KarpelesLab/odock/docs/images/odock-10-bottom.png

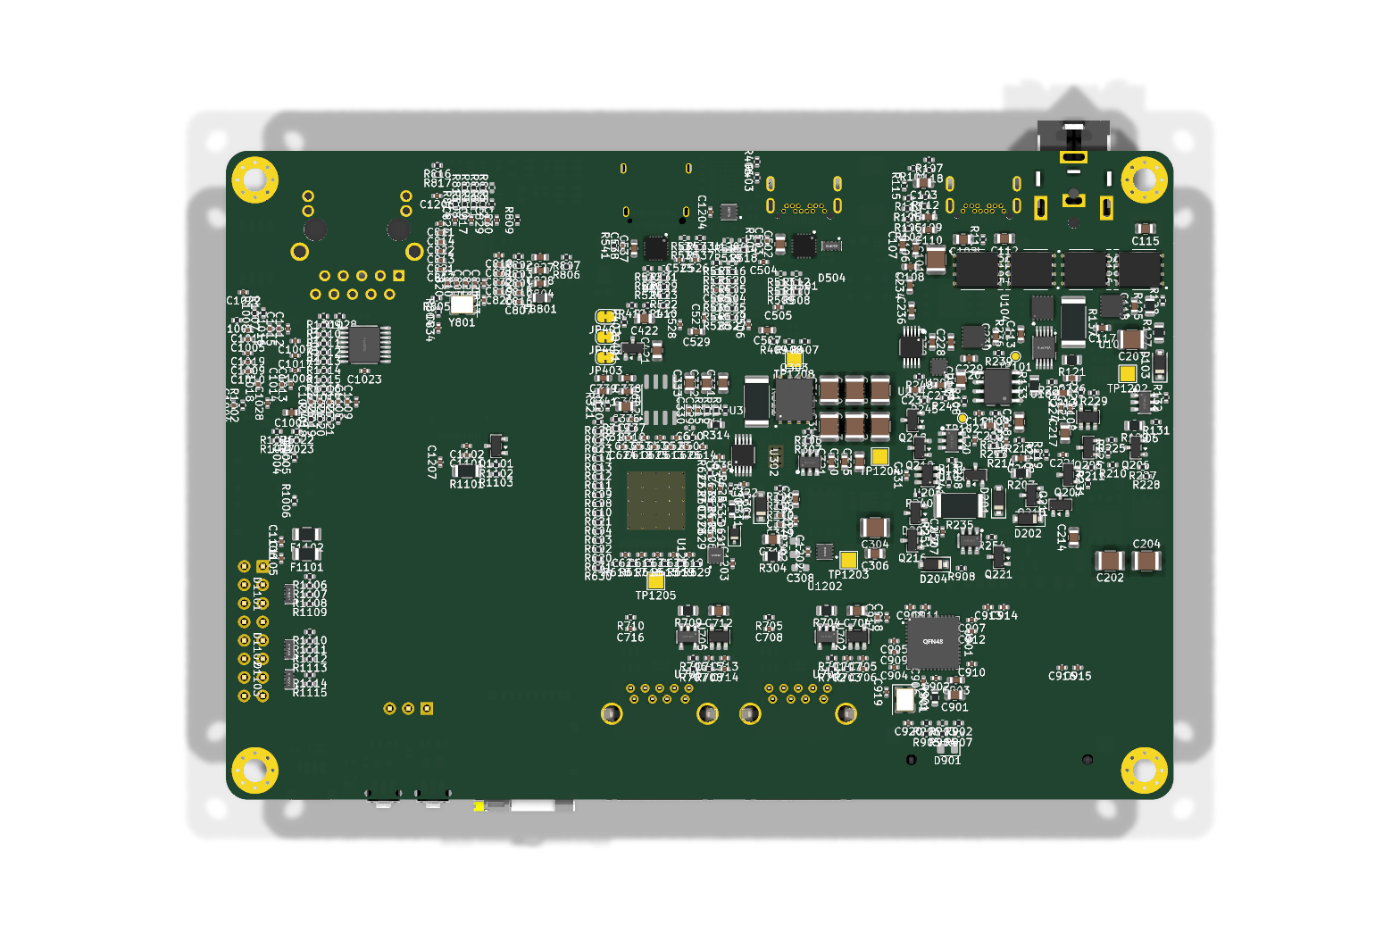
docs/images/odock-10-bottom.png
