KarpelesLab/odock/docs/images/odock-10-top.png

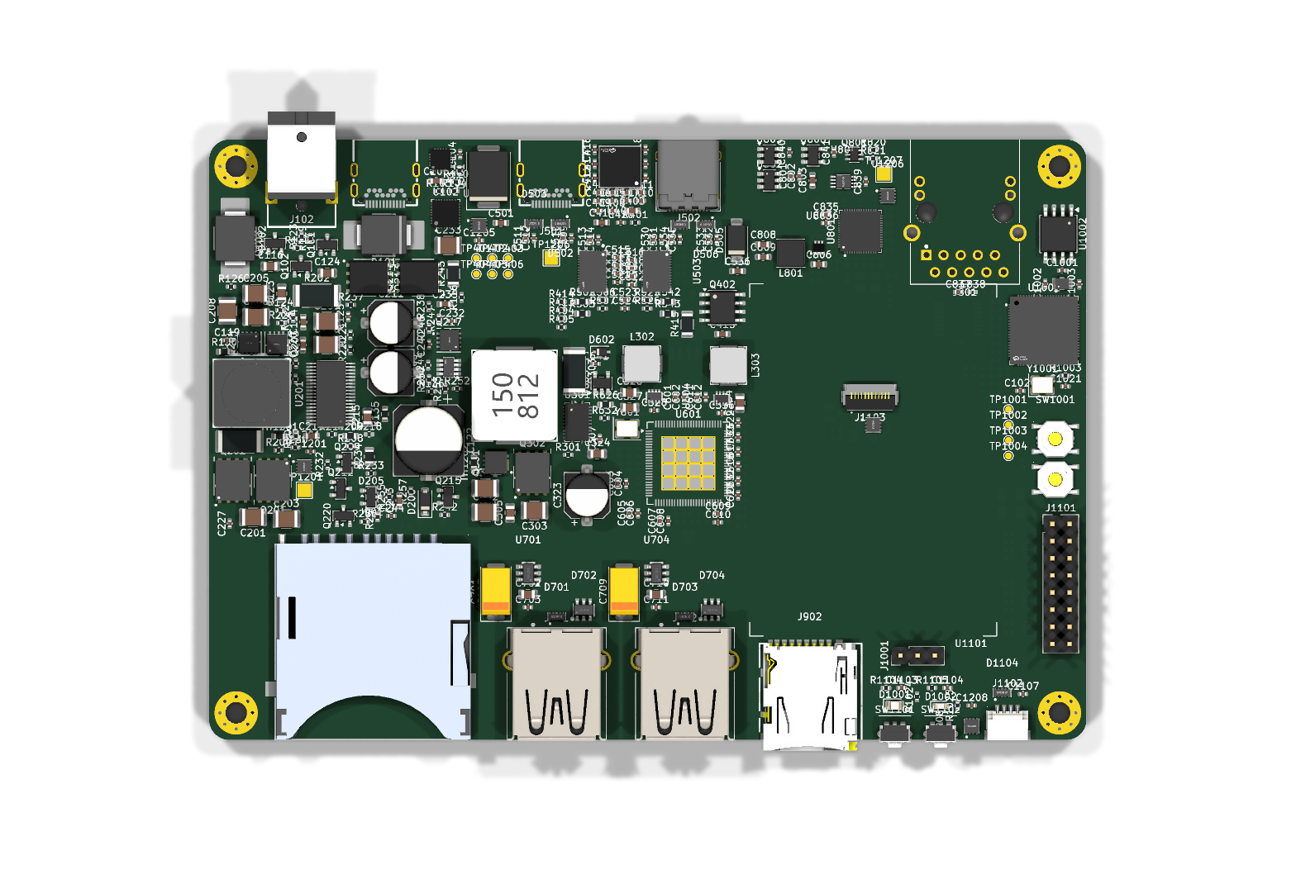
docs/images/odock-10-top.png
