KarpelesLab/odock/hardware/odock-10/odock-10.kicad_pcb

## KiCad design hardware/odock-10/odock-10.kicad_pcb (2026-10-17)

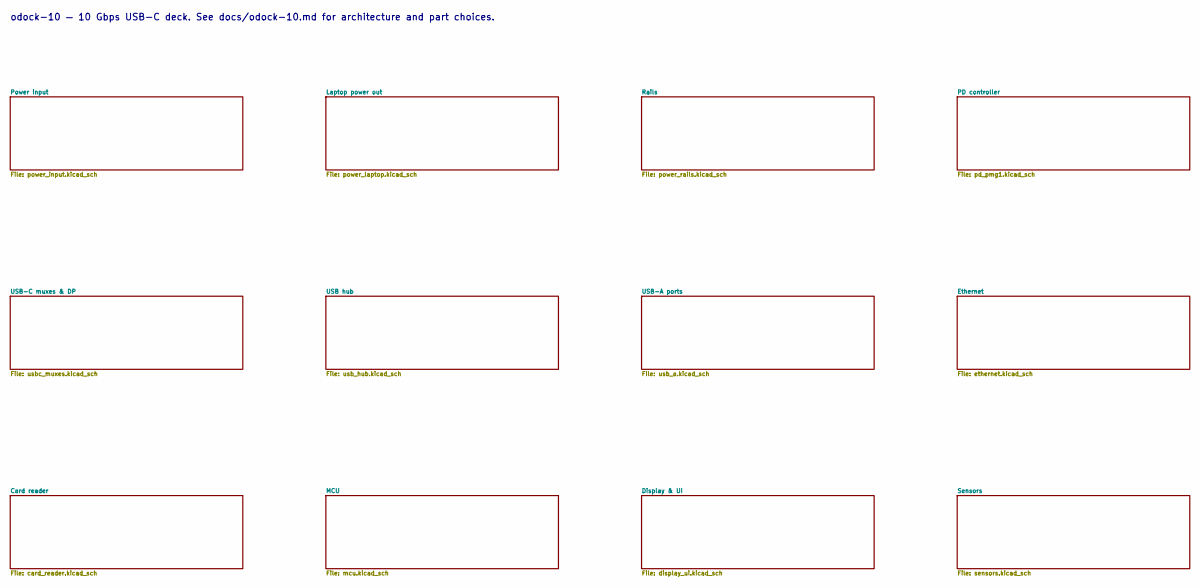
[picture p4: schematic odock-10.kicad_sch]

Notes on the sheet:
odock-10 — 10 Gbps USB-C deck. See docs/odock-10.md for architecture and part choices.

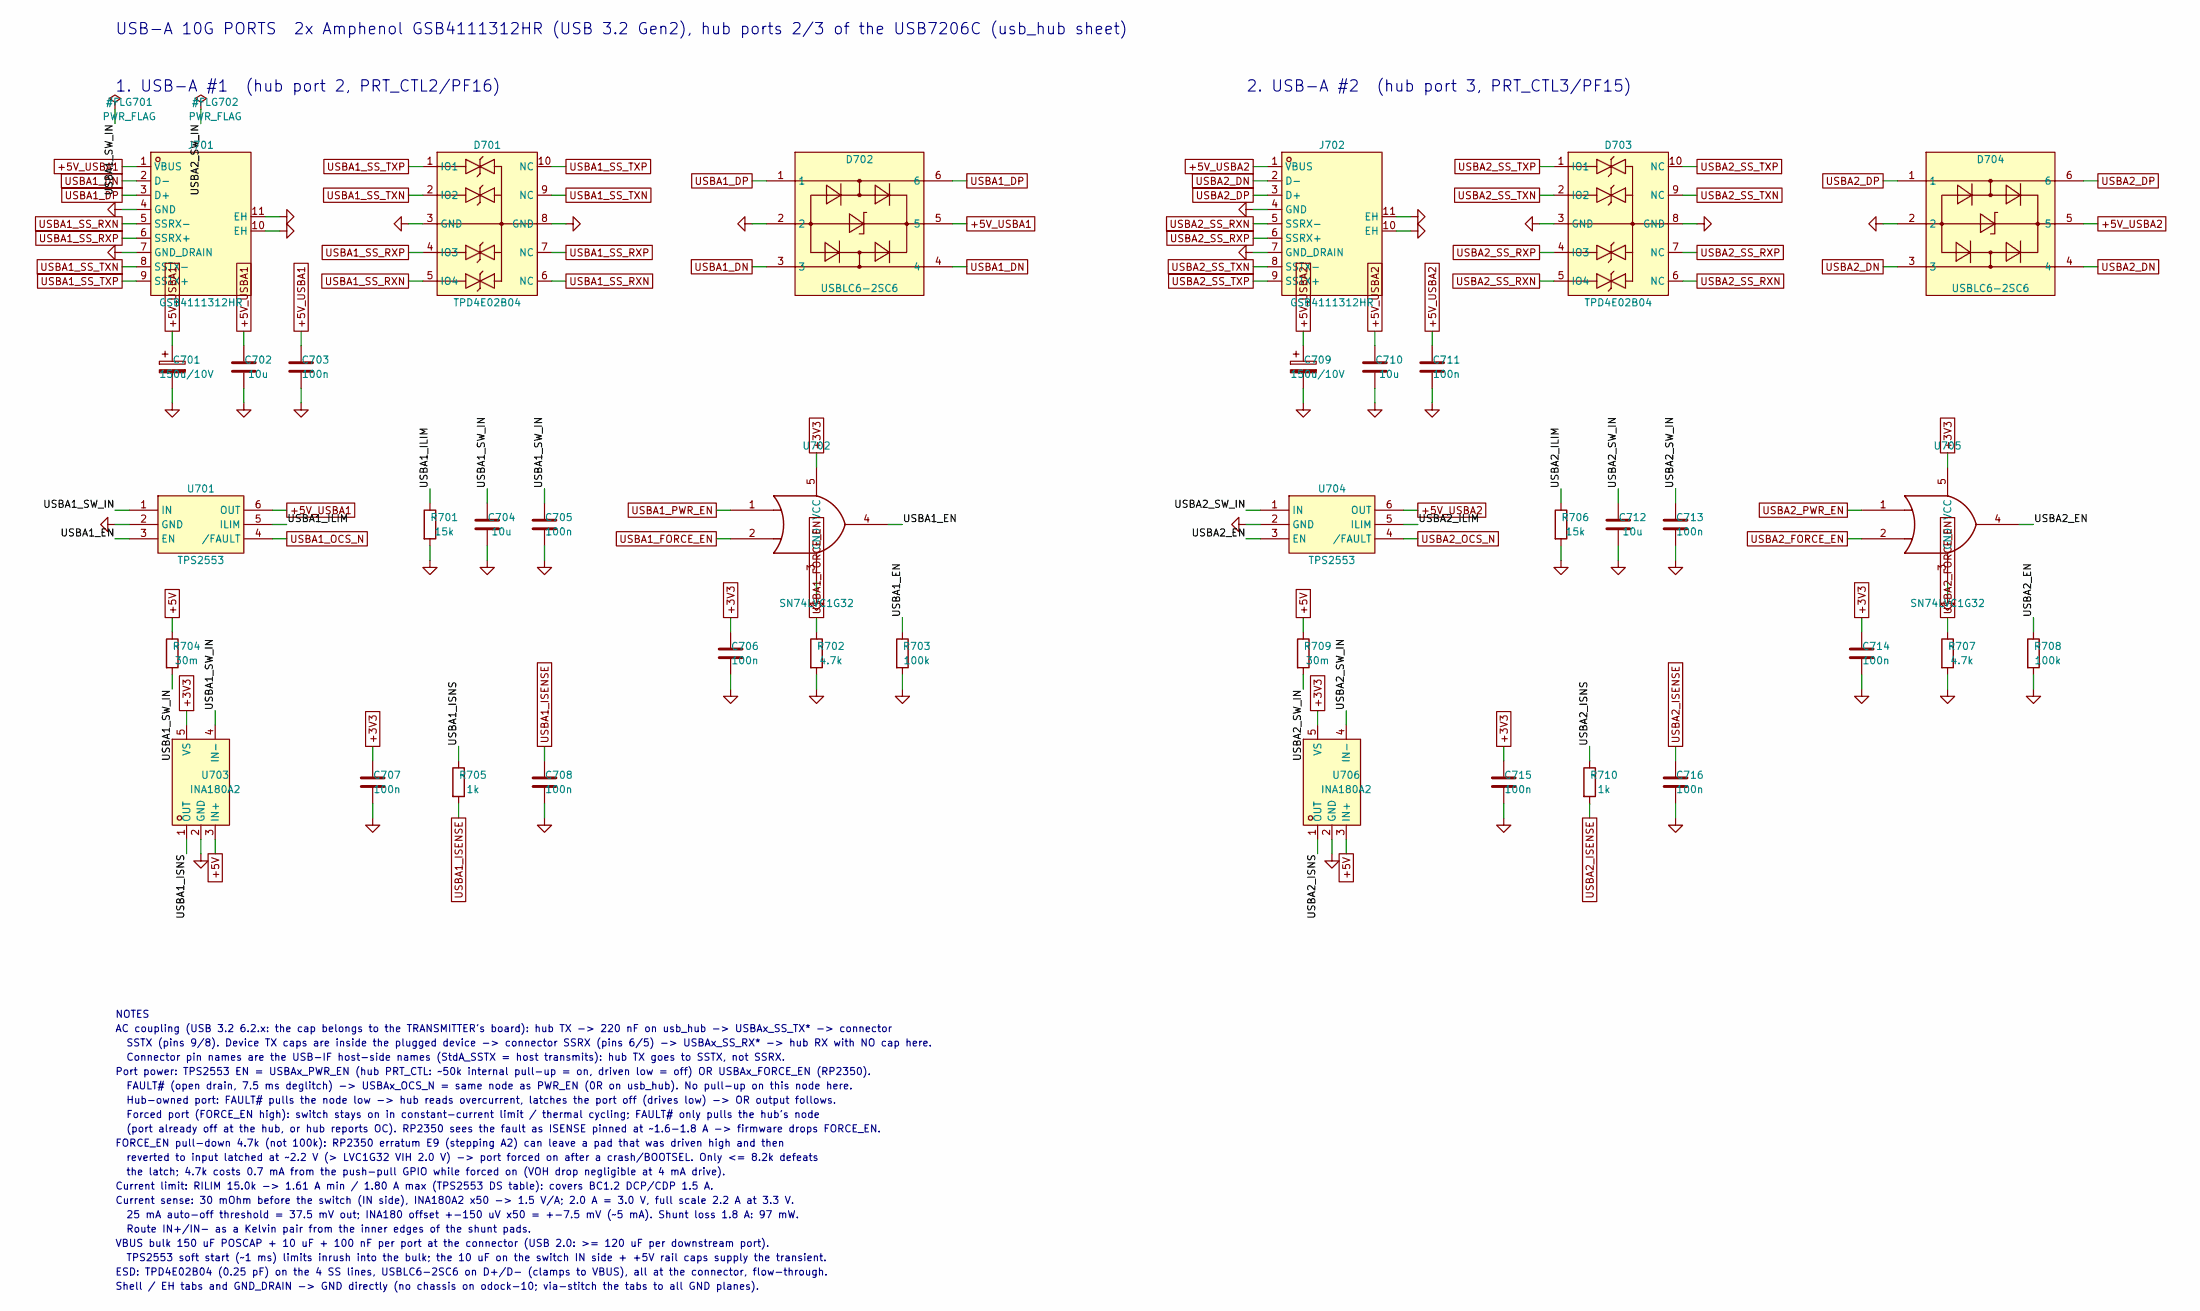
[picture p5: schematic usb_a.kicad_sch, odock-10 — USB-A 10 Gbps ports (2x), port power, current se…]

Parts:
C701, C709: 150u/10V; CP_EIA-7343-31_Kemet-D; LCSC C347559
C702, C704, C710, C712: 10u; C_0805_2012Metric; LCSC C15850
C703, C705, C706, C707, C708, C711, C713, C714, C715, C716: 100n; C_0402_1005Metric; LCSC C1525
D701, D703: TPD4E02B04; USON-10_L2.5-W1.0-P0.50-BL; MPN TPD4E02B04DQAR; LCSC C106794
D702, D704: USBLC6-2SC6; SOT-23-6_L2.9-W1.6-P0.95-LS2.8-BL; MPN USBLC6-2SC6; LCSC C7519
J701, J702: GSB4111312HR; USB-A_Amphenol_GSB4111312HR; MPN GSB4111312HR; LCSC C5429382
R701, R706: 15k; R_0402_1005Metric; LCSC C25756
R702, R707: 4.7k; R_0402_1005Metric; LCSC C25900
R703, R708: 100k; R_0402_1005Metric; LCSC C25741
R704, R709: 30m; R_0805_2012Metric; LCSC C858599
R705, R710: 1k; R_0402_1005Metric; LCSC C11702
U701, U704: TPS2553; SOT-23-6_L2.9-W1.6-P0.95-LS2.8-BR; MPN TPS2553DBVR; LCSC C55266
U702, U705: SN74LVC1G32; SOT-23-5; LCSC C10096
U703, U706: INA180A2; SOT-23-5_L3.0-W1.7-P0.95-LS2.8-BL; MPN INA180A2IDBVR; LCSC C192764

Connections:
+3V3: C706.1, C707.1, C714.1, C715.1, U702.5 (VCC), U703.5 (VS), U705.5 (VCC), U706.5 (VS); also elsewhere on the board
+5V: R704.1, R709.1, U703.3 (IN+), U706.3 (IN+); also elsewhere on the board
+5V_USBA1: C701.1, C702.1, C703.1, D702.5, J701.1 (VBUS), U701.6 (OUT)
+5V_USBA2: C709.1, C710.1, C711.1, D704.5, J702.1 (VBUS), U704.6 (OUT)
/USB-A ports/USBA1_EN: R703.1, U701.3 (EN), U702.4
/USB-A ports/USBA1_ILIM: R701.1, U701.5 (ILIM)
/USB-A ports/USBA1_ISNS: R705.1, U703.1 (OUT)
/USB-A ports/USBA1_SW_IN: C704.1, C705.1, R704.2, U701.1 (IN), U703.4 (IN-)
/USB-A ports/USBA2_EN: R708.1, U704.3 (EN), U705.4
/USB-A ports/USBA2_ILIM: R706.1, U704.5 (ILIM)
/USB-A ports/USBA2_ISNS: R710.1, U706.1 (OUT)
/USB-A ports/USBA2_SW_IN: C712.1, C713.1, R709.2, U704.1 (IN), U706.4 (IN-)
GND: C701.2, C702.2, C703.2, C704.2, C705.2, C706.2, C707.2, C708.2, C709.2, C710.2, C711.2, C712.2, C713.2, C714.2, C715.2, C716.2, D701.3 (GND), D701.8 (GND), D702.2, D703.3 (GND), D703.8 (GND), D704.2, J701.4 (GND), J701.7 (GND_DRAIN), J701.10 (EH), J701.11 (EH), J702.4 (GND), J702.7 (GND_DRAIN), J702.10 (EH), J702.11 (EH), R701.2, R702.2, R703.2, R706.2, R707.2, R708.2, U701.2 (GND), U702.3 (GND), U703.2 (GND), U704.2 (GND), U705.3 (GND), U706.2 (GND); also elsewhere on the board
USBA1_DN: D702.3, D702.4, J701.2 (D-); also elsewhere on the board
USBA1_DP: D702.1, D702.6, J701.3 (D+); also elsewhere on the board
USBA1_FORCE_EN: R702.1, U702.2; also elsewhere on the board
USBA1_ISENSE: C708.1, R705.2; also elsewhere on the board
USBA1_OCS_N: U701.4 (/FAULT); also elsewhere on the board
USBA1_PWR_EN: U702.1; also elsewhere on the board
USBA1_SS_RXN: D701.5 (IO4), D701.6 (NC), J701.5 (SSRX-); also elsewhere on the board
USBA1_SS_RXP: D701.4 (IO3), D701.7 (NC), J701.6 (SSRX+); also elsewhere on the board
USBA1_SS_TXN: D701.2 (IO2), D701.9 (NC), J701.8 (SSTX-); also elsewhere on the board
USBA1_SS_TXP: D701.1 (IO1), D701.10 (NC), J701.9 (SSTX+); also elsewhere on the board
USBA2_DN: D704.3, D704.4, J702.2 (D-); also elsewhere on the board
USBA2_DP: D704.1, D704.6, J702.3 (D+); also elsewhere on the board
USBA2_FORCE_EN: R707.1, U705.2; also elsewhere on the board
USBA2_ISENSE: C716.1, R710.2; also elsewhere on the board
USBA2_OCS_N: U704.4 (/FAULT); also elsewhere on the board
USBA2_PWR_EN: U705.1; also elsewhere on the board
USBA2_SS_RXN: D703.5 (IO4), D703.6 (NC), J702.5 (SSRX-); also elsewhere on the board
USBA2_SS_RXP: D703.4 (IO3), D703.7 (NC), J702.6 (SSRX+); also elsewhere on the board
USBA2_SS_TXN: D703.2 (IO2), D703.9 (NC), J702.8 (SSTX-); also elsewhere on the board
USBA2_SS_TXP: D703.1 (IO1), D703.10 (NC), J702.9 (SSTX+); also elsewhere on the board

Notes on the sheet:
USB-A 10G PORTS 2x Amphenol GSB4111312HR (USB 3.2 Gen2), hub ports 2/3 of the USB7206C (usb_hub sheet)
1. USB-A #1 (hub port 2, PRT_CTL2/PF16)
2. USB-A #2 (hub port 3, PRT_CTL3/PF15)
NOTES
AC coupling (USB 3.2 6.2.x: the cap belongs to the TRANSMITTER's board): hub TX -> 220 nF on usb_hub -> USBAx_SS_TX* -> connector
SSTX (pins 9/8). Device TX caps are inside the plugged device -> connector SSRX (pins 6/5) -> USBAx_SS_RX* -> hub RX with NO cap here.
Connector pin names are the USB-IF host-side names (StdA_SSTX = host transmits): hub TX goes to SSTX, not SSRX.
Port power: TPS2553 EN = USBAx_PWR_EN (hub PRT_CTL: ~50k internal pull-up = on, driven low = off) OR USBAx_FORCE_EN (RP2350).
FAULT# (open drain, 7.5 ms deglitch) -> USBAx_OCS_N = same node as PWR_EN (0R on usb_hub). No pull-up on this node here.
Hub-owned port: FAULT# pulls the node low -> hub reads overcurrent, latches the port off (drives low) -> OR output follows.
Forced port (FORCE_EN high): switch stays on in constant-current limit / thermal cycling; FAULT# only pulls the hub's node
(port already off at the hub, or hub reports OC). RP2350 sees the fault as ISENSE pinned at ~1.6-1.8 A -> firmware drops FORCE_EN.
FORCE_EN pull-down 4.7k (not 100k): RP2350 erratum E9 (stepping A2) can leave a pad that was driven high and then
reverted to input latched at ~2.2 V (> LVC1G32 VIH 2.0 V) -> port forced on after a crash/BOOTSEL. Only <= 8.2k defeats
the latch; 4.7k costs 0.7 mA from the push-pull GPIO while forced on (VOH drop negligible at 4 mA drive).
Current limit: RILIM 15.0k -> 1.61 A min / 1.80 A max (TPS2553 DS table): covers BC1.2 DCP/CDP 1.5 A.
Current sense: 30 mOhm before the switch (IN side), INA180A2 x50 -> 1.5 V/A; 2.0 A = 3.0 V, full scale 2.2 A at 3.3 V.
25 mA auto-off threshold = 37.5 mV out; INA180 offset +-150 uV x50 = +-7.5 mV (~5 mA). Shunt loss 1.8 A: 97 mW.
Route IN+/IN- as a Kelvin pair from the inner edges of the shunt pads.
VBUS bulk 150 uF POSCAP + 10 uF + 100 nF per port at the connector (USB 2.0: >= 120 uF per downstream port).
TPS2553 soft start (~1 ms) limits inrush into the bulk; the 10 uF on the switch IN side + +5V rail caps supply the transient.
ESD: TPD4E02B04 (0.25 pF) on the 4 SS lines, USBLC6-2SC6 on D+/D- (clamps to VBUS), all at the connector, flow-through.
Shell / EH tabs and GND_DRAIN -> GND directly (no chassis on odock-10; via-stitch the tabs to all GND planes).

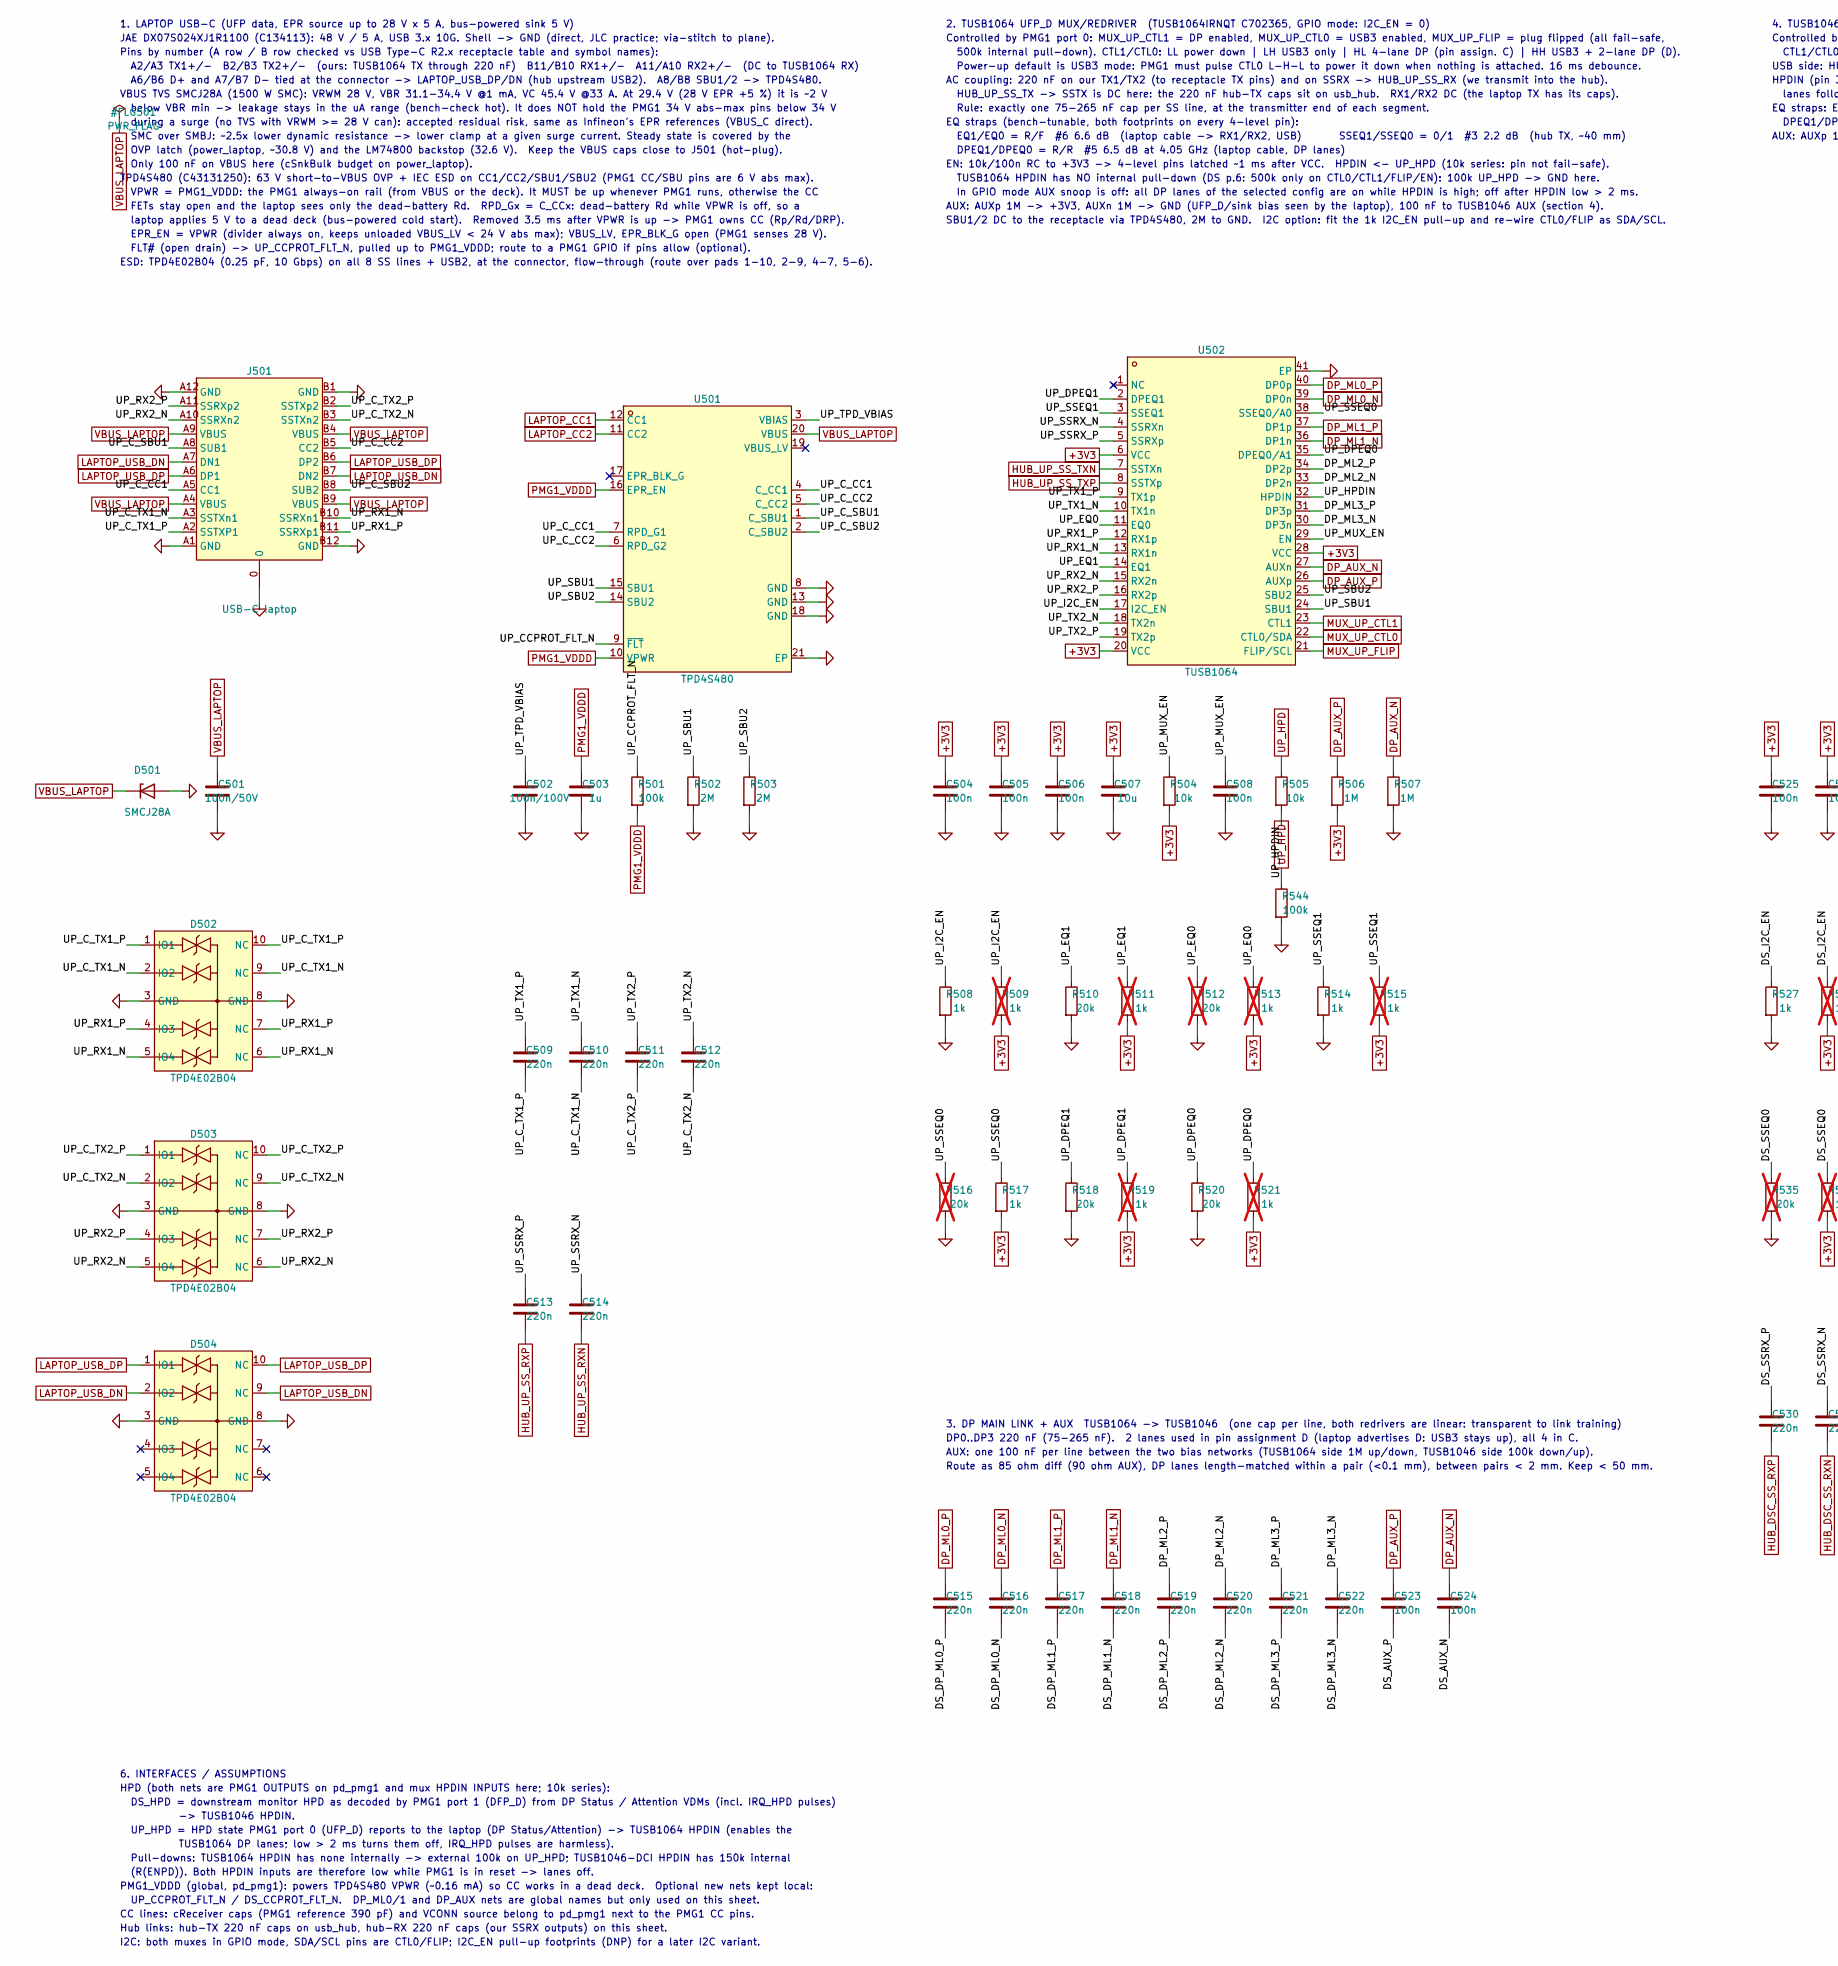
[picture p6: schematic usbc_muxes.kicad_sch, odock-10 — USB-C ports, TUSB1064 / TUSB1046 alt-mode muxes, part in row 1, column 1]

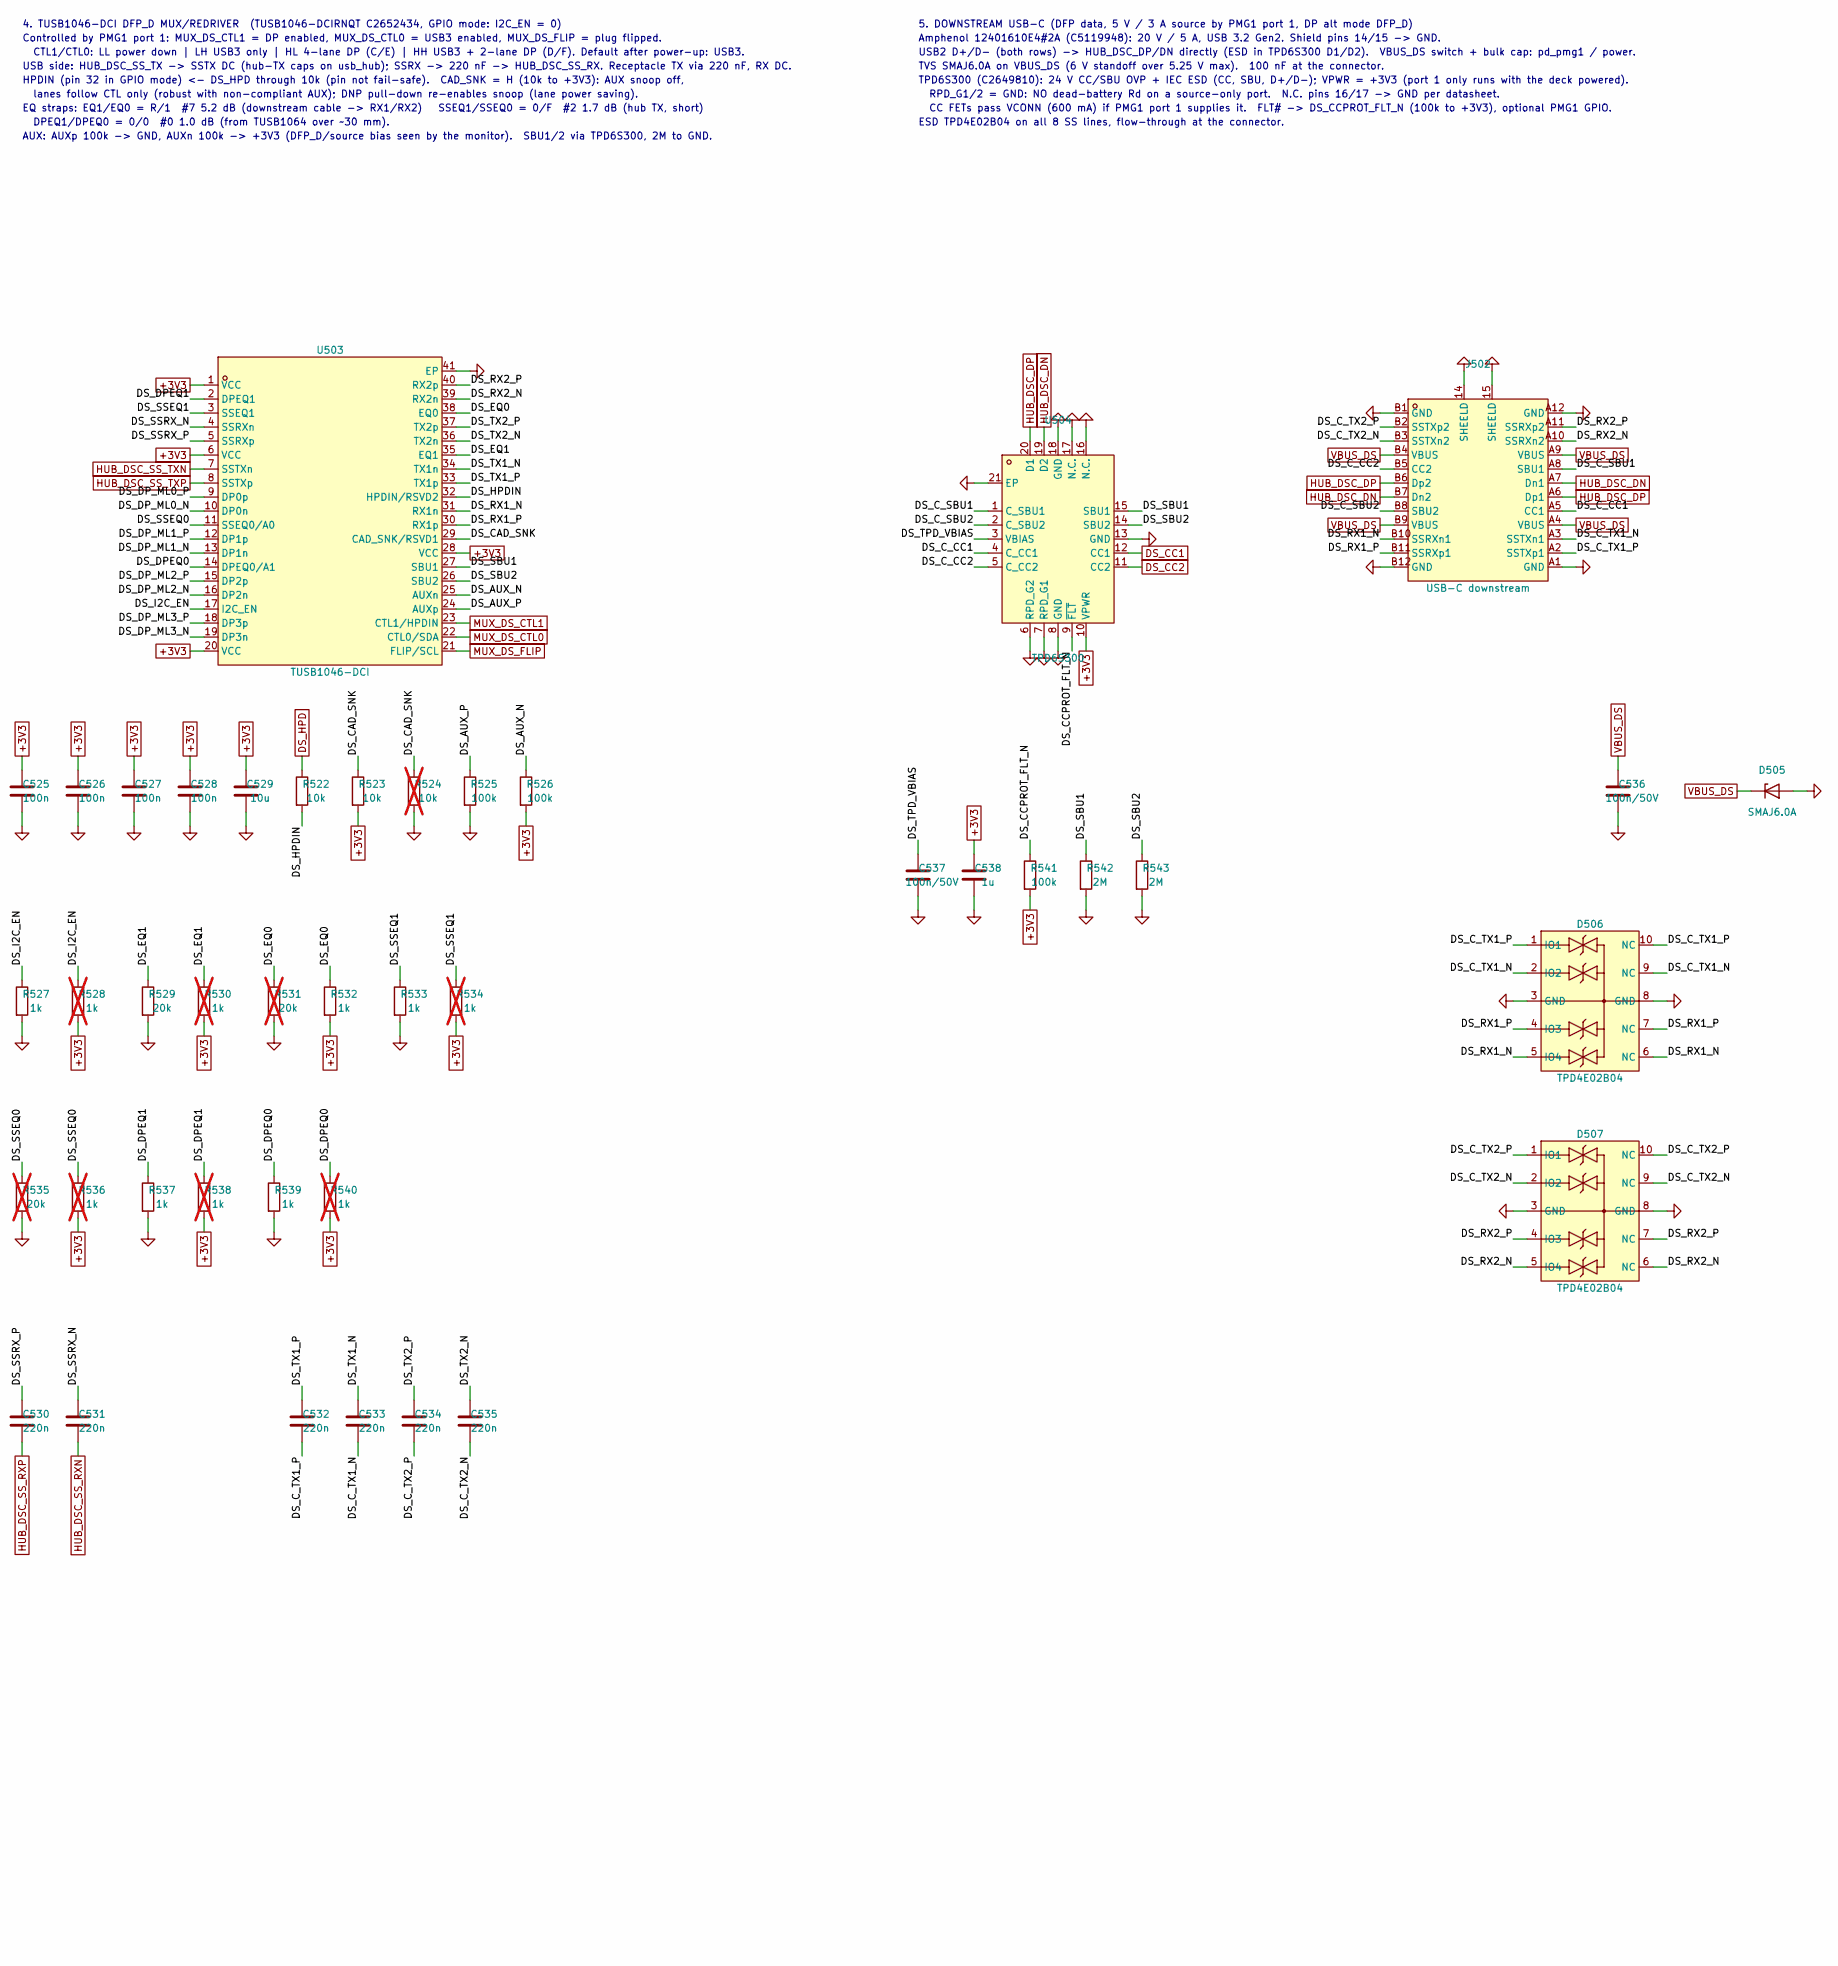
[picture p7: schematic usbc_muxes.kicad_sch, odock-10 — USB-C ports, TUSB1064 / TUSB1046 alt-mode muxes, part in row 1, column 2]

Parts:
C501, C536, C537: 100n/50V; C_0603_1608Metric; LCSC C14663
C502: 100n/100V; C_0805_2012Metric; LCSC C28233
C503, C538: 1u; C_0402_1005Metric; LCSC C52923
C504, C505, C506, C508, C523, C524, C525, C526, C527, C528: 100n; C_0402_1005Metric; LCSC C1525
C507, C529: 10u; C_0603_1608Metric; LCSC C19702
C509, C510, C511, C512, C513, C514, C515, C516, C517, C518, C519, C520, C521, C522, C530, C531, C532, C533, C534, C535: 220n; C_0402_1005Metric; LCSC C16772
D501: SMCJ28A; D_SMC; LCSC C224047
D502, D503, D504, D506, D507: TPD4E02B04; USON-10_L2.5-W1.0-P0.50-BL; MPN TPD4E02B04DQAR; LCSC C106794
D505: SMAJ6.0A; D_SMA; LCSC C364284
J501: USB-C laptop; USB-C-TH_DX07S024XJ1R1100-1; MPN DX07S024XJ1R1100; LCSC C134113
J502: USB-C downstream; USB-C-SMD_TYPE-C-24P; MPN 12401610E4#2A; LCSC C5119948
R501, R525, R526, R541, R544: 100k; R_0402_1005Metric; LCSC C25741
R502, R503, R542, R543: 2M; R_0603_1608Metric; LCSC C22976
R504, R505, R522, R523: 10k; R_0402_1005Metric; LCSC C25744
R506, R507: 1M; R_0402_1005Metric; LCSC C26083
R508, R514, R517, R527, R532, R533, R537, R539: 1k; R_0402_1005Metric; LCSC C11702
R509, R511, R513, R515, R519, R521, R528, R530, R534, R536, R538, R540: 1k; R_0402_1005Metric; LCSC C11702; not fitted
R510, R518, R520, R529: 20k; R_0402_1005Metric; LCSC C25765
R512, R516, R531, R535: 20k; R_0402_1005Metric; LCSC C25765; not fitted
R524: 10k; R_0402_1005Metric; LCSC C25744; not fitted
U501: TPD4S480; WQFN-20_L3.0-W3.0-P0.40-BL-EP1.7; MPN TPD4S480RUKR; LCSC C43131250
U502: TUSB1064; WQFN-40_L6.0-W4.0-P0.40-TL-EP; MPN TUSB1064IRNQT; LCSC C702365
U503: TUSB1046-DCI; WQFN-40_L6.0-W4.0-P0.40-TL-EP; MPN TUSB1046-DCIRNQT; LCSC C2652434
U504: TPD6S300; WQFN-20_L3.0-W3.0-P0.40-BL-EP1.7; MPN TPD6S300RUKR; LCSC C2649810

Connections:
+3V3: C504.1, C505.1, C506.1, C507.1, C525.1, C526.1, C527.1, C528.1, C529.1, C538.1, R504.2, R506.2, R509.2, R511.2, R513.2, R515.2, R517.2, R519.2, R521.2, R523.2, R526.2, R528.2, R530.2, R532.2, R534.2, R536.2, R538.2, R540.2, R541.2, U502.6 (VCC), U502.20 (VCC), U502.28 (VCC), U503.1 (VCC), U503.6 (VCC), U503.20 (VCC), U503.28 (VCC), U504.10 (VPWR); also elsewhere on the board
/USB-C muxes & DP/DP_ML2_N: C520.1, U502.33 (DP2n)
/USB-C muxes & DP/DP_ML2_P: C519.1, U502.34 (DP2p)
/USB-C muxes & DP/DP_ML3_N: C522.1, U502.30 (DP3n)
/USB-C muxes & DP/DP_ML3_P: C521.1, U502.31 (DP3p)
/USB-C muxes & DP/DS_AUX_N: C524.2, R526.1, U503.25 (AUXn)
/USB-C muxes & DP/DS_AUX_P: C523.2, R525.1, U503.24 (AUXp)
/USB-C muxes & DP/DS_CAD_SNK: R523.1, R524.1, U503.29 (CAD_SNK/RSVD1)
/USB-C muxes & DP/DS_CCPROT_FLT_N: R541.1, U504.9 (~FLT)
/USB-C muxes & DP/DS_C_CC1: J502.A5 (CC1), U504.4 (C_CC1)
/USB-C muxes & DP/DS_C_CC2: J502.B5 (CC2), U504.5 (C_CC2)
/USB-C muxes & DP/DS_C_SBU1: J502.A8 (SBU1), U504.1 (C_SBU1)
/USB-C muxes & DP/DS_C_SBU2: J502.B8 (SBU2), U504.2 (C_SBU2)
/USB-C muxes & DP/DS_C_TX1_N: C533.2, D506.2 (IO2), D506.9 (NC), J502.A3 (SSTXn1)
/USB-C muxes & DP/DS_C_TX1_P: C532.2, D506.1 (IO1), D506.10 (NC), J502.A2 (SSTXp1)
/USB-C muxes & DP/DS_C_TX2_N: C535.2, D507.2 (IO2), D507.9 (NC), J502.B3 (SSTXn2)
/USB-C muxes & DP/DS_C_TX2_P: C534.2, D507.1 (IO1), D507.10 (NC), J502.B2 (SSTXp2)
/USB-C muxes & DP/DS_DPEQ0: R539.1, R540.1, U503.14 (DPEQ0/A1)
/USB-C muxes & DP/DS_DPEQ1: R537.1, R538.1, U503.2 (DPEQ1)
/USB-C muxes & DP/DS_DP_ML0_N: C516.2, U503.10 (DP0n)
/USB-C muxes & DP/DS_DP_ML0_P: C515.2, U503.9 (DP0p)
/USB-C muxes & DP/DS_DP_ML1_N: C518.2, U503.13 (DP1n)
/USB-C muxes & DP/DS_DP_ML1_P: C517.2, U503.12 (DP1p)
/USB-C muxes & DP/DS_DP_ML2_N: C520.2, U503.16 (DP2n)
/USB-C muxes & DP/DS_DP_ML2_P: C519.2, U503.15 (DP2p)
/USB-C muxes & DP/DS_DP_ML3_N: C522.2, U503.19 (DP3n)
/USB-C muxes & DP/DS_DP_ML3_P: C521.2, U503.18 (DP3p)
/USB-C muxes & DP/DS_EQ0: R531.1, R532.1, U503.38 (EQ0)
/USB-C muxes & DP/DS_EQ1: R529.1, R530.1, U503.35 (EQ1)
/USB-C muxes & DP/DS_HPDIN: R522.2, U503.32 (HPDIN/RSVD2)
/USB-C muxes & DP/DS_I2C_EN: R527.1, R528.1, U503.17 (I2C_EN)
/USB-C muxes & DP/DS_RX1_N: D506.5 (IO4), D506.6 (NC), J502.B10 (SSRXn1), U503.31 (RX1n)
/USB-C muxes & DP/DS_RX1_P: D506.4 (IO3), D506.7 (NC), J502.B11 (SSRXp1), U503.30 (RX1p)
/USB-C muxes & DP/DS_RX2_N: D507.5 (IO4), D507.6 (NC), J502.A10 (SSRXn2), U503.39 (RX2n)
/USB-C muxes & DP/DS_RX2_P: D507.4 (IO3), D507.7 (NC), J502.A11 (SSRXp2), U503.40 (RX2p)
/USB-C muxes & DP/DS_SBU1: R542.1, U503.27 (SBU1), U504.15 (SBU1)
/USB-C muxes & DP/DS_SBU2: R543.1, U503.26 (SBU2), U504.14 (SBU2)
/USB-C muxes & DP/DS_SSEQ0: R535.1, R536.1, U503.11 (SSEQ0/A0)
/USB-C muxes & DP/DS_SSEQ1: R533.1, R534.1, U503.3 (SSEQ1)
/USB-C muxes & DP/DS_SSRX_N: C531.1, U503.4 (SSRXn)
/USB-C muxes & DP/DS_SSRX_P: C530.1, U503.5 (SSRXp)
/USB-C muxes & DP/DS_TPD_VBIAS: C537.1, U504.3 (VBIAS)
/USB-C muxes & DP/DS_TX1_N: C533.1, U503.34 (TX1n)
/USB-C muxes & DP/DS_TX1_P: C532.1, U503.33 (TX1p)
/USB-C muxes & DP/DS_TX2_N: C535.1, U503.36 (TX2n)
/USB-C muxes & DP/DS_TX2_P: C534.1, U503.37 (TX2p)
/USB-C muxes & DP/UP_CCPROT_FLT_N: R501.1, U501.9 (~FLT)
/USB-C muxes & DP/UP_C_CC1: J501.A5 (CC1), U501.4 (C_CC1), U501.7 (RPD_G1)
/USB-C muxes & DP/UP_C_CC2: J501.B5 (CC2), U501.5 (C_CC2), U501.6 (RPD_G2)
/USB-C muxes & DP/UP_C_SBU1: J501.A8 (SUB1), U501.1 (C_SBU1)
/USB-C muxes & DP/UP_C_SBU2: J501.B8 (SUB2), U501.2 (C_SBU2)
/USB-C muxes & DP/UP_C_TX1_N: C510.2, D502.2 (IO2), D502.9 (NC), J501.A3 (SSTXn1)
/USB-C muxes & DP/UP_C_TX1_P: C509.2, D502.1 (IO1), D502.10 (NC), J501.A2 (SSTXP1)
/USB-C muxes & DP/UP_C_TX2_N: C512.2, D503.2 (IO2), D503.9 (NC), J501.B3 (SSTXn2)
/USB-C muxes & DP/UP_C_TX2_P: C511.2, D503.1 (IO1), D503.10 (NC), J501.B2 (SSTXp2)
/USB-C muxes & DP/UP_DPEQ0: R520.1, R521.1, U502.35 (DPEQ0/A1)
/USB-C muxes & DP/UP_DPEQ1: R518.1, R519.1, U502.2 (DPEQ1)
/USB-C muxes & DP/UP_EQ0: R512.1, R513.1, U502.11 (EQ0)
/USB-C muxes & DP/UP_EQ1: R510.1, R511.1, U502.14 (EQ1)
/USB-C muxes & DP/UP_HPDIN: R505.2, U502.32 (HPDIN)
/USB-C muxes & DP/UP_I2C_EN: R508.1, R509.1, U502.17 (I2C_EN)
/USB-C muxes & DP/UP_MUX_EN: C508.1, R504.1, U502.29 (EN)
/USB-C muxes & DP/UP_RX1_N: D502.5 (IO4), D502.6 (NC), J501.B10 (SSRXn1), U502.13 (RX1n)
/USB-C muxes & DP/UP_RX1_P: D502.4 (IO3), D502.7 (NC), J501.B11 (SSRXp1), U502.12 (RX1p)
/USB-C muxes & DP/UP_RX2_N: D503.5 (IO4), D503.6 (NC), J501.A10 (SSRXn2), U502.15 (RX2n)
/USB-C muxes & DP/UP_RX2_P: D503.4 (IO3), D503.7 (NC), J501.A11 (SSRXp2), U502.16 (RX2p)
/USB-C muxes & DP/UP_SBU1: R502.1, U501.15 (SBU1), U502.24 (SBU1)
/USB-C muxes & DP/UP_SBU2: R503.1, U501.14 (SBU2), U502.25 (SBU2)
/USB-C muxes & DP/UP_SSEQ0: R516.1, R517.1, U502.38 (SSEQ0/A0)
/USB-C muxes & DP/UP_SSEQ1: R514.1, R515.1, U502.3 (SSEQ1)
/USB-C muxes & DP/UP_SSRX_N: C514.1, U502.4 (SSRXn)
/USB-C muxes & DP/UP_SSRX_P: C513.1, U502.5 (SSRXp)
/USB-C muxes & DP/UP_TPD_VBIAS: C502.1, U501.3 (VBIAS)
/USB-C muxes & DP/UP_TX1_N: C510.1, U502.10 (TX1n)
/USB-C muxes & DP/UP_TX1_P: C509.1, U502.9 (TX1p)
/USB-C muxes & DP/UP_TX2_N: C512.1, U502.18 (TX2n)
/USB-C muxes & DP/UP_TX2_P: C511.1, U502.19 (TX2p)
DP_AUX_N: C524.1, R507.1, U502.27 (AUXn)
DP_AUX_P: C523.1, R506.1, U502.26 (AUXp)
DP_ML0_N: C516.1, U502.39 (DP0n)
DP_ML0_P: C515.1, U502.40 (DP0p)
DP_ML1_N: C518.1, U502.36 (DP1n)
DP_ML1_P: C517.1, U502.37 (DP1p)
DS_CC1: U504.12 (CC1); also elsewhere on the board
DS_CC2: U504.11 (CC2); also elsewhere on the board
DS_HPD: R522.1; also elsewhere on the board
GND: C501.2, C502.2, C503.2, C504.2, C505.2, C506.2, C507.2, C508.2, C525.2, C526.2, C527.2, C528.2, C529.2, C536.2, C537.2, C538.2, D501.2 (A), D502.3 (GND), D502.8 (GND), D503.3 (GND), D503.8 (GND), D504.3 (GND), D504.8 (GND), D505.2 (A), D506.3 (GND), D506.8 (GND), D507.3 (GND), D507.8 (GND), J501.0, J501.A1 (GND), J501.A12 (GND), J501.B1 (GND), J501.B12 (GND), J502.14 (SHEELD), J502.15 (SHEELD), J502.A1 (GND), J502.A12 (GND), J502.B1 (GND), J502.B12 (GND), R502.2, R503.2, R507.2, R508.2, R510.2, R512.2, R514.2, R516.2, R518.2, R520.2, R524.2, R525.2, R527.2, R529.2, R531.2, R533.2, R535.2, R537.2, R539.2, R542.2, R543.2, R544.2, U501.8 (GND), U501.13 (GND), U501.18 (GND), U501.21 (EP), U502.41 (EP), U503.41 (EP), U504.6 (RPD_G2), U504.7 (RPD_G1), U504.8 (GND), U504.13 (GND), U504.16 (N.C.), U504.17 (N.C.), U504.18 (GND), U504.21 (EP); also elsewhere on the board
HUB_DSC_DN: J502.A7 (Dn1), J502.B7 (Dn2), U504.19 (D2); also elsewhere on the board
HUB_DSC_DP: J502.A6 (Dp1), J502.B6 (Dp2), U504.20 (D1); also elsewhere on the board
HUB_DSC_SS_RXN: C531.2; also elsewhere on the board
HUB_DSC_SS_RXP: C530.2; also elsewhere on the board
HUB_DSC_SS_TXN: U503.7 (SSTXn); also elsewhere on the board
HUB_DSC_SS_TXP: U503.8 (SSTXp); also elsewhere on the board
HUB_UP_SS_RXN: C514.2; also elsewhere on the board
HUB_UP_SS_RXP: C513.2; also elsewhere on the board
HUB_UP_SS_TXN: U502.7 (SSTXn); also elsewhere on the board
HUB_UP_SS_TXP: U502.8 (SSTXp); also elsewhere on the board
LAPTOP_CC1: U501.12 (CC1); also elsewhere on the board
LAPTOP_CC2: U501.11 (CC2); also elsewhere on the board
LAPTOP_USB_DN: D504.2 (IO2), D504.9 (NC), J501.A7 (DN1), J501.B7 (DN2); also elsewhere on the board
LAPTOP_USB_DP: D504.1 (IO1), D504.10 (NC), J501.A6 (DP1), J501.B6 (DP2); also elsewhere on the board
MUX_DS_CTL0: U503.22 (CTL0/SDA); also elsewhere on the board
MUX_DS_CTL1: U503.23 (CTL1/HPDIN); also elsewhere on the board
MUX_DS_FLIP: U503.21 (FLIP/SCL); also elsewhere on the board
MUX_UP_CTL0: U502.22 (CTL0/SDA); also elsewhere on the board
MUX_UP_CTL1: U502.23 (CTL1); also elsewhere on the board
MUX_UP_FLIP: U502.21 (FLIP/SCL); also elsewhere on the board
PMG1_VDDD: C503.1, R501.2, U501.10 (VPWR), U501.16 (EPR_EN); also elsewhere on the board
UP_HPD: R505.1, R544.1; also elsewhere on the board
VBUS_DS: C536.1, D505.1 (K), J502.A4 (VBUS), J502.A9 (VBUS), J502.B4 (VBUS), J502.B9 (VBUS); also elsewhere on the board
VBUS_LAPTOP: C501.1, D501.1 (K), J501.A4 (VBUS), J501.A9 (VBUS), J501.B4 (VBUS), J501.B9 (VBUS), U501.20 (VBUS); also elsewhere on the board

Notes on the sheet:
1. LAPTOP USB-C (UFP data, EPR source up to 28 V x 5 A, bus-powered sink 5 V)
JAE DX07S024XJ1R1100 (C134113): 48 V / 5 A, USB 3.x 10G. Shell -> GND (direct, JLC practice; via-stitch to plane).
Pins by number (A row / B row checked vs USB Type-C R2.x receptacle table and symbol names):
A2/A3 TX1+/- B2/B3 TX2+/- (ours: TUSB1064 TX through 220 nF) B11/B10 RX1+/- A11/A10 RX2+/- (DC to TUSB1064 RX)
A6/B6 D+ and A7/B7 D- tied at the connector -> LAPTOP_USB_DP/DN (hub upstream USB2). A8/B8 SBU1/2 -> TPD4S480.
VBUS TVS SMCJ28A (1500 W SMC): VRWM 28 V, VBR 31.1-34.4 V @1 mA, VC 45.4 V @33 A. At 29.4 V (28 V EPR +5 %) it is ~2 V
below VBR min -> leakage stays in the uA range (bench-check hot). It does NOT hold the PMG1 34 V abs-max pins below 34 V
during a surge (no TVS with VRWM >= 28 V can): accepted residual risk, same as Infineon's EPR references (VBUS_C direct).
SMC over SMBJ: ~2.5x lower dynamic resistance -> lower clamp at a given surge current. Steady state is covered by the
OVP latch (power_laptop, ~30.8 V) and the LM74800 backstop (32.6 V). Keep the VBUS caps close to J501 (hot-plug).
Only 100 nF on VBUS here (cSnkBulk budget on power_laptop).
TPD4S480 (C43131250): 63 V short-to-VBUS OVP + IEC ESD on CC1/CC2/SBU1/SBU2 (PMG1 CC/SBU pins are 6 V abs max).
VPWR = PMG1_VDDD: the PMG1 always-on rail (from VBUS or the deck). It MUST be up whenever PMG1 runs, otherwise the CC
FETs stay open and the laptop sees only the dead-battery Rd. RPD_Gx = C_CCx: dead-battery Rd while VPWR is off, so a
laptop applies 5 V to a dead deck (bus-powered cold start). Removed 3.5 ms after VPWR is up -> PMG1 owns CC (Rp/Rd/DRP).
EPR_EN = VPWR (divider always on, keeps unloaded VBUS_LV < 24 V abs max); VBUS_LV, EPR_BLK_G open (PMG1 senses 28 V).
FLT# (open drain) -> UP_CCPROT_FLT_N, pulled up to PMG1_VDDD; route to a PMG1 GPIO if pins allow (optional).
ESD: TPD4E02B04 (0.25 pF, 10 Gbps) on all 8 SS lines + USB2, at the connector, flow-through (route over pads 1-10, 2-9, 4-7, 5-6).
2. TUSB1064 UFP_D MUX/REDRIVER (TUSB1064IRNQT C702365, GPIO mode: I2C_EN = 0)
Controlled by PMG1 port 0: MUX_UP_CTL1 = DP enabled, MUX_UP_CTL0 = USB3 enabled, MUX_UP_FLIP = plug flipped (all fail-safe,
500k internal pull-down). CTL1/CTL0: LL power down | LH USB3 only | HL 4-lane DP (pin assign. C) | HH USB3 + 2-lane DP (D).
Power-up default is USB3 mode: PMG1 must pulse CTL0 L-H-L to power it down when nothing is attached. 16 ms debounce.
AC coupling: 220 nF on our TX1/TX2 (to receptacle TX pins) and on SSRX -> HUB_UP_SS_RX (we transmit into the hub).
HUB_UP_SS_TX -> SSTX is DC here: the 220 nF hub-TX caps sit on usb_hub. RX1/RX2 DC (the laptop TX has its caps).
Rule: exactly one 75-265 nF cap per SS line, at the transmitter end of each segment.
EQ straps (bench-tunable, both footprints on every 4-level pin):
EQ1/EQ0 = R/F #6 6.6 dB (laptop cable -> RX1/RX2, USB) SSEQ1/SSEQ0 = 0/1 #3 2.2 dB (hub TX, ~40 mm)
DPEQ1/DPEQ0 = R/R #5 6.5 dB at 4.05 GHz (laptop cable, DP lanes)
EN: 10k/100n RC to +3V3 -> 4-level pins latched ~1 ms after VCC. HPDIN <- UP_HPD (10k series: pin not fail-safe).
TUSB1064 HPDIN has NO internal pull-down (DS p.6: 500k only on CTL0/CTL1/FLIP/EN): 100k UP_HPD -> GND here.
In GPIO mode AUX snoop is off: all DP lanes of the selected config are on while HPDIN is high; off after HPDIN low > 2 ms.
AUX: AUXp 1M -> +3V3, AUXn 1M -> GND (UFP_D/sink bias seen by the laptop), 100 nF to TUSB1046 AUX (section 4).
SBU1/2 DC to the receptacle via TPD4S480, 2M to GND. I2C option: fit the 1k I2C_EN pull-up and re-wire CTL0/FLIP as SDA/SCL.
3. DP MAIN LINK + AUX TUSB1064 -> TUSB1046 (one cap per line, both redrivers are linear: transparent to link training)
DP0..DP3 220 nF (75-265 nF). 2 lanes used in pin assignment D (laptop advertises D: USB3 stays up), all 4 in C.
AUX: one 100 nF per line between the two bias networks (TUSB1064 side 1M up/down, TUSB1046 side 100k down/up).
Route as 85 ohm diff (90 ohm AUX), DP lanes length-matched within a pair (<0.1 mm), between pairs < 2 mm. Keep < 50 mm.
4. TUSB1046-DCI DFP_D MUX/REDRIVER (TUSB1046-DCIRNQT C2652434, GPIO mode: I2C_EN = 0)
Controlled by PMG1 port 1: MUX_DS_CTL1 = DP enabled, MUX_DS_CTL0 = USB3 enabled, MUX_DS_FLIP = plug flipped.
CTL1/CTL0: LL power down | LH USB3 only | HL 4-lane DP (C/E) | HH USB3 + 2-lane DP (D/F). Default after power-up: USB3.
USB side: HUB_DSC_SS_TX -> SSTX DC (hub-TX caps on usb_hub); SSRX -> 220 nF -> HUB_DSC_SS_RX. Receptacle TX via 220 nF, RX DC.
HPDIN (pin 32 in GPIO mode) <- DS_HPD through 10k (pin not fail-safe). CAD_SNK = H (10k to +3V3): AUX snoop off,
lanes follow CTL only (robust with non-compliant AUX); DNP pull-down re-enables snoop (lane power saving).
EQ straps: EQ1/EQ0 = R/1 #7 5.2 dB (downstream cable -> RX1/RX2) SSEQ1/SSEQ0 = 0/F #2 1.7 dB (hub TX, short)
DPEQ1/DPEQ0 = 0/0 #0 1.0 dB (from TUSB1064 over ~30 mm).
AUX: AUXp 100k -> GND, AUXn 100k -> +3V3 (DFP_D/source bias seen by the monitor). SBU1/2 via TPD6S300, 2M to GND.
5. DOWNSTREAM USB-C (DFP data, 5 V / 3 A source by PMG1 port 1, DP alt mode DFP_D)
Amphenol 12401610E4#2A (C5119948): 20 V / 5 A, USB 3.2 Gen2. Shield pins 14/15 -> GND.
USB2 D+/D- (both rows) -> HUB_DSC_DP/DN directly (ESD in TPD6S300 D1/D2). VBUS_DS switch + bulk cap: pd_pmg1 / power.
TVS SMAJ6.0A on VBUS_DS (6 V standoff over 5.25 V max). 100 nF at the connector.
TPD6S300 (C2649810): 24 V CC/SBU OVP + IEC ESD (CC, SBU, D+/D-); VPWR = +3V3 (port 1 only runs with the deck powered).
RPD_G1/2 = GND: NO dead-battery Rd on a source-only port. N.C. pins 16/17 -> GND per datasheet.
CC FETs pass VCONN (600 mA) if PMG1 port 1 supplies it. FLT# -> DS_CCPROT_FLT_N (100k to +3V3), optional PMG1 GPIO.
ESD TPD4E02B04 on all 8 SS lines, flow-through at the connector.
6. INTERFACES / ASSUMPTIONS
HPD (both nets are PMG1 OUTPUTS on pd_pmg1 and mux HPDIN INPUTS here; 10k series):
DS_HPD = downstream monitor HPD as decoded by PMG1 port 1 (DFP_D) from DP Status / Attention VDMs (incl. IRQ_HPD pulses)
-> TUSB1046 HPDIN.
UP_HPD = HPD state PMG1 port 0 (UFP_D) reports to the laptop (DP Status/Attention) -> TUSB1064 HPDIN (enables the
TUSB1064 DP lanes; low > 2 ms turns them off, IRQ_HPD pulses are harmless).
Pull-downs: TUSB1064 HPDIN has none internally -> external 100k on UP_HPD; TUSB1046-DCI HPDIN has 150k internal
(R(ENPD)). Both HPDIN inputs are therefore low while PMG1 is in reset -> lanes off.
PMG1_VDDD (global, pd_pmg1): powers TPD4S480 VPWR (~0.16 mA) so CC works in a dead deck. Optional new nets kept local:
UP_CCPROT_FLT_N / DS_CCPROT_FLT_N. DP_ML0/1 and DP_AUX nets are global names but only used on this sheet.
CC lines: cReceiver caps (PMG1 reference 390 pF) and VCONN source belong to pd_pmg1 next to the PMG1 CC pins.
Hub links: hub-TX 220 nF caps on usb_hub, hub-RX 220 nF caps (our SSRX outputs) on this sheet.
I2C: both muxes in GPIO mode, SDA/SCL pins are CTL0/FLIP; I2C_EN pull-up footprints (DNP) for a later I2C variant.
