KarpelesLab/odock/hardware/odock-10/odock-10.kicad_pcb

## KiCad design hardware/odock-10/odock-10.kicad_pcb (continued)

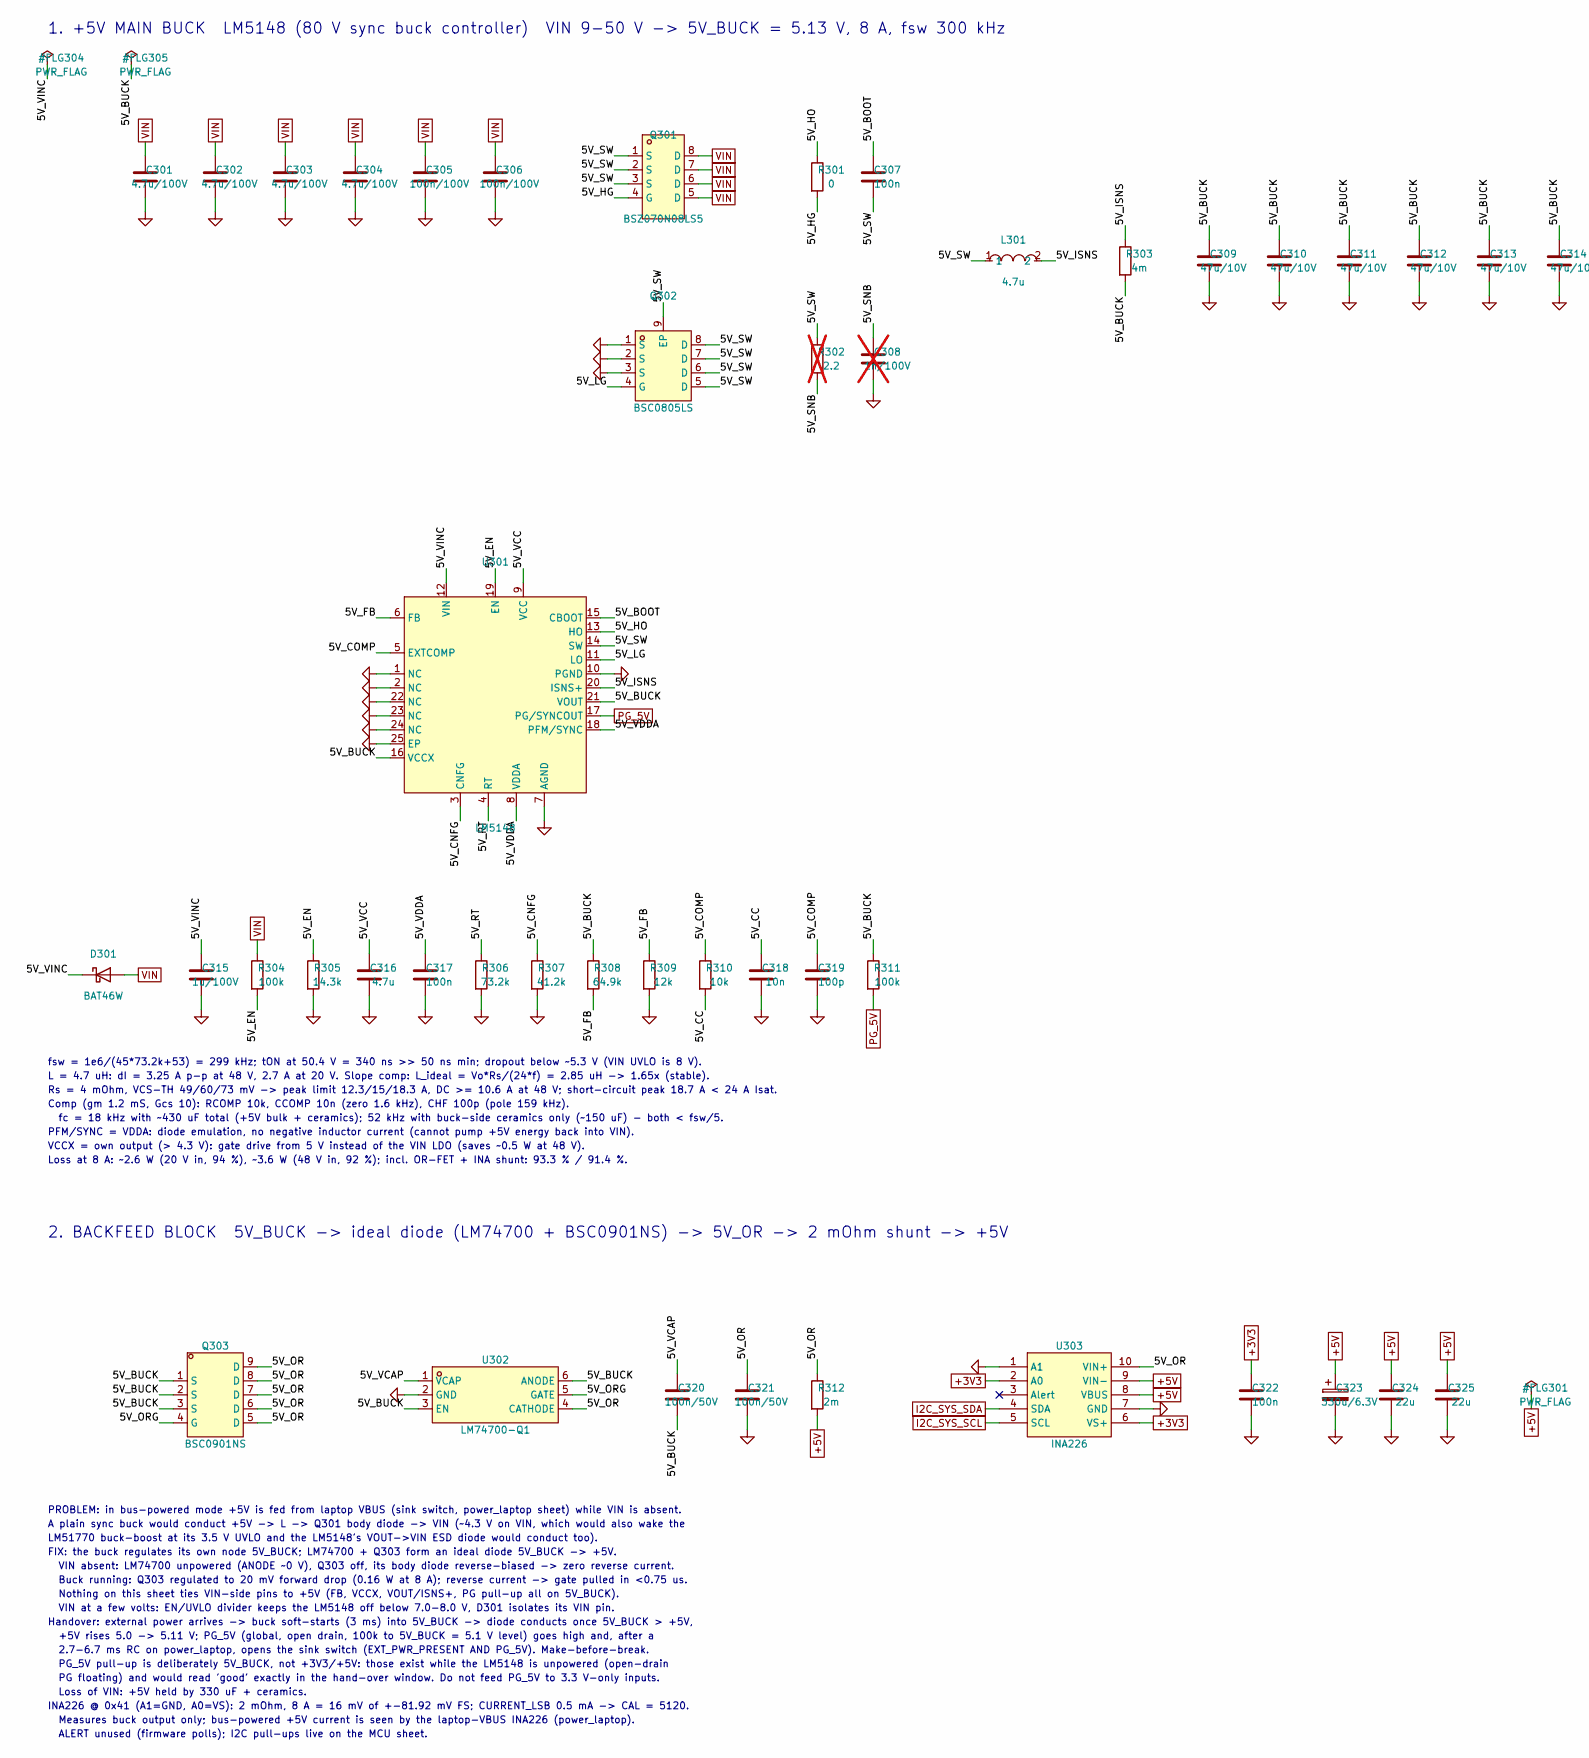
[picture p8: schematic power_rails.kicad_sch, odock-10 — Power rails (+5V / +3V3 / +1V15), part in row 1, column 1]

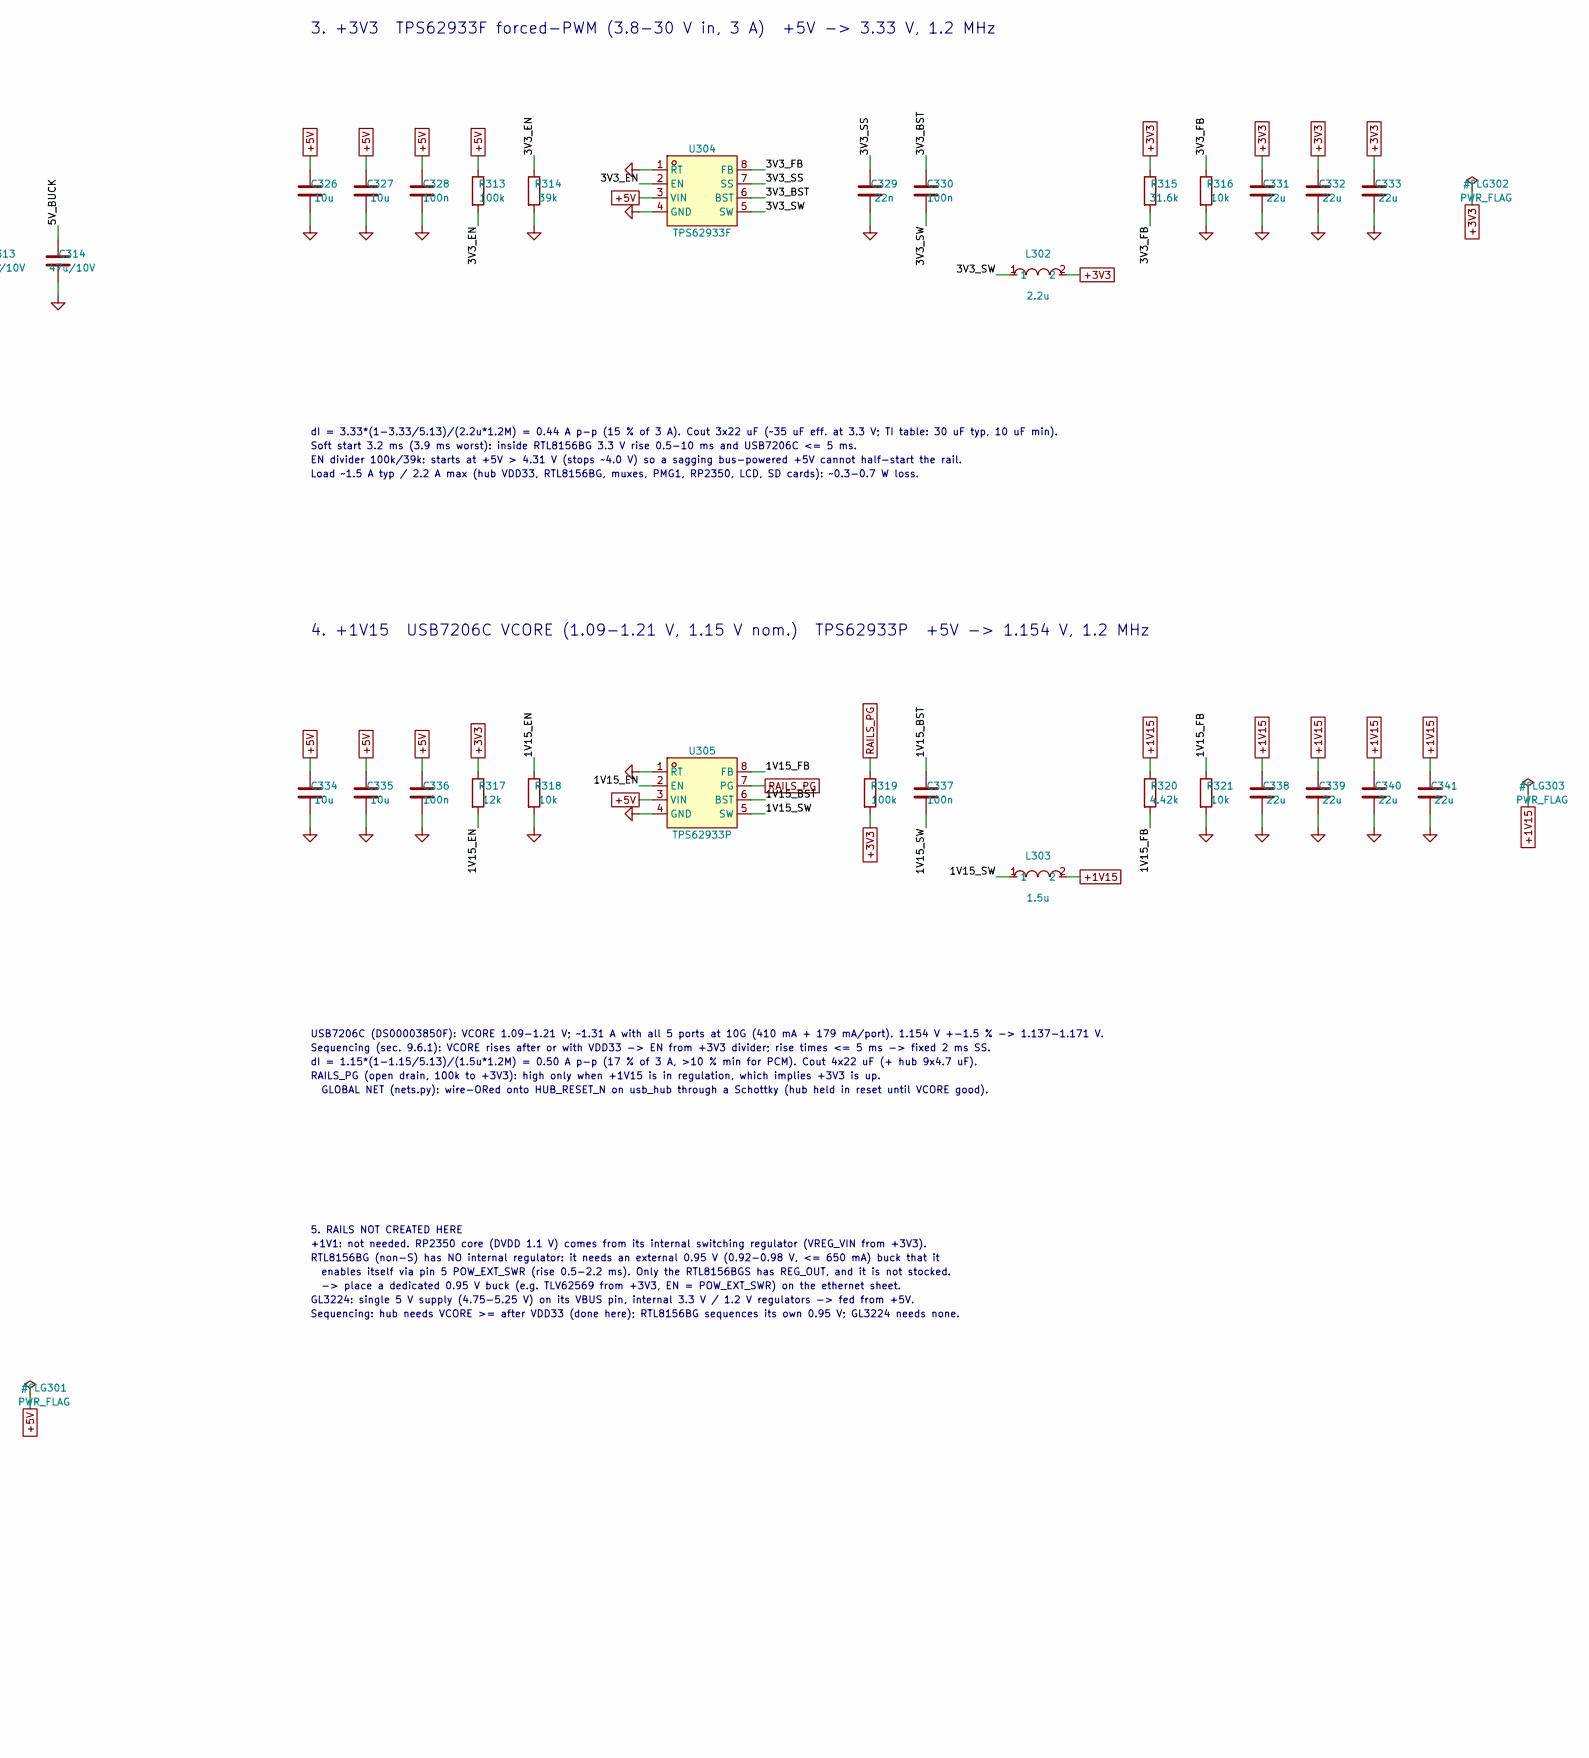
[picture p9: schematic power_rails.kicad_sch, odock-10 — Power rails (+5V / +3V3 / +1V15), part in row 1, column 2]

Parts:
C301, C302, C303, C304: 4.7u/100V; C_1210_3225Metric; LCSC C697607
C305, C306: 100n/100V; C_0805_2012Metric; LCSC C28233
C307, C317, C322, C328, C330, C336, C337: 100n; C_0402_1005Metric; LCSC C1525
C308: 1n/100V; C_0603_1608Metric; LCSC C106247; not fitted
C309, C310, C311, C312, C313, C314: 47u/10V; C_1210_3225Metric; LCSC C84494
C315: 1u/100V; C_0805_2012Metric; LCSC C126585
C316: 4.7u; C_0603_1608Metric; LCSC C19666
C318: 10n; C_0402_1005Metric; LCSC C15195
C319: 100p; C_0402_1005Metric; LCSC C1546
C320, C321: 100n/50V; C_0603_1608Metric; LCSC C14663
C323: 330u/6.3V; CP_Elec_6.3x5.9; LCSC C54321566
C324, C325, C331, C332, C333: 22u; C_0805_2012Metric; LCSC C45783
C326, C327, C334, C335: 10u; C_0805_2012Metric; LCSC C15850
C329: 22n; C_0402_1005Metric; LCSC C1532
C338, C339, C340, C341: 22u; C_0603_1608Metric; LCSC C59461
D301: BAT46W; D_SOD-123; LCSC C83152
L301: 4.7u; IND-SMD_L13.45-W12.6; MPN MWSA1206S-4R7MT; LCSC C408521
L302: 2.2u; IND-SMD_L5.4-W5.2; MPN MWSA0503S-2R2MT; LCSC C408408
L303: 1.5u; IND-SMD_L5.4-W5.2; MPN MWSA0503S-1R5MT; LCSC C408407
Q301: BSZ070N08LS5; PG-TSDSON-8_L3.3-W3.3-P0.65-BL-1; MPN BSZ070N08LS5; LCSC C534678
Q302: BSC0805LS; PG-TDSON-8_L5.2-W5.9-P1.27-LS6.2-BL-EP; MPN BSC0805LS; LCSC C534374
Q303: BSC0901NS; DFN-8_L5.9-W5.2-P1.27-LS6.2-BL; MPN BSC0901NS; LCSC C152424
R301: 0; R_0402_1005Metric; LCSC C17168
R302: 2.2; R_0805_2012Metric; LCSC C17521; not fitted
R303: 4m; R_2512_6332Metric; LCSC C459681
R304: 100k; R_0805_2012Metric; LCSC C149504
R305: 14.3k; R_0402_1005Metric; LCSC C25855
R306: 73.2k; R_0402_1005Metric; LCSC C26986
R307: 41.2k; R_0402_1005Metric; LCSC C100420
R308: 64.9k; R_0402_1005Metric; LCSC C26984
R309, R317: 12k; R_0402_1005Metric; LCSC C25752
R310, R316, R318, R321: 10k; R_0402_1005Metric; LCSC C25744
R311, R313, R319: 100k; R_0402_1005Metric; LCSC C25741
R312: 2m; R_2512_6332Metric; LCSC C459679
R314: 39k; R_0603_1608Metric; LCSC C23153
R315: 31.6k; R_0402_1005Metric; LCSC C11463
R320: 4.42k; R_0402_1005Metric; LCSC C52269
U301: LM5148; VQFN-24_L5.5-W3.5-P0.50-BL-EP-2; MPN LM5148RGYR; LCSC C7470701
U302: LM74700-Q1; SOT-23-6_L2.9-W1.6-P0.95-LS2.8-TL; MPN LM74700QDBVTQ1; LCSC C2653623
U303: INA226; MSOP-10_L3.0-W3.0-P0.50-LS5.0-BL; MPN INA226AIDGSR; LCSC C49851
U304: TPS62933F; SOT-583-8_L2.1-W1.2-P0.50-LS1.6-BR; MPN TPS62933FDRLR; LCSC C5219272
U305: TPS62933P; SOT-583-8_L2.1-W1.2-P0.50-LS1.6-BL; MPN TPS62933PDRLR; LCSC C5219254

Connections:
+1V15: C338.1, C339.1, C340.1, C341.1, L303.2, R320.1; also elsewhere on the board
+3V3: C322.1, C331.1, C332.1, C333.1, L302.2, R315.1, R317.1, R319.2, U303.2 (A0), U303.6 (VS+); also elsewhere on the board
+5V: C323.1, C324.1, C325.1, C326.1, C327.1, C328.1, C334.1, C335.1, C336.1, R312.2, R313.1, U303.8 (VBUS), U303.9 (VIN-), U304.3 (VIN), U305.3 (VIN); also elsewhere on the board
/Rails/1V15_BST: C337.1, U305.6 (BST)
/Rails/1V15_EN: R317.2, R318.1, U305.2 (EN)
/Rails/1V15_FB: R320.2, R321.1, U305.8 (FB)
/Rails/1V15_SW: C337.2, L303.1, U305.5 (SW)
/Rails/3V3_BST: C330.1, U304.6 (BST)
/Rails/3V3_EN: R313.2, R314.1, U304.2 (EN)
/Rails/3V3_FB: R315.2, R316.1, U304.8 (FB)
/Rails/3V3_SS: C329.1, U304.7 (SS)
/Rails/3V3_SW: C330.2, L302.1, U304.5 (SW)
/Rails/5V_BOOT: C307.1, U301.15 (CBOOT)
/Rails/5V_BUCK: C309.1, C310.1, C311.1, C312.1, C313.1, C314.1, C320.2, Q303.1 (S), Q303.2 (S), Q303.3 (S), R303.2, R308.1, R311.1, U301.16 (VCCX), U301.21 (VOUT), U302.3 (EN), U302.6 (ANODE)
/Rails/5V_CC: C318.1, R310.2
/Rails/5V_CNFG: R307.1, U301.3 (CNFG)
/Rails/5V_COMP: C319.1, R310.1, U301.5 (EXTCOMP)
/Rails/5V_EN: R304.2, R305.1, U301.19 (EN)
/Rails/5V_FB: R308.2, R309.1, U301.6 (FB)
/Rails/5V_HG: Q301.4 (G), R301.2
/Rails/5V_HO: R301.1, U301.13 (HO)
/Rails/5V_ISNS: L301.2, R303.1, U301.20 (ISNS+)
/Rails/5V_LG: Q302.4 (G), U301.11 (LO)
/Rails/5V_OR: C321.1, Q303.5 (D), Q303.6 (D), Q303.7 (D), Q303.8 (D), Q303.9 (D), R312.1, U302.4 (CATHODE), U303.10 (VIN+)
/Rails/5V_ORG: Q303.4 (G), U302.5 (GATE)
/Rails/5V_RT: R306.1, U301.4 (RT)
/Rails/5V_SNB: C308.1, R302.2
/Rails/5V_SW: C307.2, L301.1, Q301.1 (S), Q301.2 (S), Q301.3 (S), Q302.5 (D), Q302.6 (D), Q302.7 (D), Q302.8 (D), Q302.9 (EP), R302.1, U301.14 (SW)
/Rails/5V_VCAP: C320.1, U302.1 (VCAP)
/Rails/5V_VCC: C316.1, U301.9 (VCC)
/Rails/5V_VDDA: C317.1, U301.8 (VDDA), U301.18 (PFM/SYNC)
/Rails/5V_VINC: C315.1, D301.1 (K), U301.12 (VIN)
GND: C301.2, C302.2, C303.2, C304.2, C305.2, C306.2, C308.2, C309.2, C310.2, C311.2, C312.2, C313.2, C314.2, C315.2, C316.2, C317.2, C318.2, C319.2, C321.2, C322.2, C323.2, C324.2, C325.2, C326.2, C327.2, C328.2, C329.2, C331.2, C332.2, C333.2, C334.2, C335.2, C336.2, C338.2, C339.2, C340.2, C341.2, Q302.1 (S), Q302.2 (S), Q302.3 (S), R305.2, R306.2, R307.2, R309.2, R314.2, R316.2, R318.2, R321.2, U301.1 (NC), U301.2 (NC), U301.7 (AGND), U301.10 (PGND), U301.22 (NC), U301.23 (NC), U301.24 (NC), U301.25 (EP), U302.2 (GND), U303.1 (A1), U303.7 (GND), U304.1 (RT), U304.4 (GND), U305.1 (RT), U305.4 (GND); also elsewhere on the board
I2C_SYS_SCL: U303.5 (SCL); also elsewhere on the board
I2C_SYS_SDA: U303.4 (SDA); also elsewhere on the board
PG_5V: R311.2, U301.17 (PG/SYNCOUT); also elsewhere on the board
RAILS_PG: R319.1, U305.7 (PG); also elsewhere on the board
VIN: C301.1, C302.1, C303.1, C304.1, C305.1, C306.1, D301.2 (A), Q301.5 (D), Q301.6 (D), Q301.7 (D), Q301.8 (D), R304.1; also elsewhere on the board

Notes on the sheet:
1. +5V MAIN BUCK LM5148 (80 V sync buck controller) VIN 9-50 V -> 5V_BUCK = 5.13 V, 8 A, fsw 300 kHz
fsw = 1e6/(45*73.2k+53) = 299 kHz; tON at 50.4 V = 340 ns >> 50 ns min; dropout below ~5.3 V (VIN UVLO is 8 V).
L = 4.7 uH: dI = 3.25 A p-p at 48 V, 2.7 A at 20 V. Slope comp: L_ideal = Vo*Rs/(24*f) = 2.85 uH -> 1.65x (stable).
Rs = 4 mOhm, VCS-TH 49/60/73 mV -> peak limit 12.3/15/18.3 A, DC >= 10.6 A at 48 V; short-circuit peak 18.7 A < 24 A Isat.
Comp (gm 1.2 mS, Gcs 10): RCOMP 10k, CCOMP 10n (zero 1.6 kHz), CHF 100p (pole 159 kHz).
fc = 18 kHz with ~430 uF total (+5V bulk + ceramics); 52 kHz with buck-side ceramics only (~150 uF) - both < fsw/5.
PFM/SYNC = VDDA: diode emulation, no negative inductor current (cannot pump +5V energy back into VIN).
VCCX = own output (> 4.3 V): gate drive from 5 V instead of the VIN LDO (saves ~0.5 W at 48 V).
Loss at 8 A: ~2.6 W (20 V in, 94 %), ~3.6 W (48 V in, 92 %); incl. OR-FET + INA shunt: 93.3 % / 91.4 %.
2. BACKFEED BLOCK 5V_BUCK -> ideal diode (LM74700 + BSC0901NS) -> 5V_OR -> 2 mOhm shunt -> +5V
PROBLEM: in bus-powered mode +5V is fed from laptop VBUS (sink switch, power_laptop sheet) while VIN is absent.
A plain sync buck would conduct +5V -> L -> Q301 body diode -> VIN (~4.3 V on VIN, which would also wake the
LM51770 buck-boost at its 3.5 V UVLO and the LM5148's VOUT->VIN ESD diode would conduct too).
FIX: the buck regulates its own node 5V_BUCK; LM74700 + Q303 form an ideal diode 5V_BUCK -> +5V.
VIN absent: LM74700 unpowered (ANODE ~0 V), Q303 off, its body diode reverse-biased -> zero reverse current.
Buck running: Q303 regulated to 20 mV forward drop (0.16 W at 8 A); reverse current -> gate pulled in <0.75 us.
Nothing on this sheet ties VIN-side pins to +5V (FB, VCCX, VOUT/ISNS+, PG pull-up all on 5V_BUCK).
VIN at a few volts: EN/UVLO divider keeps the LM5148 off below 7.0-8.0 V, D301 isolates its VIN pin.
Handover: external power arrives -> buck soft-starts (3 ms) into 5V_BUCK -> diode conducts once 5V_BUCK > +5V,
+5V rises 5.0 -> 5.11 V; PG_5V (global, open drain, 100k to 5V_BUCK = 5.1 V level) goes high and, after a
2.7-6.7 ms RC on power_laptop, opens the sink switch (EXT_PWR_PRESENT AND PG_5V). Make-before-break.
PG_5V pull-up is deliberately 5V_BUCK, not +3V3/+5V: those exist while the LM5148 is unpowered (open-drain
PG floating) and would read 'good' exactly in the hand-over window. Do not feed PG_5V to 3.3 V-only inputs.
Loss of VIN: +5V held by 330 uF + ceramics.
INA226 @ 0x41 (A1=GND, A0=VS): 2 mOhm, 8 A = 16 mV of +-81.92 mV FS; CURRENT_LSB 0.5 mA -> CAL = 5120.
Measures buck output only; bus-powered +5V current is seen by the laptop-VBUS INA226 (power_laptop).
ALERT unused (firmware polls); I2C pull-ups live on the MCU sheet.
3. +3V3 TPS62933F forced-PWM (3.8-30 V in, 3 A) +5V -> 3.33 V, 1.2 MHz
dI = 3.33*(1-3.33/5.13)/(2.2u*1.2M) = 0.44 A p-p (15 % of 3 A). Cout 3x22 uF (~35 uF eff. at 3.3 V; TI table: 30 uF typ, 10 uF min).
Soft start 3.2 ms (3.9 ms worst): inside RTL8156BG 3.3 V rise 0.5-10 ms and USB7206C <= 5 ms.
EN divider 100k/39k: starts at +5V > 4.31 V (stops ~4.0 V) so a sagging bus-powered +5V cannot half-start the rail.
Load ~1.5 A typ / 2.2 A max (hub VDD33, RTL8156BG, muxes, PMG1, RP2350, LCD, SD cards): ~0.3-0.7 W loss.
4. +1V15 USB7206C VCORE (1.09-1.21 V, 1.15 V nom.) TPS62933P +5V -> 1.154 V, 1.2 MHz
USB7206C (DS00003850F): VCORE 1.09-1.21 V; ~1.31 A with all 5 ports at 10G (410 mA + 179 mA/port). 1.154 V +-1.5 % -> 1.137-1.171 V.
Sequencing (sec. 9.6.1): VCORE rises after or with VDD33 -> EN from +3V3 divider; rise times <= 5 ms -> fixed 2 ms SS.
dI = 1.15*(1-1.15/5.13)/(1.5u*1.2M) = 0.50 A p-p (17 % of 3 A, >10 % min for PCM). Cout 4x22 uF (+ hub 9x4.7 uF).
RAILS_PG (open drain, 100k to +3V3): high only when +1V15 is in regulation, which implies +3V3 is up.
GLOBAL NET (nets.py): wire-ORed onto HUB_RESET_N on usb_hub through a Schottky (hub held in reset until VCORE good).
5. RAILS NOT CREATED HERE
+1V1: not needed. RP2350 core (DVDD 1.1 V) comes from its internal switching regulator (VREG_VIN from +3V3).
RTL8156BG (non-S) has NO internal regulator: it needs an external 0.95 V (0.92-0.98 V, <= 650 mA) buck that it
enables itself via pin 5 POW_EXT_SWR (rise 0.5-2.2 ms). Only the RTL8156BGS has REG_OUT, and it is not stocked.
-> place a dedicated 0.95 V buck (e.g. TLV62569 from +3V3, EN = POW_EXT_SWR) on the ethernet sheet.
GL3224: single 5 V supply (4.75-5.25 V) on its VBUS pin, internal 3.3 V / 1.2 V regulators -> fed from +5V.
Sequencing: hub needs VCORE >= after VDD33 (done here); RTL8156BG sequences its own 0.95 V; GL3224 needs none.

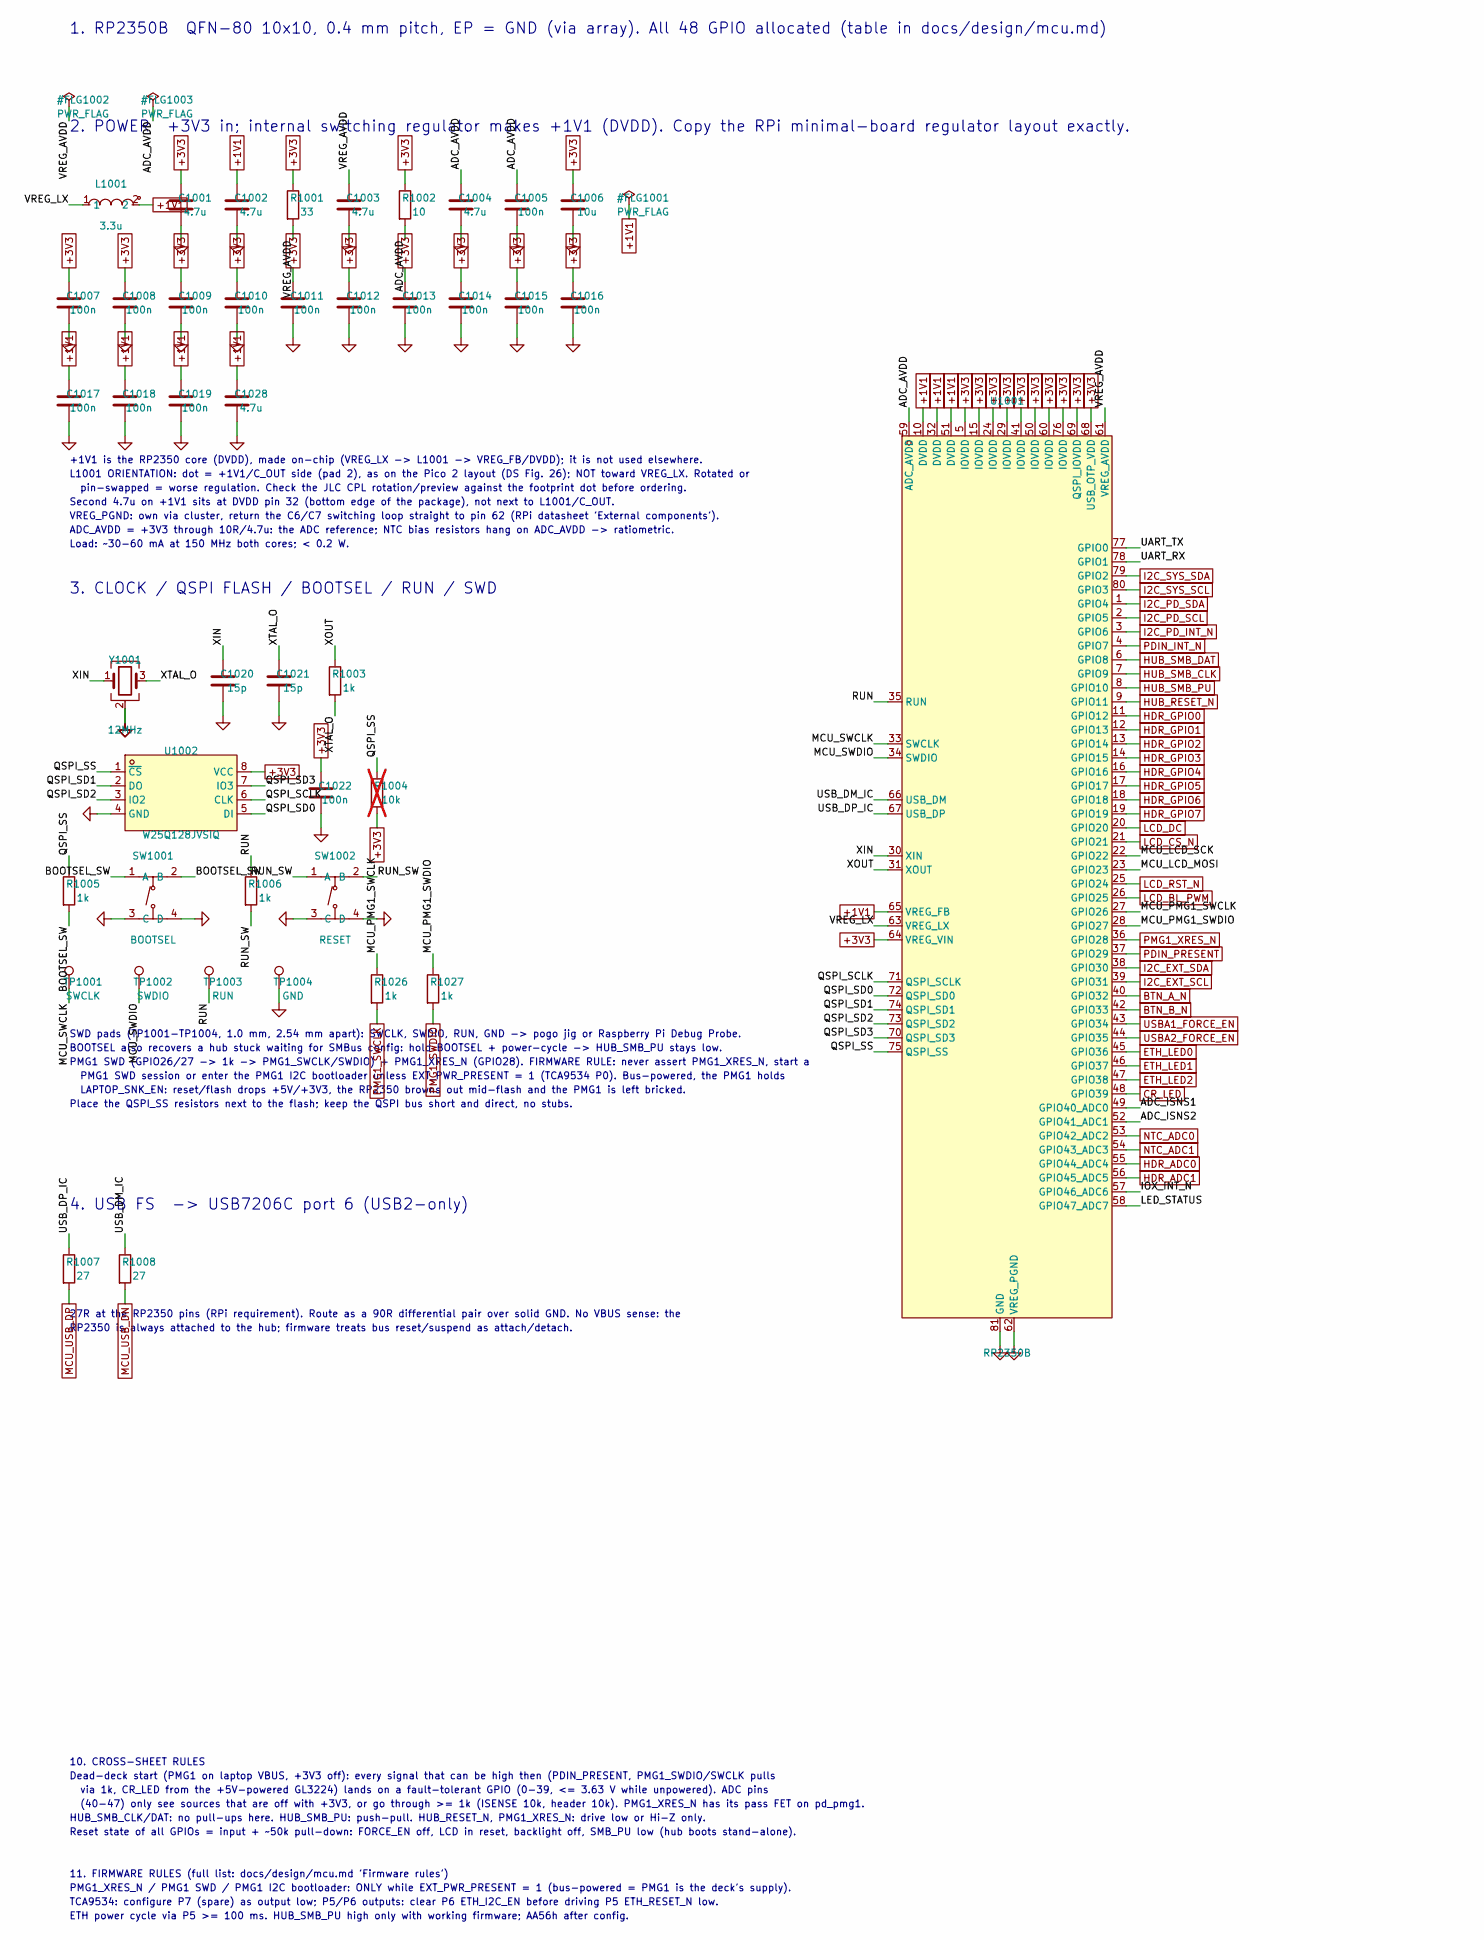
[picture p10: schematic mcu.kicad_sch, odock-10 — MCU (RP2350B), part in row 1, column 1]

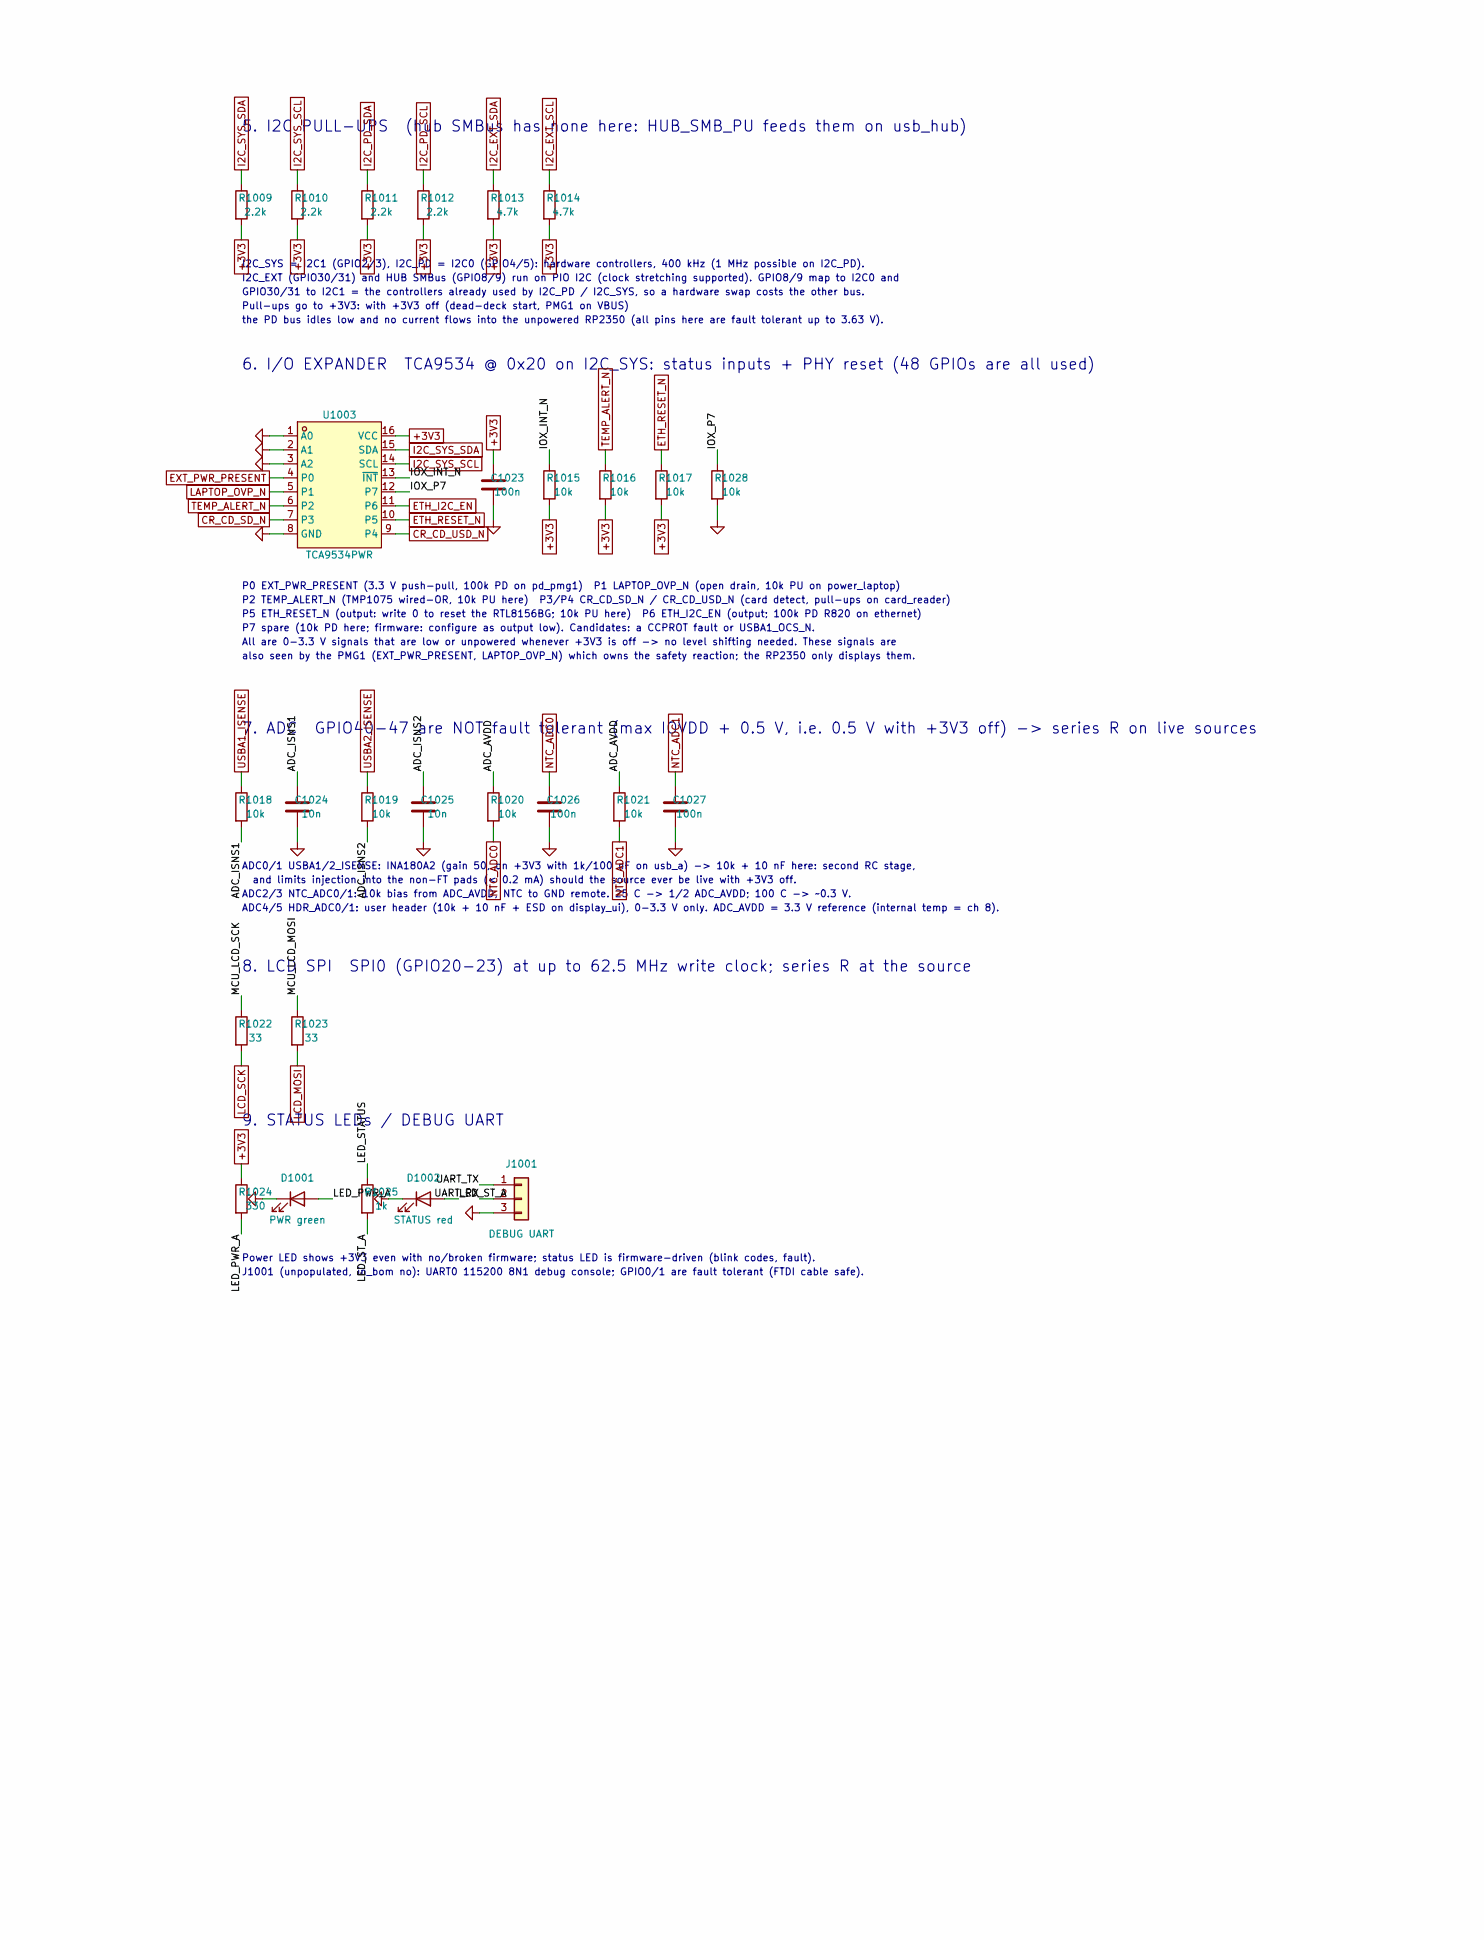
[picture p11: schematic mcu.kicad_sch, odock-10 — MCU (RP2350B), part in row 1, column 2]

Parts:
C1001, C1002, C1003, C1004, C1028: 4.7u; C_0402_1005Metric; LCSC C23733
C1005, C1007, C1008, C1009, C1010, C1011, C1012, C1013, C1014, C1015, C1016, C1017, C1018, C1019, C1022, C1023, C1026, C1027: 100n; C_0402_1005Metric; LCSC C1525
C1006: 10u; C_0603_1608Metric; LCSC C19702
C1020, C1021: 15p; C_0402_1005Metric; LCSC C1548
C1024, C1025: 10n; C_0402_1005Metric; LCSC C15195
D1001: PWR green; LED_0805_2012Metric; LCSC C2297
D1002: STATUS red; LED_0603_1608Metric; LCSC C2286
J1001: DEBUG UART; PinHeader_1x03_P2.54mm_Vertical
L1001: 3.3u; IND-SMD_L2.0-W1.6_AOTA-B201610S3R3-101-T; MPN AOTA-B201610S3R3-101-T; LCSC C42411119
R1001, R1022, R1023: 33; R_0402_1005Metric; LCSC C25105
R1002: 10; R_0402_1005Metric; LCSC C25077
R1003, R1005, R1006, R1025, R1026, R1027: 1k; R_0402_1005Metric; LCSC C11702
R1004: 10k; R_0402_1005Metric; LCSC C25744; not fitted
R1007, R1008: 27; R_0402_1005Metric; LCSC C25100
R1009, R1010, R1011, R1012: 2.2k; R_0402_1005Metric; LCSC C25879
R1013, R1014: 4.7k; R_0402_1005Metric; LCSC C25900
R1015, R1016, R1017, R1018, R1019, R1020, R1021, R1028: 10k; R_0402_1005Metric; LCSC C25744
R1024: 330; R_0402_1005Metric; LCSC C25104
SW1001: BOOTSEL; SW-SMD_4P-L5.1-W5.1-P3.70-LS6.5-TL_H1.5; MPN TS-1187A-B-A-B; LCSC C318884
SW1002: RESET; SW-SMD_4P-L5.1-W5.1-P3.70-LS6.5-TL_H1.5; MPN TS-1187A-B-A-B; LCSC C318884
TP1001: SWCLK; TestPoint_Pad_D1.0mm
TP1002: SWDIO; TestPoint_Pad_D1.0mm
TP1003: RUN; TestPoint_Pad_D1.0mm
TP1004: GND; TestPoint_Pad_D1.0mm
U1001: RP2350B; QFN-80_L10.0-W10.0-P0.40-TL-EP3.4; MPN RP2350B; LCSC C42415655
U1002: W25Q128JVSIQ; SOIC-8_L5.3-W5.3-P1.27-LS8.0-BL; MPN W25Q128JVSIQ; LCSC C97521
U1003: TCA9534PWR; TSSOP-16_L5.0-W4.4-P0.65-LS6.4-BL; MPN TCA9534PWR; LCSC C783615
Y1001: 12MHz; Crystal_SMD_3225-4Pin_3.2x2.5mm; LCSC C20625731

Connections:
+1V1: C1002.1, C1017.1, C1018.1, C1019.1, C1028.1, L1001.2, U1001.10 (DVDD), U1001.32 (DVDD), U1001.51 (DVDD), U1001.65 (VREG_FB)
+3V3: C1001.1, C1006.1, C1007.1, C1008.1, C1009.1, C1010.1, C1011.1, C1012.1, C1013.1, C1014.1, C1015.1, C1016.1, C1022.1, C1023.1, R1001.1, R1002.1, R1004.2, R1009.2, R1010.2, R1011.2, R1012.2, R1013.2, R1014.2, R1015.2, R1016.2, R1017.2, R1024.1, U1001.5 (IOVDD), U1001.15 (IOVDD), U1001.24 (IOVDD), U1001.29 (IOVDD), U1001.41 (IOVDD), U1001.50 (IOVDD), U1001.60 (IOVDD), U1001.64 (VREG_VIN), U1001.68 (USB_OTP_VDD), U1001.69 (QSPI_IOVDD), U1001.76 (IOVDD), U1002.8 (VCC), U1003.16 (VCC); also elsewhere on the board
/MCU/ADC_AVDD: C1004.1, C1005.1, R1002.2, R1020.1, R1021.1, U1001.59 (ADC_AVDD)
/MCU/ADC_ISNS1: C1024.1, R1018.2, U1001.49 (GPIO40_ADC0)
/MCU/ADC_ISNS2: C1025.1, R1019.2, U1001.52 (GPIO41_ADC1)
/MCU/BOOTSEL_SW: R1005.2, SW1001.1 (A), SW1001.2 (B)
/MCU/IOX_INT_N: R1015.1, U1001.57 (GPIO46_ADC6), U1003.13 (~INT)
/MCU/IOX_P7: R1028.1, U1003.12 (P7)
/MCU/LED_PWR_A: D1001.2 (A), R1024.2
/MCU/LED_STATUS: R1025.1, U1001.58 (GPIO47_ADC7)
/MCU/LED_ST_A: D1002.2 (A), R1025.2
/MCU/MCU_LCD_MOSI: R1023.1, U1001.23 (GPIO23)
/MCU/MCU_LCD_SCK: R1022.1, U1001.22 (GPIO22)
/MCU/MCU_PMG1_SWCLK: R1026.1, U1001.27 (GPIO26)
/MCU/MCU_PMG1_SWDIO: R1027.1, U1001.28 (GPIO27)
/MCU/MCU_SWCLK: TP1001.1, U1001.33 (SWCLK)
/MCU/MCU_SWDIO: TP1002.1, U1001.34 (SWDIO)
/MCU/QSPI_SCLK: U1001.71 (QSPI_SCLK), U1002.6 (CLK)
/MCU/QSPI_SD0: U1001.72 (QSPI_SD0), U1002.5 (DI)
/MCU/QSPI_SD1: U1001.74 (QSPI_SD1), U1002.2 (DO)
/MCU/QSPI_SD2: U1001.73 (QSPI_SD2), U1002.3 (IO2)
/MCU/QSPI_SD3: U1001.70 (QSPI_SD3), U1002.7 (IO3)
/MCU/QSPI_SS: R1004.1, R1005.1, U1001.75 (QSPI_SS), U1002.1 (~CS)
/MCU/RUN: R1006.1, TP1003.1, U1001.35 (RUN)
/MCU/RUN_SW: R1006.2, SW1002.1 (A), SW1002.2 (B)
/MCU/UART_RX: J1001.2, U1001.78 (GPIO1)
/MCU/UART_TX: J1001.1, U1001.77 (GPIO0)
/MCU/USB_DM_IC: R1008.1, U1001.66 (USB_DM)
/MCU/USB_DP_IC: R1007.1, U1001.67 (USB_DP)
/MCU/VREG_AVDD: C1003.1, R1001.2, U1001.61 (VREG_AVDD)
/MCU/VREG_LX: L1001.1, U1001.63 (VREG_LX)
/MCU/XIN: C1020.1, U1001.30 (XIN), Y1001.1
/MCU/XOUT: R1003.1, U1001.31 (XOUT)
/MCU/XTAL_O: C1021.1, R1003.2, Y1001.3
BTN_A_N: U1001.40 (GPIO32); also elsewhere on the board
BTN_B_N: U1001.42 (GPIO33); also elsewhere on the board
CR_CD_SD_N: U1003.7 (P3); also elsewhere on the board
CR_CD_USD_N: U1003.9 (P4); also elsewhere on the board
CR_LED: U1001.48 (GPIO39); also elsewhere on the board
ETH_I2C_EN: U1003.11 (P6); also elsewhere on the board
ETH_LED0: U1001.45 (GPIO36); also elsewhere on the board
ETH_LED1: U1001.46 (GPIO37); also elsewhere on the board
ETH_LED2: U1001.47 (GPIO38); also elsewhere on the board
ETH_RESET_N: R1017.1, U1003.10 (P5); also elsewhere on the board
EXT_PWR_PRESENT: U1003.4 (P0); also elsewhere on the board
GND: C1001.2, C1002.2, C1003.2, C1004.2, C1005.2, C1006.2, C1007.2, C1008.2, C1009.2, C1010.2, C1011.2, C1012.2, C1013.2, C1014.2, C1015.2, C1016.2, C1017.2, C1018.2, C1019.2, C1020.2, C1021.2, C1022.2, C1023.2, C1024.2, C1025.2, C1026.2, C1027.2, C1028.2, D1001.1 (K), D1002.1 (K), J1001.3, R1028.2, SW1001.3 (C), SW1001.4 (D), SW1002.3 (C), SW1002.4 (D), TP1004.1, U1001.62 (VREG_PGND), U1001.81 (GND), U1002.4 (GND), U1003.1 (A0), U1003.2 (A1), U1003.3 (A2), U1003.8 (GND), Y1001.2 (G), Y1001.4 (G); also elsewhere on the board
HDR_ADC0: U1001.55 (GPIO44_ADC4); also elsewhere on the board
HDR_ADC1: U1001.56 (GPIO45_ADC5); also elsewhere on the board
HDR_GPIO0: U1001.11 (GPIO12); also elsewhere on the board
HDR_GPIO1: U1001.12 (GPIO13); also elsewhere on the board
HDR_GPIO2: U1001.13 (GPIO14); also elsewhere on the board
HDR_GPIO3: U1001.14 (GPIO15); also elsewhere on the board
HDR_GPIO4: U1001.16 (GPIO16); also elsewhere on the board
HDR_GPIO5: U1001.17 (GPIO17); also elsewhere on the board
HDR_GPIO6: U1001.18 (GPIO18); also elsewhere on the board
HDR_GPIO7: U1001.19 (GPIO19); also elsewhere on the board
HUB_RESET_N: U1001.9 (GPIO11); also elsewhere on the board
HUB_SMB_CLK: U1001.7 (GPIO9); also elsewhere on the board
HUB_SMB_DAT: U1001.6 (GPIO8); also elsewhere on the board
HUB_SMB_PU: U1001.8 (GPIO10); also elsewhere on the board
I2C_EXT_SCL: R1014.1, U1001.39 (GPIO31); also elsewhere on the board
I2C_EXT_SDA: R1013.1, U1001.38 (GPIO30); also elsewhere on the board
I2C_PD_INT_N: U1001.3 (GPIO6); also elsewhere on the board
I2C_PD_SCL: R1012.1, U1001.2 (GPIO5); also elsewhere on the board
I2C_PD_SDA: R1011.1, U1001.1 (GPIO4); also elsewhere on the board
I2C_SYS_SCL: R1010.1, U1001.80 (GPIO3), U1003.14 (SCL); also elsewhere on the board
I2C_SYS_SDA: R1009.1, U1001.79 (GPIO2), U1003.15 (SDA); also elsewhere on the board
LAPTOP_OVP_N: U1003.5 (P1); also elsewhere on the board
LCD_BL_PWM: U1001.26 (GPIO25); also elsewhere on the board
LCD_CS_N: U1001.21 (GPIO21); also elsewhere on the board
LCD_DC: U1001.20 (GPIO20); also elsewhere on the board
LCD_MOSI: R1023.2; also elsewhere on the board
LCD_RST_N: U1001.25 (GPIO24); also elsewhere on the board
LCD_SCK: R1022.2; also elsewhere on the board
MCU_USB_DN: R1008.2; also elsewhere on the board
MCU_USB_DP: R1007.2; also elsewhere on the board
NTC_ADC0: C1026.1, R1020.2, U1001.53 (GPIO42_ADC2); also elsewhere on the board
NTC_ADC1: C1027.1, R1021.2, U1001.54 (GPIO43_ADC3); also elsewhere on the board
PDIN_INT_N: U1001.4 (GPIO7); also elsewhere on the board
PDIN_PRESENT: U1001.37 (GPIO29); also elsewhere on the board
PMG1_SWCLK: R1026.2; also elsewhere on the board
PMG1_SWDIO: R1027.2; also elsewhere on the board
PMG1_XRES_N: U1001.36 (GPIO28); also elsewhere on the board
TEMP_ALERT_N: R1016.1, U1003.6 (P2); also elsewhere on the board
USBA1_FORCE_EN: U1001.43 (GPIO34); also elsewhere on the board
USBA1_ISENSE: R1018.1; also elsewhere on the board
USBA2_FORCE_EN: U1001.44 (GPIO35); also elsewhere on the board
USBA2_ISENSE: R1019.1; also elsewhere on the board

Notes on the sheet:
1. RP2350B QFN-80 10x10, 0.4 mm pitch, EP = GND (via array). All 48 GPIO allocated (table in docs/design/mcu.md)
2. POWER +3V3 in; internal switching regulator makes +1V1 (DVDD). Copy the RPi minimal-board regulator layout exactly.
+1V1 is the RP2350 core (DVDD), made on-chip (VREG_LX -> L1001 -> VREG_FB/DVDD); it is not used elsewhere.
L1001 ORIENTATION: dot = +1V1/C_OUT side (pad 2), as on the Pico 2 layout (DS Fig. 26); NOT toward VREG_LX. Rotated or
pin-swapped = worse regulation. Check the JLC CPL rotation/preview against the footprint dot before ordering.
Second 4.7u on +1V1 sits at DVDD pin 32 (bottom edge of the package), not next to L1001/C_OUT.
VREG_PGND: own via cluster, return the C6/C7 switching loop straight to pin 62 (RPi datasheet 'External components').
ADC_AVDD = +3V3 through 10R/4.7u: the ADC reference; NTC bias resistors hang on ADC_AVDD -> ratiometric.
Load: ~30-60 mA at 150 MHz both cores; < 0.2 W.
3. CLOCK / QSPI FLASH / BOOTSEL / RUN / SWD
SWD pads (TP1001-TP1004, 1.0 mm, 2.54 mm apart): SWCLK, SWDIO, RUN, GND -> pogo jig or Raspberry Pi Debug Probe.
BOOTSEL also recovers a hub stuck waiting for SMBus config: hold BOOTSEL + power-cycle -> HUB_SMB_PU stays low.
PMG1 SWD (GPIO26/27 -> 1k -> PMG1_SWCLK/SWDIO) + PMG1_XRES_N (GPIO28). FIRMWARE RULE: never assert PMG1_XRES_N, start a
PMG1 SWD session or enter the PMG1 I2C bootloader unless EXT_PWR_PRESENT = 1 (TCA9534 P0). Bus-powered, the PMG1 holds
LAPTOP_SNK_EN: reset/flash drops +5V/+3V3, the RP2350 browns out mid-flash and the PMG1 is left bricked.
Place the QSPI_SS resistors next to the flash; keep the QSPI bus short and direct, no stubs.
4. USB FS -> USB7206C port 6 (USB2-only)
27R at the RP2350 pins (RPi requirement). Route as a 90R differential pair over solid GND. No VBUS sense: the
RP2350 is always attached to the hub; firmware treats bus reset/suspend as attach/detach.
5. I2C PULL-UPS (hub SMBus has none here: HUB_SMB_PU feeds them on usb_hub)
I2C_SYS = I2C1 (GPIO2/3), I2C_PD = I2C0 (GPIO4/5): hardware controllers, 400 kHz (1 MHz possible on I2C_PD).
I2C_EXT (GPIO30/31) and HUB SMBus (GPIO8/9) run on PIO I2C (clock stretching supported). GPIO8/9 map to I2C0 and
GPIO30/31 to I2C1 = the controllers already used by I2C_PD / I2C_SYS, so a hardware swap costs the other bus.
Pull-ups go to +3V3: with +3V3 off (dead-deck start, PMG1 on VBUS)
the PD bus idles low and no current flows into the unpowered RP2350 (all pins here are fault tolerant up to 3.63 V).
6. I/O EXPANDER TCA9534 @ 0x20 on I2C_SYS: status inputs + PHY reset (48 GPIOs are all used)
P0 EXT_PWR_PRESENT (3.3 V push-pull, 100k PD on pd_pmg1) P1 LAPTOP_OVP_N (open drain, 10k PU on power_laptop)
P2 TEMP_ALERT_N (TMP1075 wired-OR, 10k PU here) P3/P4 CR_CD_SD_N / CR_CD_USD_N (card detect, pull-ups on card_reader)
P5 ETH_RESET_N (output: write 0 to reset the RTL8156BG; 10k PU here) P6 ETH_I2C_EN (output; 100k PD R820 on ethernet)
P7 spare (10k PD here; firmware: configure as output low). Candidates: a CCPROT fault or USBA1_OCS_N.
All are 0-3.3 V signals that are low or unpowered whenever +3V3 is off -> no level shifting needed. These signals are
also seen by the PMG1 (EXT_PWR_PRESENT, LAPTOP_OVP_N) which owns the safety reaction; the RP2350 only displays them.
7. ADC GPIO40-47 are NOT fault tolerant (max IOVDD + 0.5 V, i.e. 0.5 V with +3V3 off) -> series R on live sources
ADC0/1 USBA1/2_ISENSE: INA180A2 (gain 50, on +3V3 with 1k/100 nF on usb_a) -> 10k + 10 nF here: second RC stage,
and limits injection into the non-FT pads (< 0.2 mA) should the source ever be live with +3V3 off.
ADC2/3 NTC_ADC0/1: 10k bias from ADC_AVDD, NTC to GND remote. 25 C -> 1/2 ADC_AVDD; 100 C -> ~0.3 V.
ADC4/5 HDR_ADC0/1: user header (10k + 10 nF + ESD on display_ui), 0-3.3 V only. ADC_AVDD = 3.3 V reference (internal temp = ch 8).
8. LCD SPI SPI0 (GPIO20-23) at up to 62.5 MHz write clock; series R at the source
9. STATUS LEDs / DEBUG UART
Power LED shows +3V3 even with no/broken firmware; status LED is firmware-driven (blink codes, fault).
J1001 (unpopulated, in_bom no): UART0 115200 8N1 debug console; GPIO0/1 are fault tolerant (FTDI cable safe).
10. CROSS-SHEET RULES
Dead-deck start (PMG1 on laptop VBUS, +3V3 off): every signal that can be high then (PDIN_PRESENT, PMG1_SWDIO/SWCLK pulls
via 1k, CR_LED from the +5V-powered GL3224) lands on a fault-tolerant GPIO (0-39, <= 3.63 V while unpowered). ADC pins
(40-47) only see sources that are off with +3V3, or go through >= 1k (ISENSE 10k, header 10k). PMG1_XRES_N has its pass FET on pd_pmg1.
HUB_SMB_CLK/DAT: no pull-ups here. HUB_SMB_PU: push-pull. HUB_RESET_N, PMG1_XRES_N: drive low or Hi-Z only.
Reset state of all GPIOs = input + ~50k pull-down: FORCE_EN off, LCD in reset, backlight off, SMB_PU low (hub boots stand-alone).
11. FIRMWARE RULES (full list: docs/design/mcu.md 'Firmware rules')
PMG1_XRES_N / PMG1 SWD / PMG1 I2C bootloader: ONLY while EXT_PWR_PRESENT = 1 (bus-powered = PMG1 is the deck's supply).
TCA9534: configure P7 (spare) as output low; P5/P6 outputs: clear P6 ETH_I2C_EN before driving P5 ETH_RESET_N low.
ETH power cycle via P5 >= 100 ms. HUB_SMB_PU high only with working firmware; AA56h after config.
