KarpelesLab/odock/hardware/odock-10/odock-10.kicad_pcb

## KiCad design hardware/odock-10/odock-10.kicad_pcb (continued)

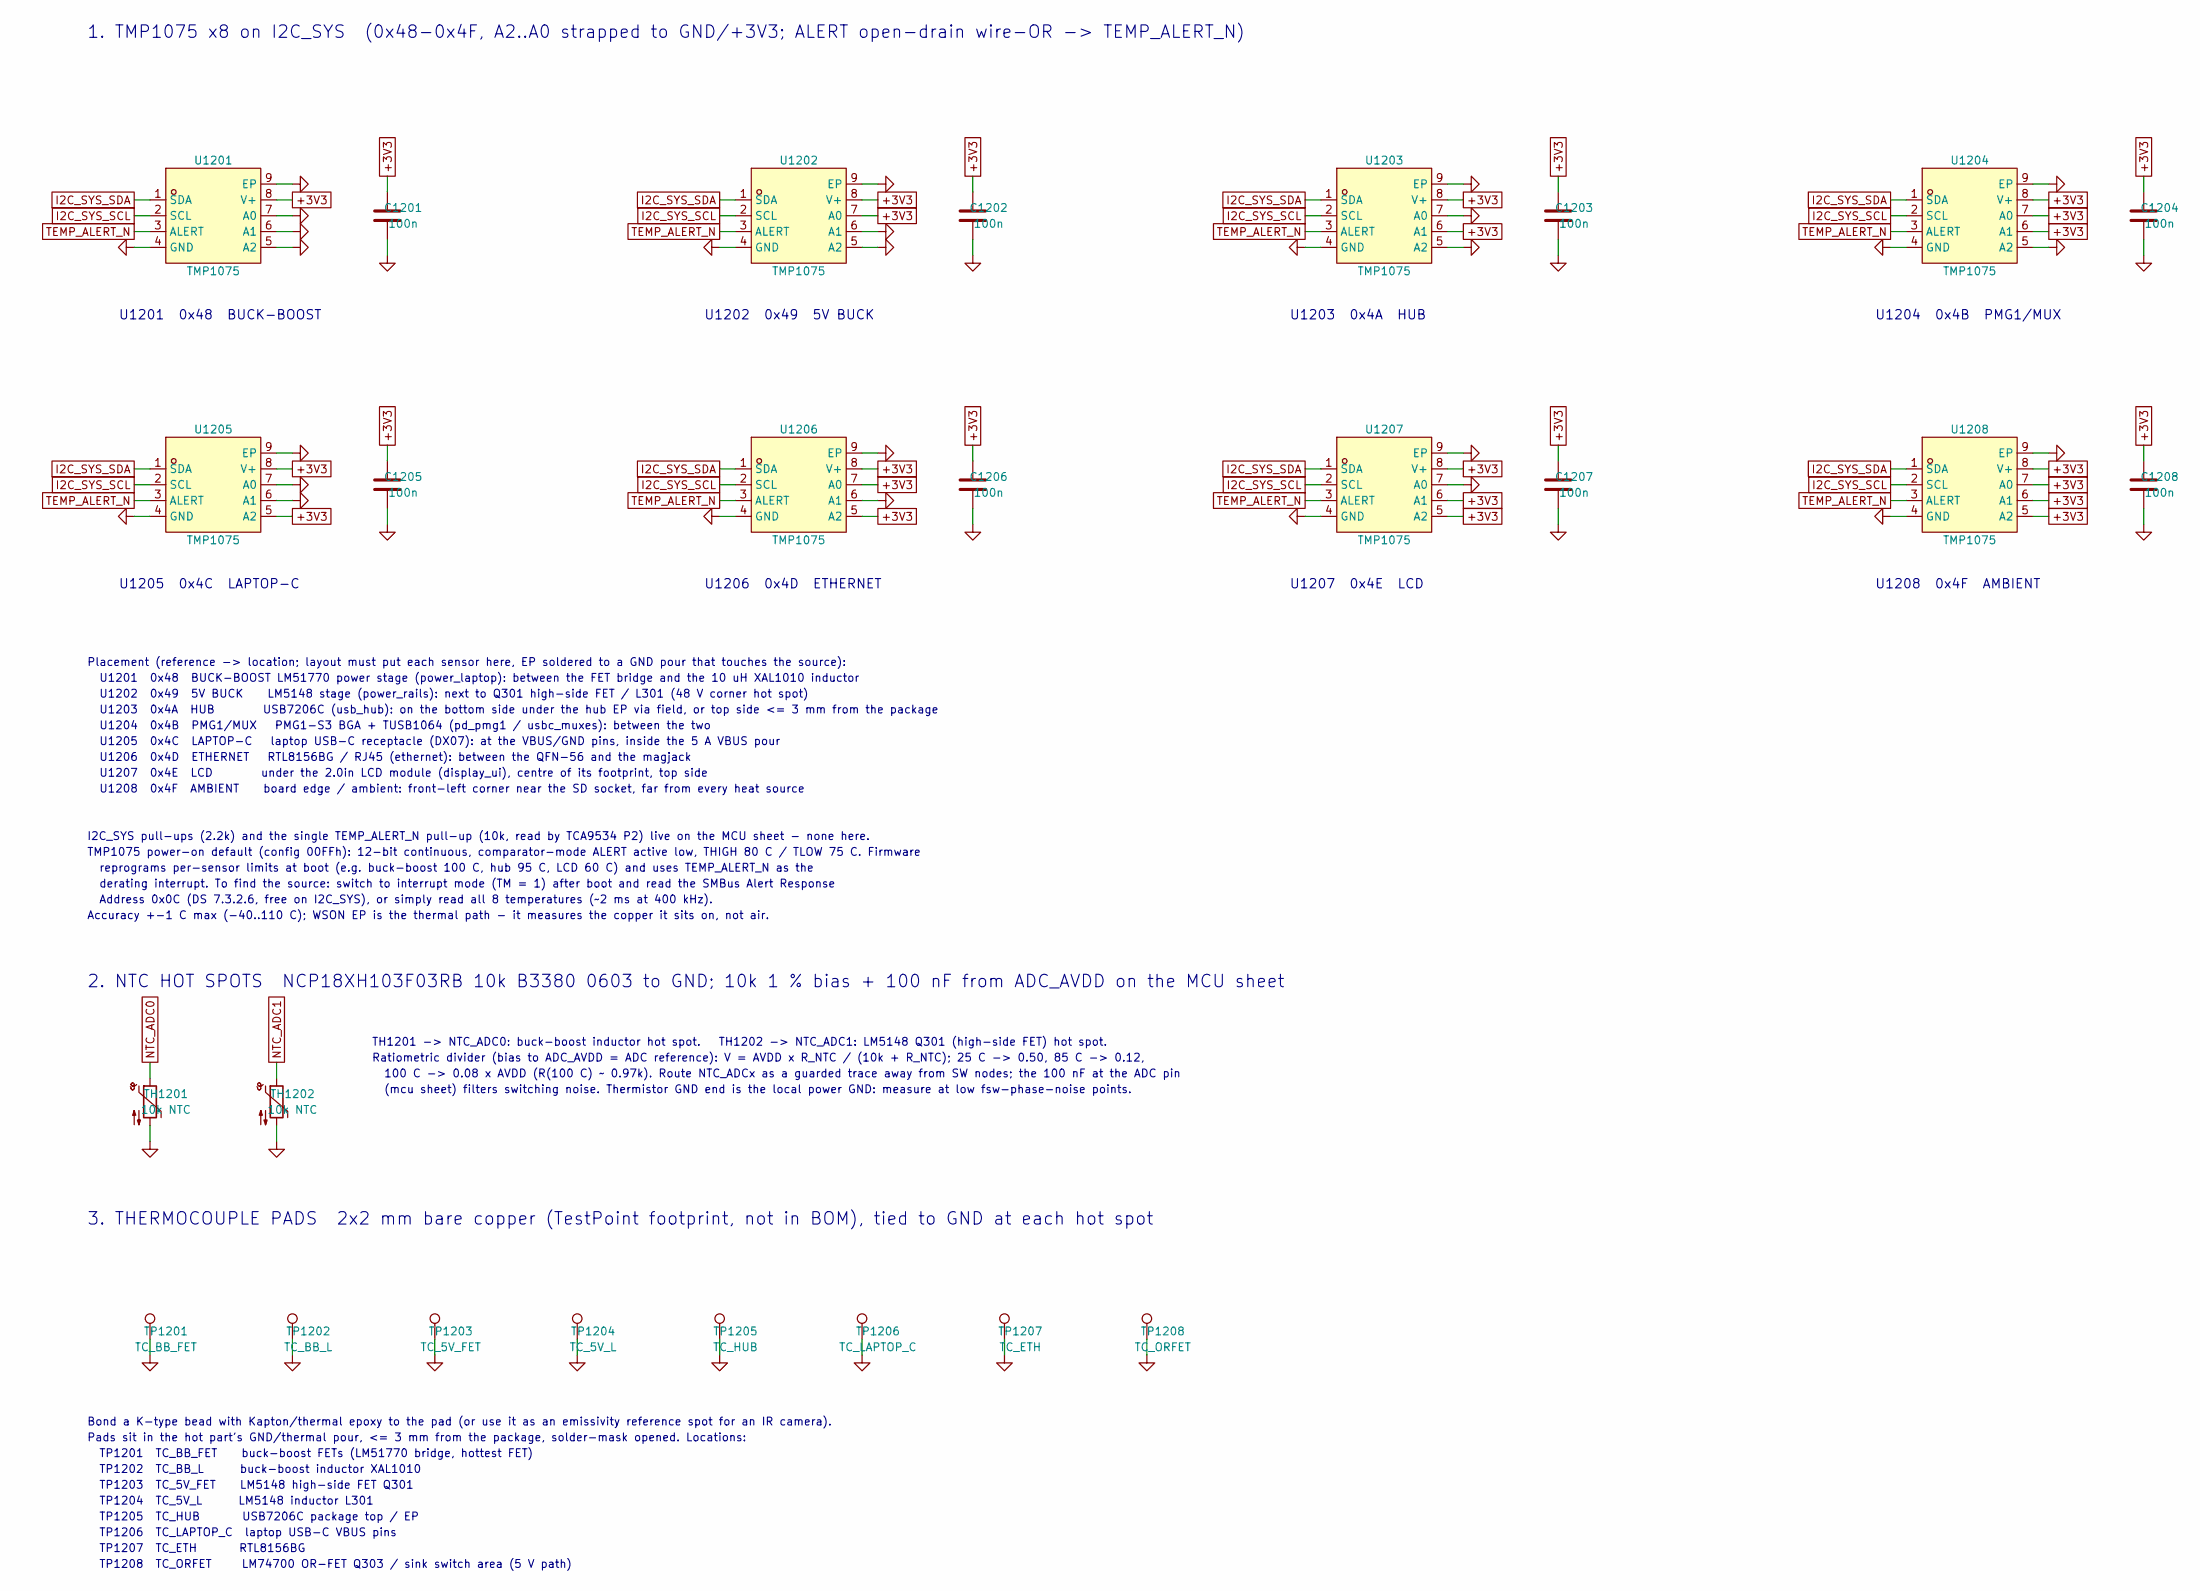
[picture p12: schematic sensors.kicad_sch, odock-10 — Thermal sensors]

Parts:
C1201, C1202, C1203, C1204, C1205, C1206, C1207, C1208: 100n; C_0402_1005Metric; LCSC C1525
TH1201, TH1202: 10k NTC; R_0603_1608Metric; LCSC C13564
TP1201: TC_BB_FET; TestPoint_Pad_2.0x2.0mm
TP1202: TC_BB_L; TestPoint_Pad_2.0x2.0mm
TP1203: TC_5V_FET; TestPoint_Pad_2.0x2.0mm
TP1204: TC_5V_L; TestPoint_Pad_2.0x2.0mm
TP1205: TC_HUB; TestPoint_Pad_2.0x2.0mm
TP1206: TC_LAPTOP_C; TestPoint_Pad_2.0x2.0mm
TP1207: TC_ETH; TestPoint_Pad_2.0x2.0mm
TP1208: TC_ORFET; TestPoint_Pad_2.0x2.0mm
U1201, U1202, U1203, U1204, U1205, U1206, U1207, U1208: TMP1075; WSON-8_L2.0-W2.0-P0.50-TL-EP; MPN TMP1075DSGR; LCSC C2870250

Connections:
+3V3: C1201.1, C1202.1, C1203.1, C1204.1, C1205.1, C1206.1, C1207.1, C1208.1, U1201.8 (V+), U1202.7 (A0), U1202.8 (V+), U1203.6 (A1), U1203.8 (V+), U1204.6 (A1), U1204.7 (A0), U1204.8 (V+), U1205.5 (A2), U1205.8 (V+), U1206.5 (A2), U1206.7 (A0), U1206.8 (V+), U1207.5 (A2), U1207.6 (A1), U1207.8 (V+), U1208.5 (A2), U1208.6 (A1), U1208.7 (A0), U1208.8 (V+); also elsewhere on the board
GND: C1201.2, C1202.2, C1203.2, C1204.2, C1205.2, C1206.2, C1207.2, C1208.2, TH1201.2, TH1202.2, TP1201.1, TP1202.1, TP1203.1, TP1204.1, TP1205.1, TP1206.1, TP1207.1, TP1208.1, U1201.4 (GND), U1201.5 (A2), U1201.6 (A1), U1201.7 (A0), U1201.9 (EP), U1202.4 (GND), U1202.5 (A2), U1202.6 (A1), U1202.9 (EP), U1203.4 (GND), U1203.5 (A2), U1203.7 (A0), U1203.9 (EP), U1204.4 (GND), U1204.5 (A2), U1204.9 (EP), U1205.4 (GND), U1205.6 (A1), U1205.7 (A0), U1205.9 (EP), U1206.4 (GND), U1206.6 (A1), U1206.9 (EP), U1207.4 (GND), U1207.7 (A0), U1207.9 (EP), U1208.4 (GND), U1208.9 (EP); also elsewhere on the board
I2C_SYS_SCL: U1201.2 (SCL), U1202.2 (SCL), U1203.2 (SCL), U1204.2 (SCL), U1205.2 (SCL), U1206.2 (SCL), U1207.2 (SCL), U1208.2 (SCL); also elsewhere on the board
I2C_SYS_SDA: U1201.1 (SDA), U1202.1 (SDA), U1203.1 (SDA), U1204.1 (SDA), U1205.1 (SDA), U1206.1 (SDA), U1207.1 (SDA), U1208.1 (SDA); also elsewhere on the board
NTC_ADC0: TH1201.1; also elsewhere on the board
NTC_ADC1: TH1202.1; also elsewhere on the board
TEMP_ALERT_N: U1201.3 (ALERT), U1202.3 (ALERT), U1203.3 (ALERT), U1204.3 (ALERT), U1205.3 (ALERT), U1206.3 (ALERT), U1207.3 (ALERT), U1208.3 (ALERT); also elsewhere on the board

Notes on the sheet:
1. TMP1075 x8 on I2C_SYS (0x48-0x4F, A2..A0 strapped to GND/+3V3; ALERT open-drain wire-OR -> TEMP_ALERT_N)
U1201 0x48 BUCK-BOOST
U1202 0x49 5V BUCK
U1203 0x4A HUB
U1204 0x4B PMG1/MUX
U1205 0x4C LAPTOP-C
U1206 0x4D ETHERNET
U1207 0x4E LCD
U1208 0x4F AMBIENT
Placement (reference -> location; layout must put each sensor here, EP soldered to a GND pour that touches the source):
U1201 0x48 BUCK-BOOST LM51770 power stage (power_laptop): between the FET bridge and the 10 uH XAL1010 inductor
U1202 0x49 5V BUCK LM5148 stage (power_rails): next to Q301 high-side FET / L301 (48 V corner hot spot)
U1203 0x4A HUB USB7206C (usb_hub): on the bottom side under the hub EP via field, or top side <= 3 mm from the package
U1204 0x4B PMG1/MUX PMG1-S3 BGA + TUSB1064 (pd_pmg1 / usbc_muxes): between the two
U1205 0x4C LAPTOP-C laptop USB-C receptacle (DX07): at the VBUS/GND pins, inside the 5 A VBUS pour
U1206 0x4D ETHERNET RTL8156BG / RJ45 (ethernet): between the QFN-56 and the magjack
U1207 0x4E LCD under the 2.0in LCD module (display_ui), centre of its footprint, top side
U1208 0x4F AMBIENT board edge / ambient: front-left corner near the SD socket, far from every heat source
I2C_SYS pull-ups (2.2k) and the single TEMP_ALERT_N pull-up (10k, read by TCA9534 P2) live on the MCU sheet - none here.
TMP1075 power-on default (config 00FFh): 12-bit continuous, comparator-mode ALERT active low, THIGH 80 C / TLOW 75 C. Firmware
reprograms per-sensor limits at boot (e.g. buck-boost 100 C, hub 95 C, LCD 60 C) and uses TEMP_ALERT_N as the
derating interrupt. To find the source: switch to interrupt mode (TM = 1) after boot and read the SMBus Alert Response
Address 0x0C (DS 7.3.2.6, free on I2C_SYS), or simply read all 8 temperatures (~2 ms at 400 kHz).
Accuracy +-1 C max (-40..110 C); WSON EP is the thermal path - it measures the copper it sits on, not air.
2. NTC HOT SPOTS NCP18XH103F03RB 10k B3380 0603 to GND; 10k 1 % bias + 100 nF from ADC_AVDD on the MCU sheet
TH1201 -> NTC_ADC0: buck-boost inductor hot spot. TH1202 -> NTC_ADC1: LM5148 Q301 (high-side FET) hot spot.
Ratiometric divider (bias to ADC_AVDD = ADC reference): V = AVDD x R_NTC / (10k + R_NTC); 25 C -> 0.50, 85 C -> 0.12,
100 C -> 0.08 x AVDD (R(100 C) ~ 0.97k). Route NTC_ADCx as a guarded trace away from SW nodes; the 100 nF at the ADC pin
(mcu sheet) filters switching noise. Thermistor GND end is the local power GND: measure at low fsw-phase-noise points.
3. THERMOCOUPLE PADS 2x2 mm bare copper (TestPoint footprint, not in BOM), tied to GND at each hot spot
Bond a K-type bead with Kapton/thermal epoxy to the pad (or use it as an emissivity reference spot for an IR camera).
Pads sit in the hot part's GND/thermal pour, <= 3 mm from the package, solder-mask opened. Locations:
TP1201 TC_BB_FET buck-boost FETs (LM51770 bridge, hottest FET)
TP1202 TC_BB_L buck-boost inductor XAL1010
TP1203 TC_5V_FET LM5148 high-side FET Q301
TP1204 TC_5V_L LM5148 inductor L301
TP1205 TC_HUB USB7206C package top / EP
TP1206 TC_LAPTOP_C laptop USB-C VBUS pins
TP1207 TC_ETH RTL8156BG
TP1208 TC_ORFET LM74700 OR-FET Q303 / sink switch area (5 V path)

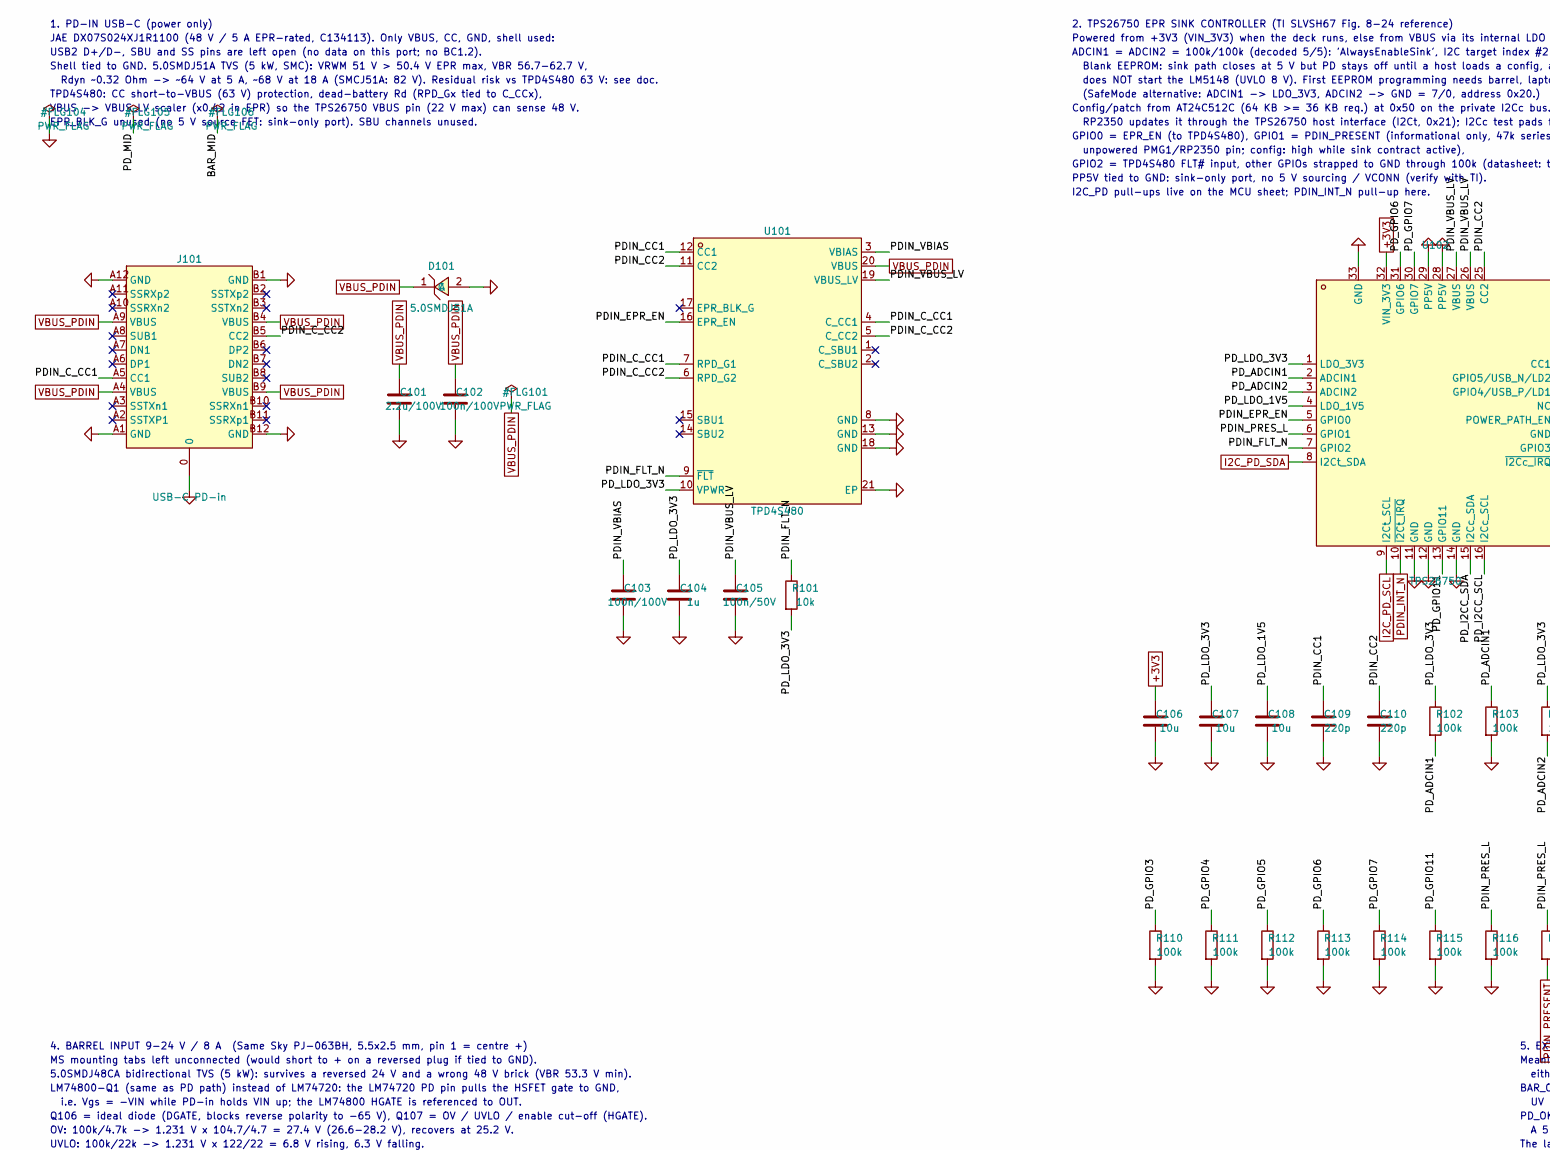
[picture p13: schematic power_input.kicad_sch, odock-10 — Power input (PD-in, barrel, VIN), part in row 1, column 1]

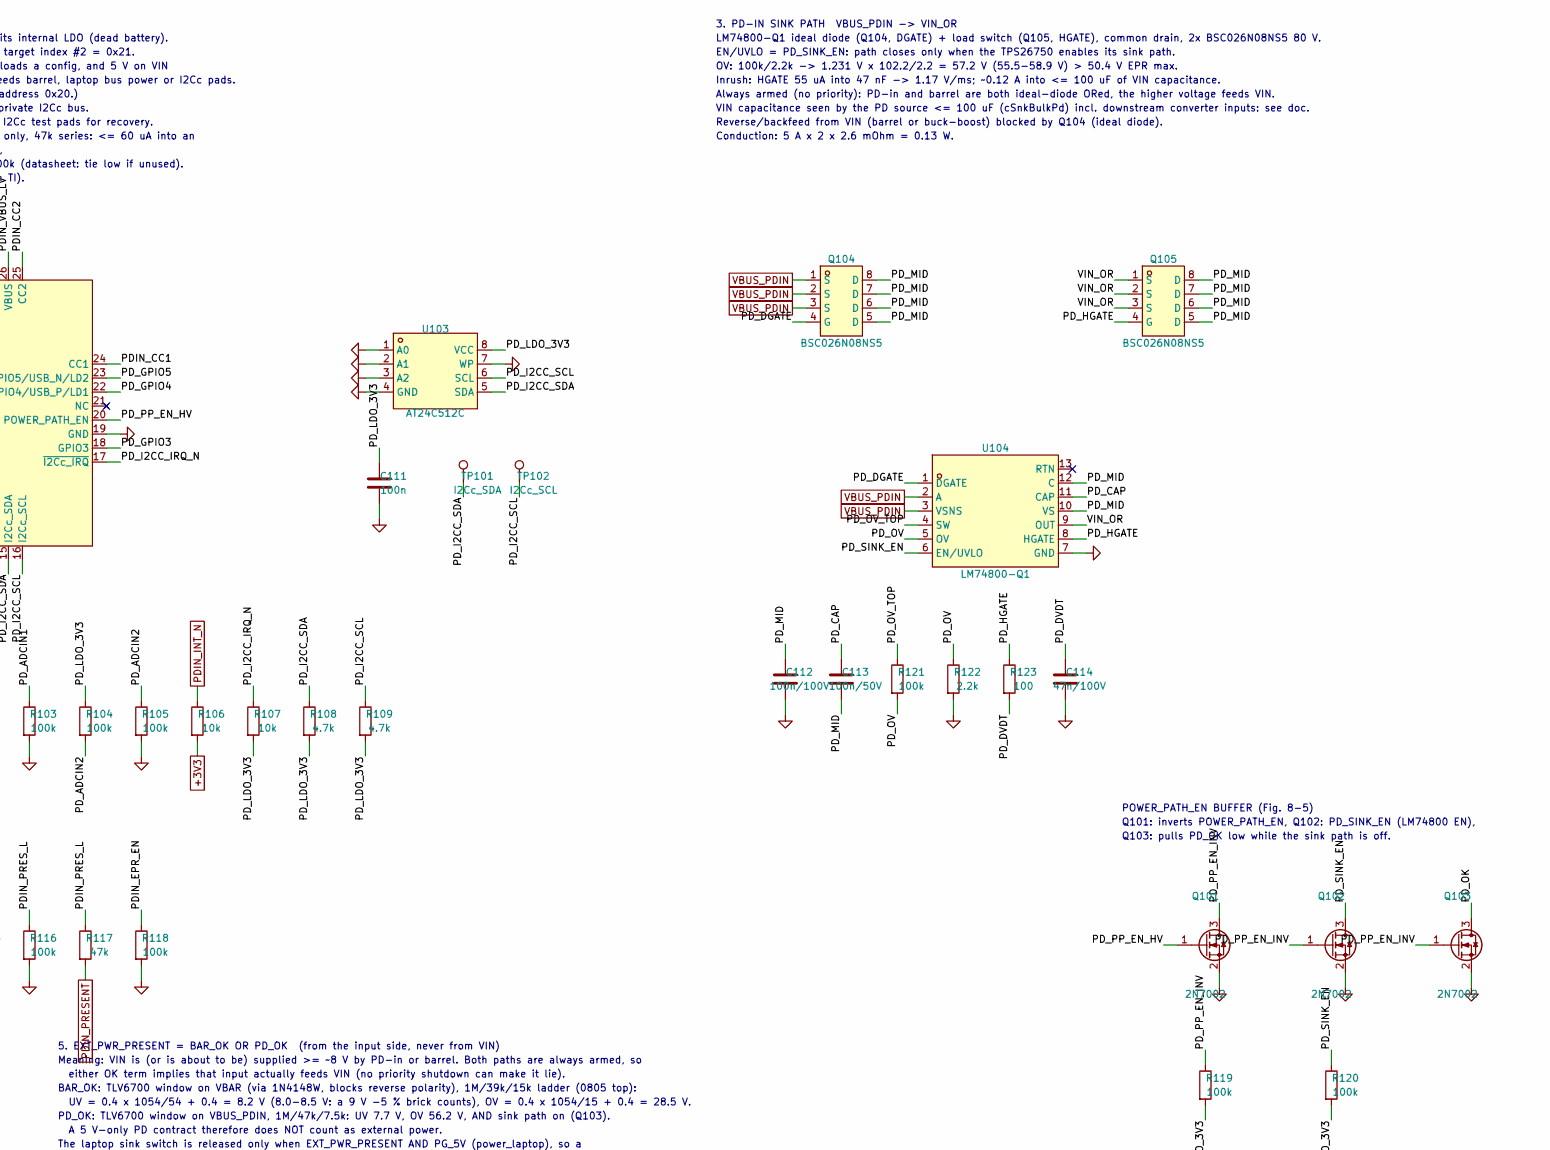
[picture p14: schematic power_input.kicad_sch, odock-10 — Power input (PD-in, barrel, VIN), part in row 1, column 2]

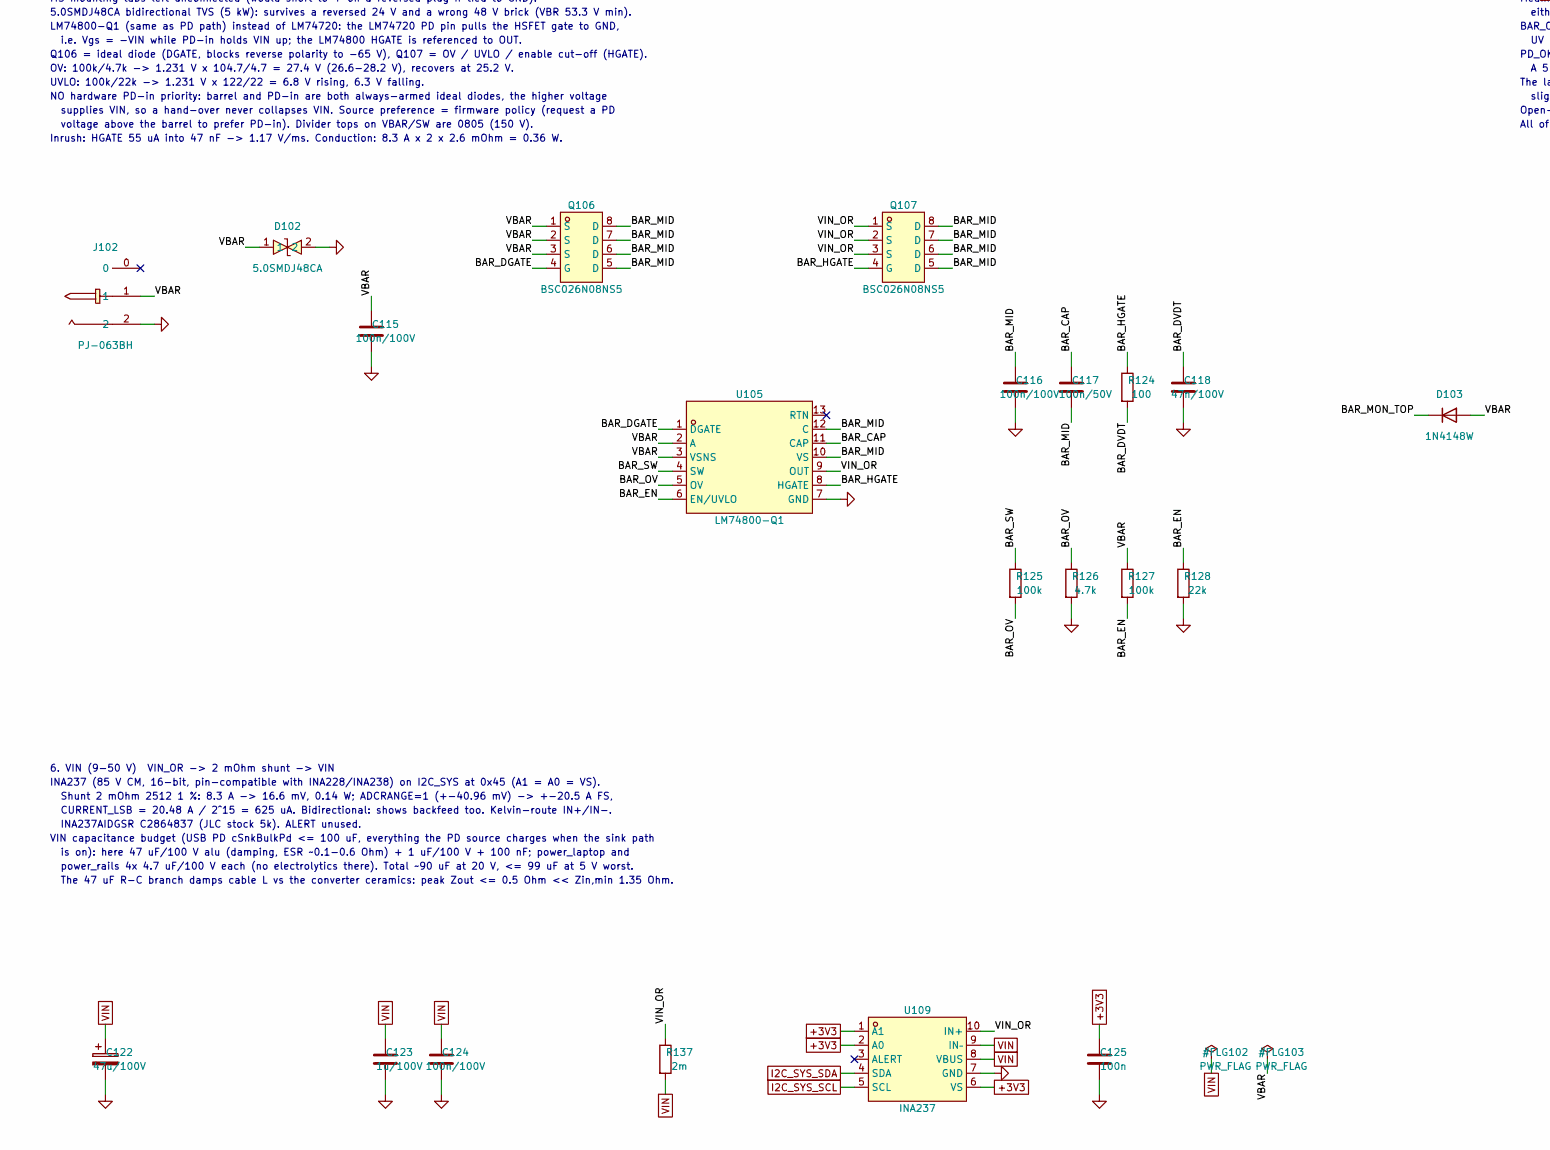
[picture p15: schematic power_input.kicad_sch, odock-10 — Power input (PD-in, barrel, VIN), part in row 2, column 1]

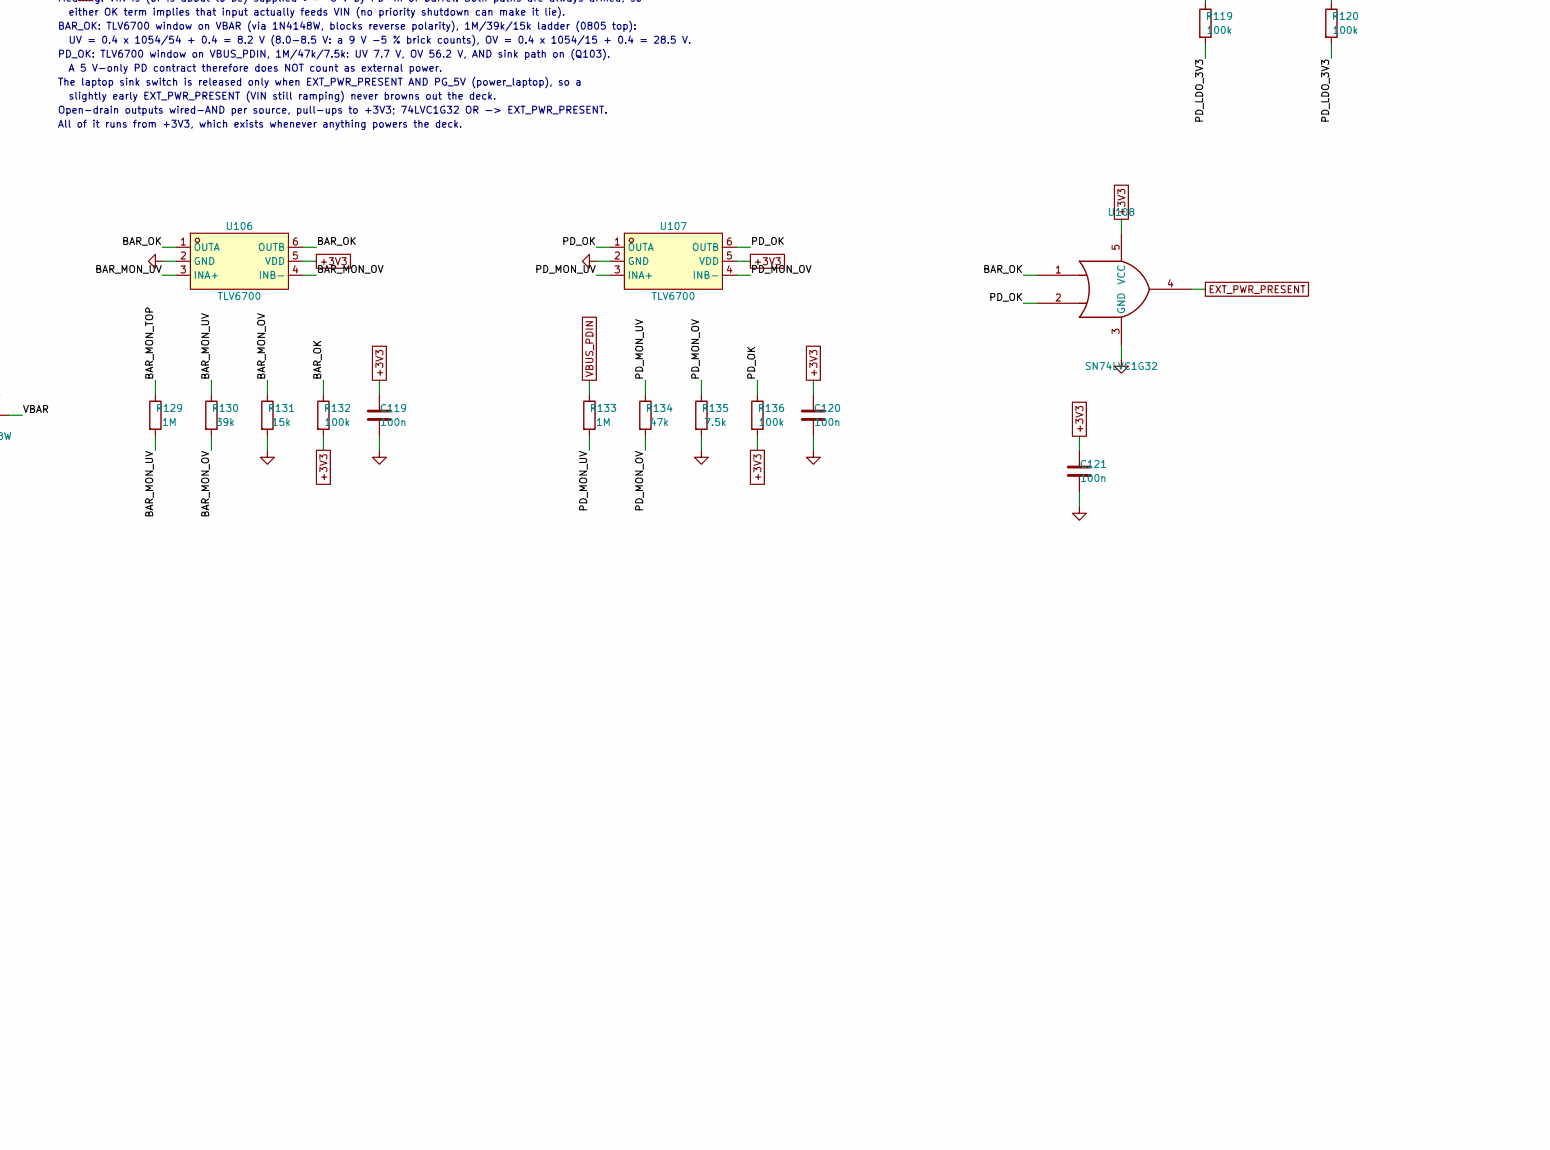
[picture p16: schematic power_input.kicad_sch, odock-10 — Power input (PD-in, barrel, VIN), part in row 2, column 2]

Parts:
C101: 2.2u/100V; C_1210_3225Metric; LCSC C153036
C102, C103, C112, C115, C116, C124: 100n/100V; C_0805_2012Metric; LCSC C28233
C104: 1u; C_0402_1005Metric; LCSC C52923
C105, C113, C117: 100n/50V; C_0603_1608Metric; LCSC C14663
C106, C107, C108: 10u; C_0603_1608Metric; LCSC C19702
C109, C110: 220p; C_0603_1608Metric; LCSC C1603
C111, C119, C120, C121, C125: 100n; C_0402_1005Metric; LCSC C1525
C114, C118: 47n/100V; C_0603_1608Metric; LCSC C576852
C122: 47u/100V; CP_Elec_10x10; LCSC C371305
C123: 1u/100V; C_0805_2012Metric; LCSC C126585
D101: 5.0SMDJ51A; SMC_L6.9-W5.9-LS7.9-RD; MPN 5.0SMDJ51A; LCSC C2990373
D102: 5.0SMDJ48CA; SMC_L6.9-W5.9-LS7.9-BI; MPN 5.0SMDJ48CA; LCSC C2649886
D103: 1N4148W; D_SOD-123; LCSC C81598
J101: USB-C PD-in; USB-C-TH_DX07S024XJ1R1100-1; MPN DX07S024XJ1R1100; LCSC C134113
J102: PJ-063BH; DC-IN_PJ-063BH; MPN PJ-063BH; LCSC C3095900
Q101, Q102, Q103: 2N7002; SOT-23; LCSC C8545
Q104, Q105, Q106, Q107: BSC026N08NS5; PG-TDSON-8_L5.0-W6.0-P1.27-BL-EP; MPN BSC026N08NS5ATMA1; LCSC C5955453
R101, R106, R107: 10k; R_0402_1005Metric; LCSC C25744
R102, R103, R104, R105, R110, R111, R112, R113, R114, R115, R116, R118, R119, R120, R132, R136: 100k; R_0402_1005Metric; LCSC C25741
R108, R109, R126: 4.7k; R_0402_1005Metric; LCSC C25900
R117, R134: 47k; R_0402_1005Metric; LCSC C25792
R121, R125, R127: 100k; R_0805_2012Metric; LCSC C149504
R122: 2.2k; R_0402_1005Metric; LCSC C25879
R123, R124: 100; R_0402_1005Metric; LCSC C25076
R128: 22k; R_0402_1005Metric; LCSC C25768
R129, R133: 1M; R_0805_2012Metric; LCSC C17514
R130: 39k; R_0603_1608Metric; LCSC C23153
R131: 15k; R_0402_1005Metric; LCSC C25756
R135: 7.5k; R_0603_1608Metric; LCSC C23234
R137: 2m; R_2512_6332Metric; MPN RLP25FEGR002; LCSC C459679
TP101: I2Cc_SDA; TestPoint_Pad_D1.0mm
TP102: I2Cc_SCL; TestPoint_Pad_D1.0mm
U101: TPD4S480; WQFN-20_L3.0-W3.0-P0.40-BL-EP1.7; MPN TPD4S480RUKR; LCSC C43131250
U102: TPS26750; QFN-32_L4.0-W4.0-P0.40-BL-EP2.8; MPN TPS26750SRSMR; LCSC C42166327
U103: AT24C512C; SOIC-8_L4.9-W3.9-P1.27-LS6.0-BL; MPN AT24C512C-SSHD-T; LCSC C12371
U104, U105: LM74800-Q1; WSON-12_L3.0-W3.0-P0.50-TL-EP-2; MPN LM74800QDRRRQ1; LCSC C3215600
U106, U107: TLV6700; TSOT-23-6_L2.9-W1.6-P0.95-LS2.8-BR; MPN TLV6700DDCR; LCSC C2868382
U108: SN74LVC1G32; SOT-23-5; LCSC C10096
U109: INA237; VSSOP-10_L3.0-W3.0-P0.50-LS4.9-BL; MPN INA237AIDGSR; LCSC C2864837

Connections:
+3V3: C106.1, C119.1, C120.1, C121.1, C125.1, R106.2, R132.2, R136.2, U102.32 (VIN_3V3), U106.5 (VDD), U107.5 (VDD), U108.5 (VCC), U109.1 (A1), U109.2 (A0), U109.6 (VS); also elsewhere on the board
/Power input/BAR_CAP: C117.1, U105.11 (CAP)
/Power input/BAR_DGATE: Q106.4 (G), U105.1 (DGATE)
/Power input/BAR_DVDT: C118.1, R124.2
/Power input/BAR_EN: R127.2, R128.1, U105.6 (EN/UVLO)
/Power input/BAR_HGATE: Q107.4 (G), R124.1, U105.8 (HGATE)
/Power input/BAR_MID: C116.1, C117.2, Q106.5 (D), Q106.6 (D), Q106.7 (D), Q106.8 (D), Q107.5 (D), Q107.6 (D), Q107.7 (D), Q107.8 (D), U105.10 (VS), U105.12 (C)
/Power input/BAR_MON_OV: R130.2, R131.1, U106.4 (INB-)
/Power input/BAR_MON_TOP: D103.1 (K), R129.1
/Power input/BAR_MON_UV: R129.2, R130.1, U106.3 (INA+)
/Power input/BAR_OK: R132.1, U106.1 (OUTA), U106.6 (OUTB), U108.1
/Power input/BAR_OV: R125.2, R126.1, U105.5 (OV)
/Power input/BAR_SW: R125.1, U105.4 (SW)
/Power input/PDIN_CC1: C109.1, U101.12 (CC1), U102.24 (CC1)
/Power input/PDIN_CC2: C110.1, U101.11 (CC2), U102.25 (CC2)
/Power input/PDIN_C_CC1: J101.A5 (CC1), U101.4 (C_CC1), U101.7 (RPD_G1)
/Power input/PDIN_C_CC2: J101.B5 (CC2), U101.5 (C_CC2), U101.6 (RPD_G2)
/Power input/PDIN_EPR_EN: R118.1, U101.16 (EPR_EN), U102.5 (GPIO0)
/Power input/PDIN_FLT_N: R101.1, U101.9 (~FLT), U102.7 (GPIO2)
/Power input/PDIN_PRES_L: R116.1, R117.1, U102.6 (GPIO1)
/Power input/PDIN_VBIAS: C103.1, U101.3 (VBIAS)
/Power input/PDIN_VBUS_LV: C105.1, U101.19 (VBUS_LV), U102.26 (VBUS), U102.27 (VBUS)
/Power input/PD_ADCIN1: R102.2, R103.1, U102.2 (ADCIN1)
/Power input/PD_ADCIN2: R104.2, R105.1, U102.3 (ADCIN2)
/Power input/PD_CAP: C113.1, U104.11 (CAP)
/Power input/PD_DGATE: Q104.4 (G), U104.1 (DGATE)
/Power input/PD_DVDT: C114.1, R123.2
/Power input/PD_GPIO3: R110.1, U102.18 (GPIO3)
/Power input/PD_GPIO4: R111.1, U102.22 (GPIO4/USB_P/LD1)
/Power input/PD_GPIO5: R112.1, U102.23 (GPIO5/USB_N/LD2)
/Power input/PD_GPIO6: R113.1, U102.31 (GPIO6)
/Power input/PD_GPIO7: R114.1, U102.30 (GPIO7)
/Power input/PD_GPIO11: R115.1, U102.13 (GPIO11)
/Power input/PD_HGATE: Q105.4 (G), R123.1, U104.8 (HGATE)
/Power input/PD_I2CC_IRQ_N: R107.1, U102.17 (~I2Cc_IRQ)
/Power input/PD_I2CC_SCL: R109.1, TP102.1, U102.16 (I2Cc_SCL), U103.6 (SCL)
/Power input/PD_I2CC_SDA: R108.1, TP101.1, U102.15 (I2Cc_SDA), U103.5 (SDA)
/Power input/PD_LDO_1V5: C108.1, U102.4 (LDO_1V5)
/Power input/PD_LDO_3V3: C104.1, C107.1, C111.1, R101.2, R102.1, R104.1, R107.2, R108.2, R109.2, R119.2, R120.2, U101.10 (VPWR), U102.1 (LDO_3V3), U103.8 (VCC)
/Power input/PD_MID: C112.1, C113.2, Q104.5 (D), Q104.6 (D), Q104.7 (D), Q104.8 (D), Q105.5 (D), Q105.6 (D), Q105.7 (D), Q105.8 (D), U104.10 (VS), U104.12 (C)
/Power input/PD_MON_OV: R134.2, R135.1, U107.4 (INB-)
/Power input/PD_MON_UV: R133.2, R134.1, U107.3 (INA+)
/Power input/PD_OK: Q103.3 (D), R136.1, U107.1 (OUTA), U107.6 (OUTB), U108.2
/Power input/PD_OV: R121.2, R122.1, U104.5 (OV)
/Power input/PD_OV_TOP: R121.1, U104.4 (SW)
/Power input/PD_PP_EN_HV: Q101.1 (G), U102.20 (POWER_PATH_EN)
/Power input/PD_PP_EN_INV: Q101.3 (D), Q102.1 (G), Q103.1 (G), R119.1
/Power input/PD_SINK_EN: Q102.3 (D), R120.1, U104.6 (EN/UVLO)
/Power input/VBAR: C115.1, D102.1, D103.2 (A), J102.1, Q106.1 (S), Q106.2 (S), Q106.3 (S), R127.1, U105.2 (A), U105.3 (VSNS)
/Power input/VIN_OR: Q105.1 (S), Q105.2 (S), Q105.3 (S), Q107.1 (S), Q107.2 (S), Q107.3 (S), R137.1, U104.9 (OUT), U105.9 (OUT), U109.10 (IN+)
EXT_PWR_PRESENT: U108.4; also elsewhere on the board
GND: C101.2, C102.2, C103.2, C104.2, C105.2, C106.2, C107.2, C108.2, C109.2, C110.2, C111.2, C112.2, C114.2, C115.2, C116.2, C118.2, C119.2, C120.2, C121.2, C122.2, C123.2, C124.2, C125.2, D101.2 (A), D102.2, J101.0, J101.A1 (GND), J101.A12 (GND), J101.B1 (GND), J101.B12 (GND), J102.2, Q101.2 (S), Q102.2 (S), Q103.2 (S), R103.2, R105.2, R110.2, R111.2, R112.2, R113.2, R114.2, R115.2, R116.2, R118.2, R122.2, R126.2, R128.2, R131.2, R135.2, U101.8 (GND), U101.13 (GND), U101.18 (GND), U101.21 (EP), U102.11 (GND), U102.12 (GND), U102.14 (GND), U102.19 (GND), U102.28 (PP5V), U102.29 (PP5V), U102.33 (GND), U103.1 (A0), U103.2 (A1), U103.3 (A2), U103.4 (GND), U103.7 (WP), U104.7 (GND), U105.7 (GND), U106.2 (GND), U107.2 (GND), U108.3 (GND), U109.7 (GND); also elsewhere on the board
I2C_PD_SCL: U102.9 (I2Ct_SCL); also elsewhere on the board
I2C_PD_SDA: U102.8 (I2Ct_SDA); also elsewhere on the board
I2C_SYS_SCL: U109.5 (SCL); also elsewhere on the board
I2C_SYS_SDA: U109.4 (SDA); also elsewhere on the board
PDIN_INT_N: R106.1, U102.10 (~I2Ct_IRQ); also elsewhere on the board
PDIN_PRESENT: R117.2; also elsewhere on the board
VBUS_PDIN: C101.1, C102.1, D101.1 (C), J101.A4 (VBUS), J101.A9 (VBUS), J101.B4 (VBUS), J101.B9 (VBUS), Q104.1 (S), Q104.2 (S), Q104.3 (S), R133.1, U101.20 (VBUS), U104.2 (A), U104.3 (VSNS)
VIN: C122.1, C123.1, C124.1, R137.2, U109.8 (VBUS), U109.9 (IN–); also elsewhere on the board

Notes on the sheet:
1. PD-IN USB-C (power only)
JAE DX07S024XJ1R1100 (48 V / 5 A EPR-rated, C134113). Only VBUS, CC, GND, shell used:
USB2 D+/D-, SBU and SS pins are left open (no data on this port; no BC1.2).
Shell tied to GND. 5.0SMDJ51A TVS (5 kW, SMC): VRWM 51 V > 50.4 V EPR max, VBR 56.7-62.7 V,
Rdyn ~0.32 Ohm -> ~64 V at 5 A, ~68 V at 18 A (SMCJ51A: 82 V). Residual risk vs TPD4S480 63 V: see doc.
TPD4S480: CC short-to-VBUS (63 V) protection, dead-battery Rd (RPD_Gx tied to C_CCx),
VBUS -> VBUS_LV scaler (x0.42 in EPR) so the TPS26750 VBUS pin (22 V max) can sense 48 V.
EPR_BLK_G unused (no 5 V source FET: sink-only port). SBU channels unused.
2. TPS26750 EPR SINK CONTROLLER (TI SLVSH67 Fig. 8-24 reference)
Powered from +3V3 (VIN_3V3) when the deck runs, else from VBUS via its internal LDO (dead battery).
ADCIN1 = ADCIN2 = 100k/100k (decoded 5/5): 'AlwaysEnableSink', I2C target index #2 = 0x21.
Blank EEPROM: sink path closes at 5 V but PD stays off until a host loads a config, and 5 V on VIN
does NOT start the LM5148 (UVLO 8 V). First EEPROM programming needs barrel, laptop bus power or I2Cc pads.
(SafeMode alternative: ADCIN1 -> LDO_3V3, ADCIN2 -> GND = 7/0, address 0x20.)
Config/patch from AT24C512C (64 KB >= 36 KB req.) at 0x50 on the private I2Cc bus.
RP2350 updates it through the TPS26750 host interface (I2Ct, 0x21); I2Cc test pads for recovery.
GPIO0 = EPR_EN (to TPD4S480), GPIO1 = PDIN_PRESENT (informational only, 47k series: <= 60 uA into an
unpowered PMG1/RP2350 pin; config: high while sink contract active),
GPIO2 = TPD4S480 FLT# input, other GPIOs strapped to GND through 100k (datasheet: tie low if unused).
PP5V tied to GND: sink-only port, no 5 V sourcing / VCONN (verify with TI).
I2C_PD pull-ups live on the MCU sheet; PDIN_INT_N pull-up here.
POWER_PATH_EN BUFFER (Fig. 8-5)
Q101: inverts POWER_PATH_EN, Q102: PD_SINK_EN (LM74800 EN),
Q103: pulls PD_OK low while the sink path is off.
3. PD-IN SINK PATH VBUS_PDIN -> VIN_OR
LM74800-Q1 ideal diode (Q104, DGATE) + load switch (Q105, HGATE), common drain, 2x BSC026N08NS5 80 V.
EN/UVLO = PD_SINK_EN: path closes only when the TPS26750 enables its sink path.
OV: 100k/2.2k -> 1.231 V x 102.2/2.2 = 57.2 V (55.5-58.9 V) > 50.4 V EPR max.
Inrush: HGATE 55 uA into 47 nF -> 1.17 V/ms; ~0.12 A into <= 100 uF of VIN capacitance.
Always armed (no priority): PD-in and barrel are both ideal-diode ORed, the higher voltage feeds VIN.
VIN capacitance seen by the PD source <= 100 uF (cSnkBulkPd) incl. downstream converter inputs: see doc.
Reverse/backfeed from VIN (barrel or buck-boost) blocked by Q104 (ideal diode).
Conduction: 5 A x 2 x 2.6 mOhm = 0.13 W.
4. BARREL INPUT 9-24 V / 8 A (Same Sky PJ-063BH, 5.5x2.5 mm, pin 1 = centre +)
MS mounting tabs left unconnected (would short to + on a reversed plug if tied to GND).
5.0SMDJ48CA bidirectional TVS (5 kW): survives a reversed 24 V and a wrong 48 V brick (VBR 53.3 V min).
LM74800-Q1 (same as PD path) instead of LM74720: the LM74720 PD pin pulls the HSFET gate to GND,
i.e. Vgs = -VIN while PD-in holds VIN up; the LM74800 HGATE is referenced to OUT.
Q106 = ideal diode (DGATE, blocks reverse polarity to -65 V), Q107 = OV / UVLO / enable cut-off (HGATE).
OV: 100k/4.7k -> 1.231 V x 104.7/4.7 = 27.4 V (26.6-28.2 V), recovers at 25.2 V.
UVLO: 100k/22k -> 1.231 V x 122/22 = 6.8 V rising, 6.3 V falling.
NO hardware PD-in priority: barrel and PD-in are both always-armed ideal diodes, the higher voltage
supplies VIN, so a hand-over never collapses VIN. Source preference = firmware policy (request a PD
voltage above the barrel to prefer PD-in). Divider tops on VBAR/SW are 0805 (150 V).
Inrush: HGATE 55 uA into 47 nF -> 1.17 V/ms. Conduction: 8.3 A x 2 x 2.6 mOhm = 0.36 W.
5. EXT_PWR_PRESENT = BAR_OK OR PD_OK (from the input side, never from VIN)
Meaning: VIN is (or is about to be) supplied >= ~8 V by PD-in or barrel. Both paths are always armed, so
either OK term implies that input actually feeds VIN (no priority shutdown can make it lie).
BAR_OK: TLV6700 window on VBAR (via 1N4148W, blocks reverse polarity), 1M/39k/15k ladder (0805 top):
UV = 0.4 x 1054/54 + 0.4 = 8.2 V (8.0-8.5 V: a 9 V -5 % brick counts), OV = 0.4 x 1054/15 + 0.4 = 28.5 V.
PD_OK: TLV6700 window on VBUS_PDIN, 1M/47k/7.5k: UV 7.7 V, OV 56.2 V, AND sink path on (Q103).
A 5 V-only PD contract therefore does NOT count as external power.
The laptop sink switch is released only when EXT_PWR_PRESENT AND PG_5V (power_laptop), so a
slightly early EXT_PWR_PRESENT (VIN still ramping) never browns out the deck.
Open-drain outputs wired-AND per source, pull-ups to +3V3; 74LVC1G32 OR -> EXT_PWR_PRESENT.
All of it runs from +3V3, which exists whenever anything powers the deck.
6. VIN (9-50 V) VIN_OR -> 2 mOhm shunt -> VIN
INA237 (85 V CM, 16-bit, pin-compatible with INA228/INA238) on I2C_SYS at 0x45 (A1 = A0 = VS).
Shunt 2 mOhm 2512 1 %: 8.3 A -> 16.6 mV, 0.14 W; ADCRANGE=1 (+-40.96 mV) -> +-20.5 A FS,
CURRENT_LSB = 20.48 A / 2^15 = 625 uA. Bidirectional: shows backfeed too. Kelvin-route IN+/IN-.
INA237AIDGSR C2864837 (JLC stock 5k). ALERT unused.
VIN capacitance budget (USB PD cSnkBulkPd <= 100 uF, everything the PD source charges when the sink path
is on): here 47 uF/100 V alu (damping, ESR ~0.1-0.6 Ohm) + 1 uF/100 V + 100 nF; power_laptop and
power_rails 4x 4.7 uF/100 V each (no electrolytics there). Total ~90 uF at 20 V, <= 99 uF at 5 V worst.
The 47 uF R-C branch damps cable L vs the converter ceramics: peak Zout <= 0.5 Ohm << Zin,min 1.35 Ohm.
