KarpelesLab/odock/hardware/odock-10/odock-10.kicad_pcb

## KiCad design hardware/odock-10/odock-10.kicad_pcb (continued)

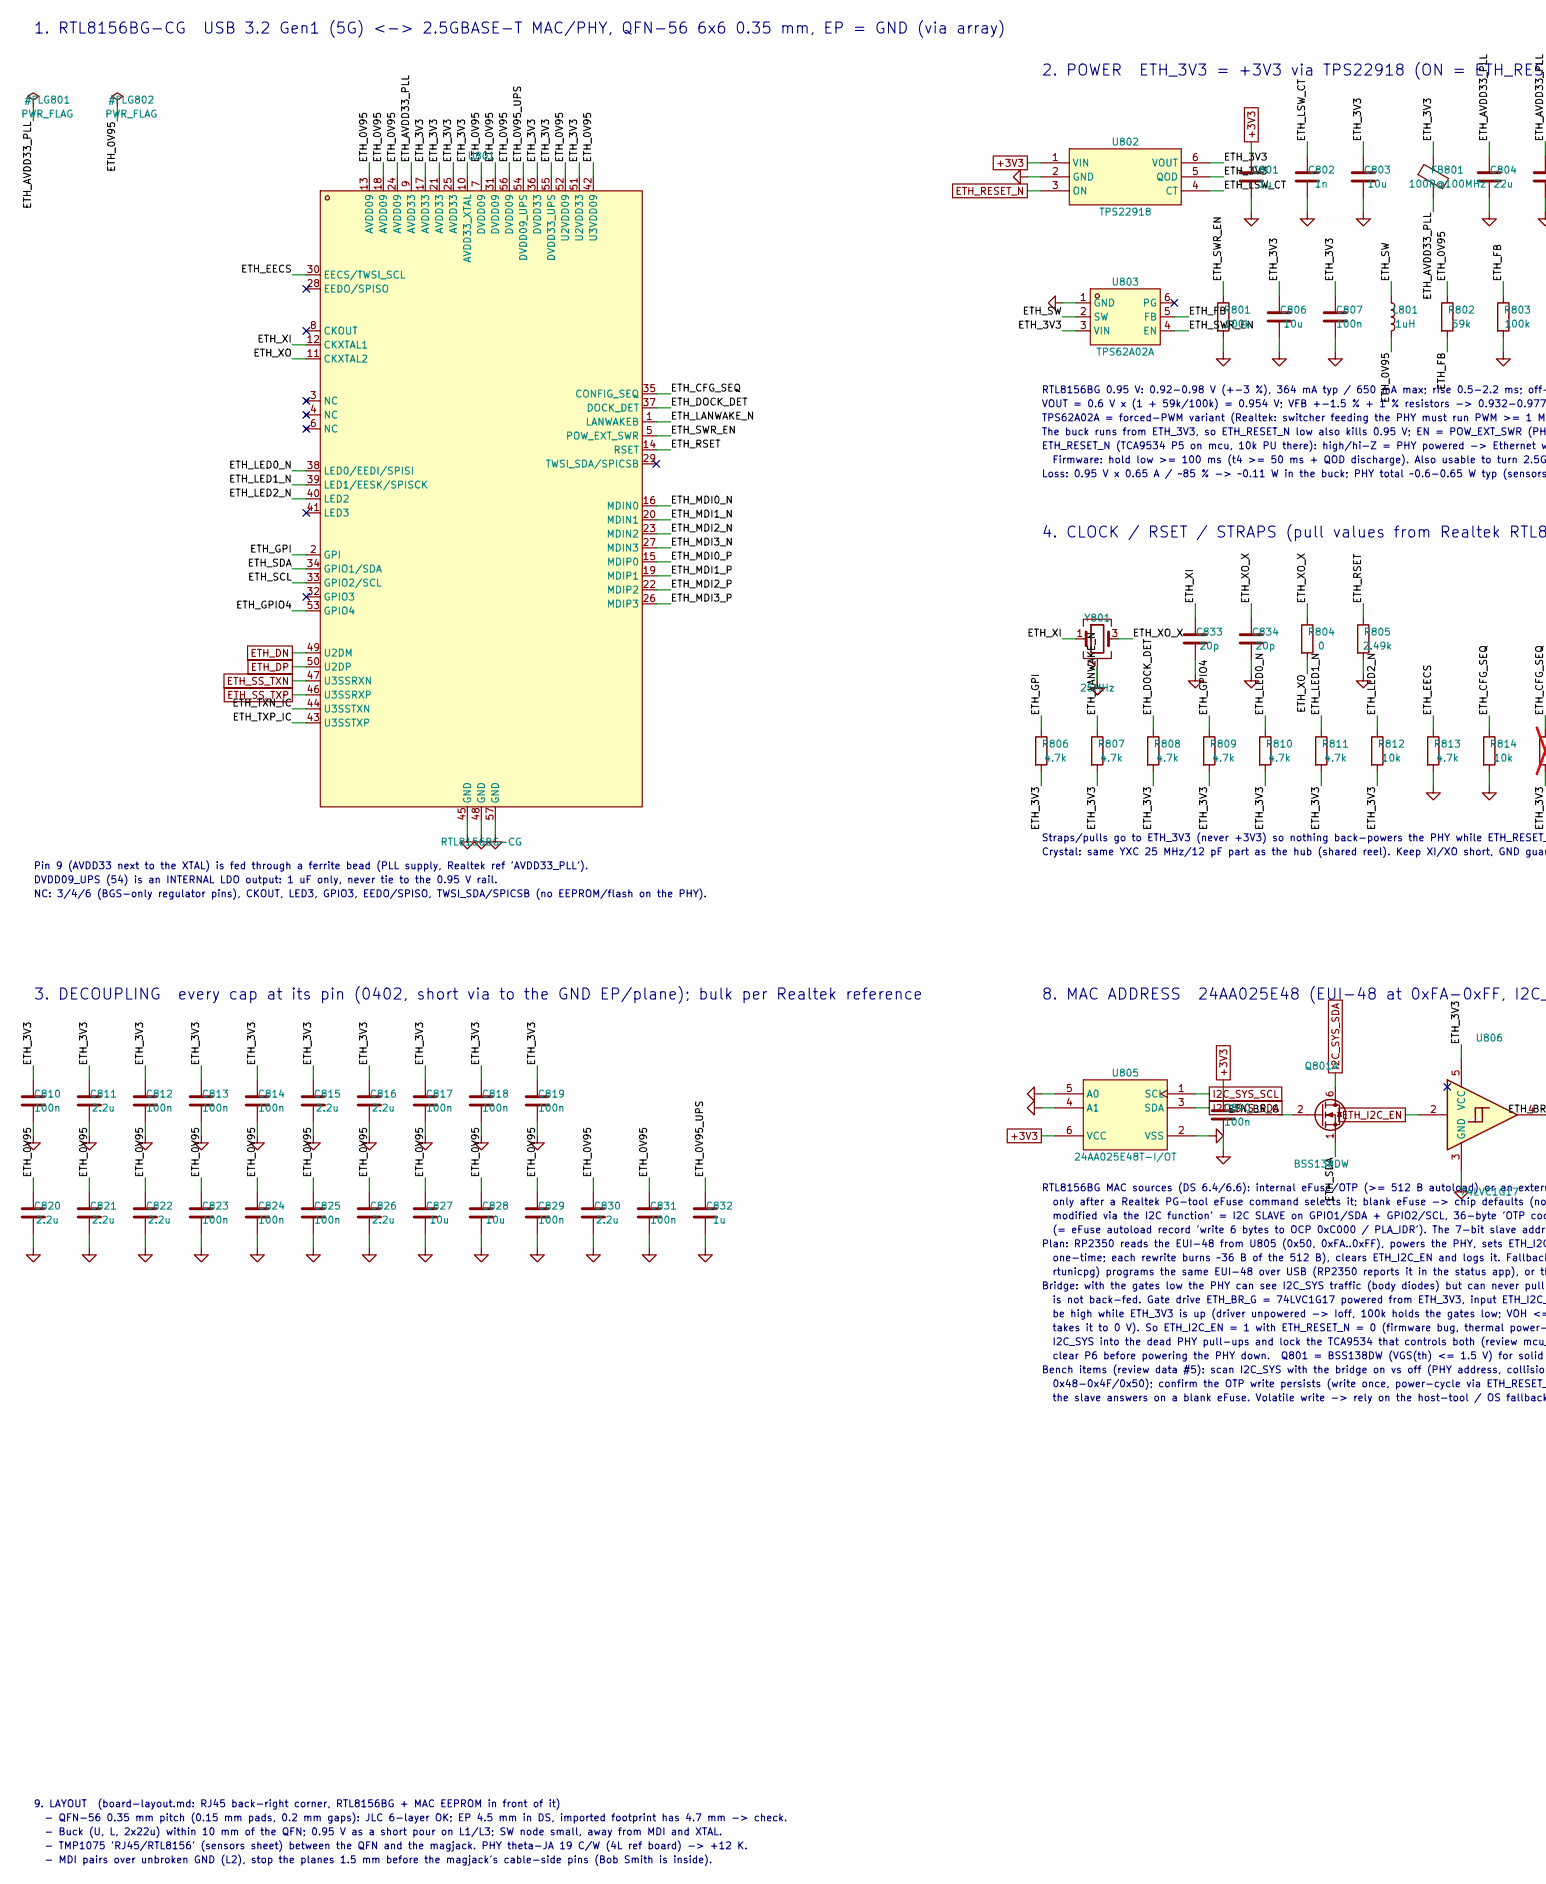
[picture p17: schematic ethernet.kicad_sch, odock-10 — 2.5 GbE (RTL8156BG), part in row 1, column 1]

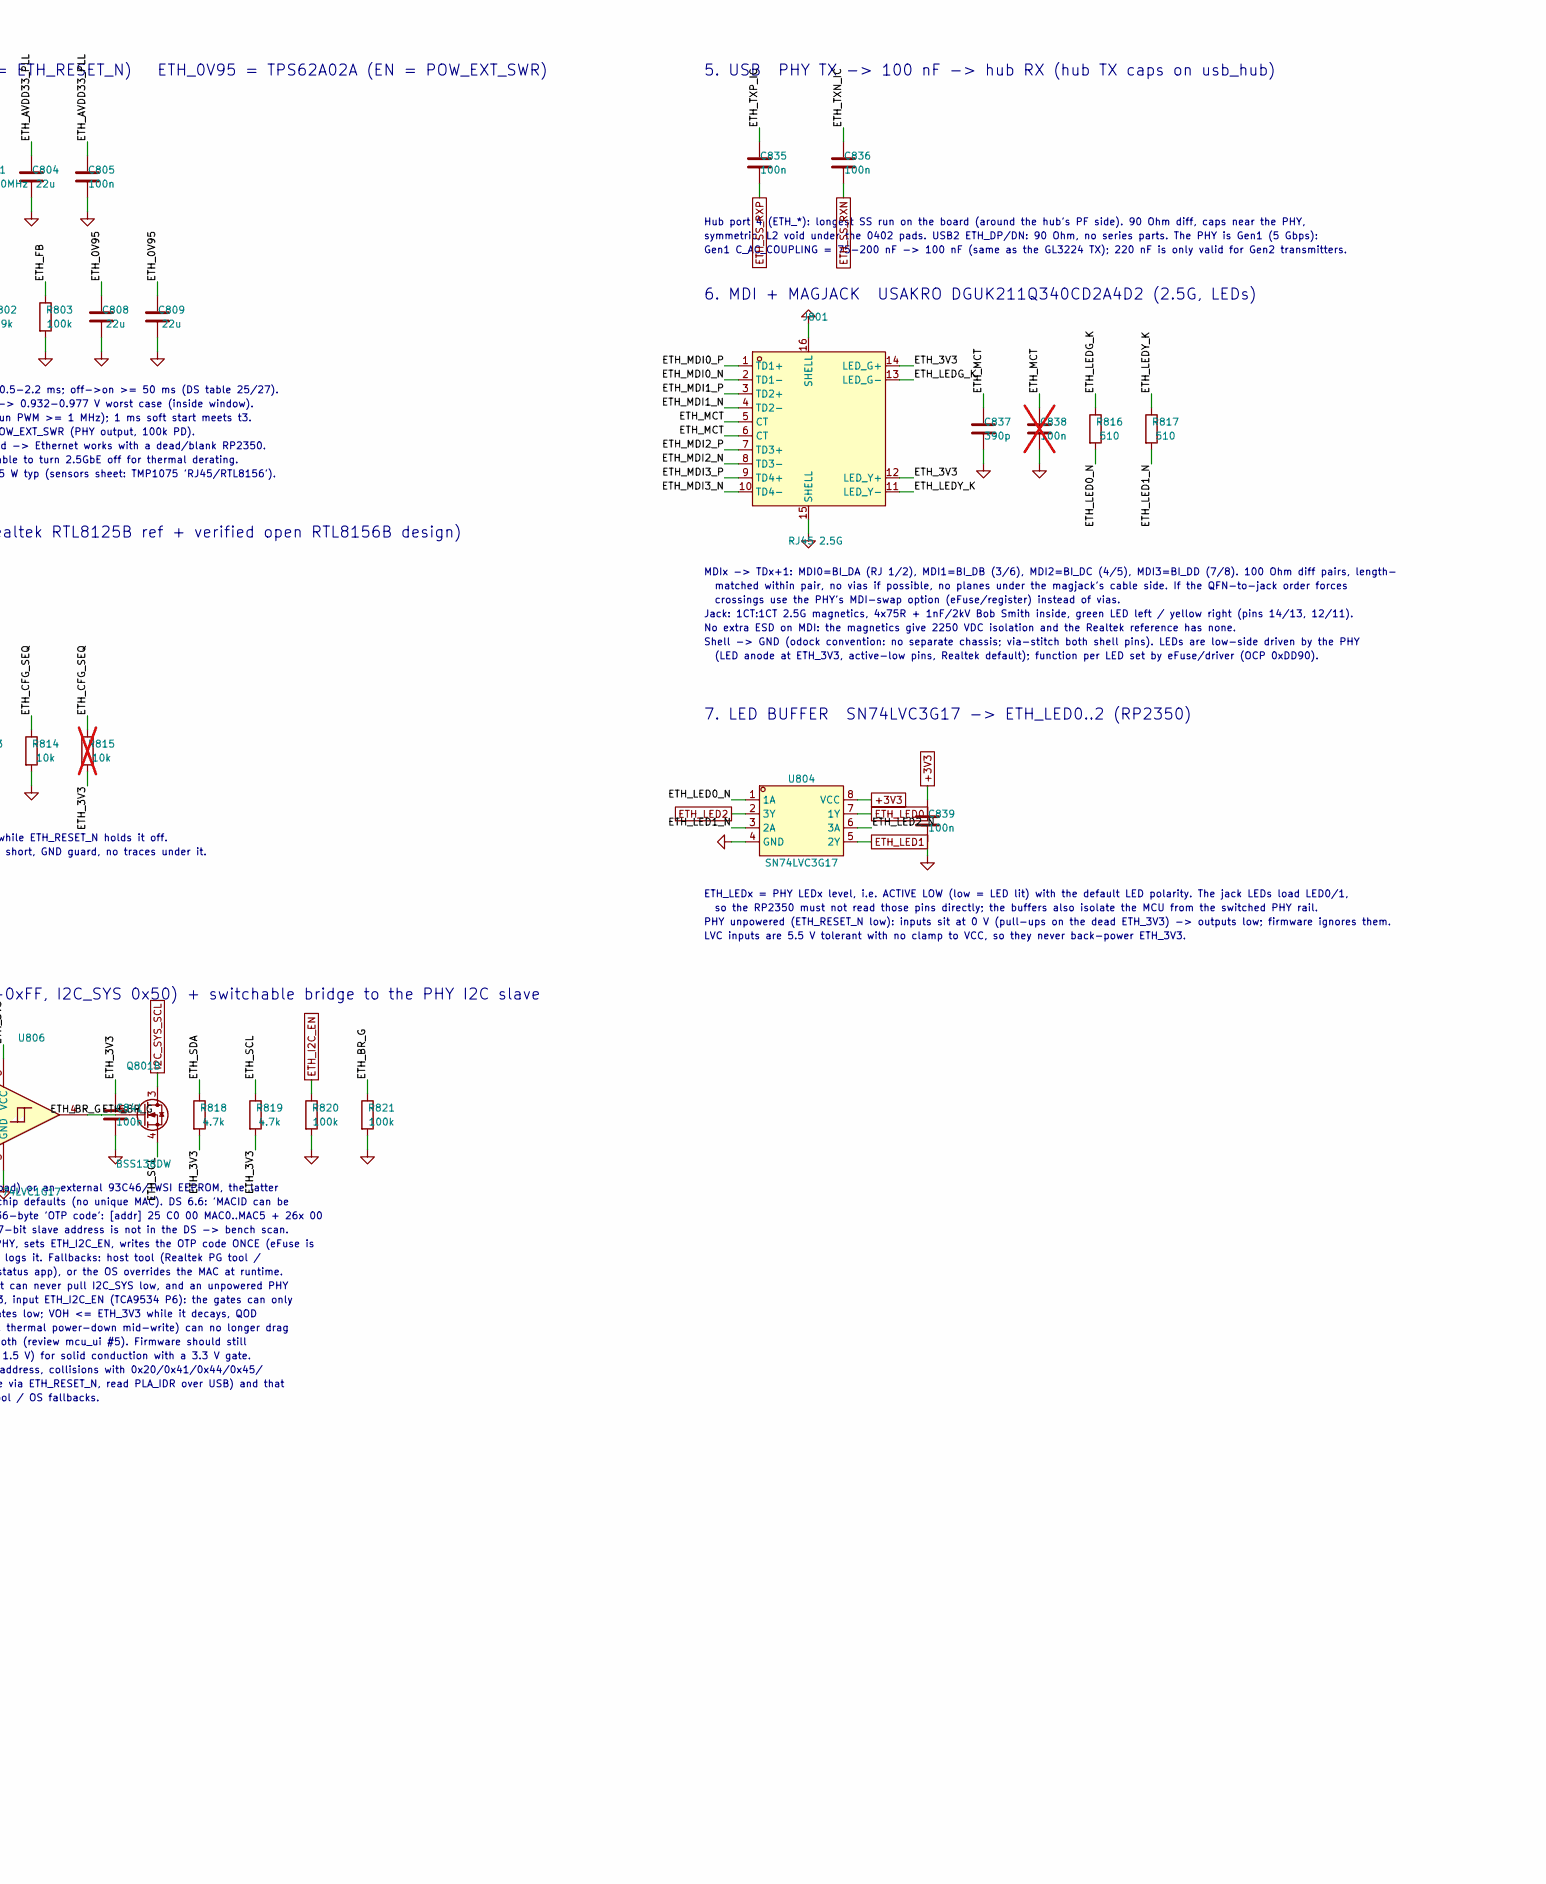
[picture p18: schematic ethernet.kicad_sch, odock-10 — 2.5 GbE (RTL8156BG), part in row 1, column 2]

Parts:
C801, C832: 1u; C_0402_1005Metric; LCSC C52923
C802: 1n; C_0402_1005Metric; LCSC C1523
C803, C806, C827, C828: 10u; C_0603_1608Metric; LCSC C19702
C804, C808, C809: 22u; C_0603_1608Metric; LCSC C59461
C805, C807, C810, C812, C813, C814, C817, C818, C819, C823, C824, C825, C829, C831, C835, C836, C839, C840, C841: 100n; C_0402_1005Metric; LCSC C1525
C811, C815, C816, C820, C821, C822, C826, C830: 2.2u; C_0402_1005Metric; LCSC C12530
C833, C834: 20p; C_0402_1005Metric; LCSC C1554
C837: 390p; C_0402_1005Metric; LCSC C282239
C838: 100n; C_0402_1005Metric; LCSC C1525; not fitted
FB801: 100R@100MHz; L_0805_2012Metric; LCSC C1015
J801: RJ45 2.5G; RJ45-TH_DGUK211Q340CD2A4D2; MPN DGUK211Q340CD2A4D2(2.5G); LCSC C19725134
L801: 1uH; L_Sunlord_SWPA4018S; LCSC C91250
Q801: BSS138DW; SOT-363_SC-70-6; MPN BSS138DW-7-F; LCSC C154900
R801, R803, R820, R821: 100k; R_0402_1005Metric; LCSC C25741
R802: 59k; R_0402_1005Metric; LCSC C32297
R804: 0; R_0402_1005Metric; LCSC C17168
R805: 2.49k; R_0402_1005Metric; LCSC C25884
R806, R807, R808, R809, R810, R811, R813, R818, R819: 4.7k; R_0402_1005Metric; LCSC C25900
R812, R814: 10k; R_0402_1005Metric; LCSC C25744
R815: 10k; R_0402_1005Metric; LCSC C25744; not fitted
R816, R817: 510; R_0402_1005Metric; LCSC C25123
U801: RTL8156BG-CG; QFN-56_L6.0-W6.0-P0.35--TL-EP4.7; MPN RTL8156BG-CG; LCSC C41376388
U802: TPS22918; SOT-23-6; MPN TPS22918DBVR; LCSC C131941
U803: TPS62A02A; SOT-5X3-6_W1.6-L1.2-P0.50-LS1.6-BL; MPN TPS62A02ADRLR; LCSC C5820994
U804: SN74LVC3G17; VSSOP-8_L2.1-W2.4-P0.50-LS3.2-BR; MPN SN74LVC3G17DCUR; LCSC C68245
U805: 24AA025E48T-I/OT; SOT-23-6; MPN 24AA025E48T-I/OT; LCSC C129895
U806: 74LVC1G17; SOT-23-5; MPN 74LVC1G17W5-7; LCSC C151394
Y801: 25MHz; Crystal_SMD_3225-4Pin_3.2x2.5mm; LCSC C9006

Connections:
+3V3: C801.1, C839.1, C840.1, U802.1 (VIN), U804.8 (VCC), U805.6 (VCC); also elsewhere on the board
/Ethernet/ETH_0V95: C808.1, C809.1, C820.1, C821.1, C822.1, C823.1, C824.1, C825.1, C826.1, C827.1, C828.1, C829.1, C830.1, C831.1, L801.2, R802.1, U801.7 (DVDD09), U801.13 (AVDD09), U801.18 (AVDD09), U801.24 (AVDD09), U801.31 (DVDD09), U801.42 (U3VDD09), U801.52 (U2VDD09), U801.56 (DVDD09)
/Ethernet/ETH_0V95_UPS: C832.1, U801.54 (DVDD09_UPS)
/Ethernet/ETH_3V3: C803.1, C806.1, C807.1, C810.1, C811.1, C812.1, C813.1, C814.1, C815.1, C816.1, C817.1, C818.1, C819.1, C841.1, FB801.1, J801.12 (LED_Y+), J801.14 (LED_G+), R806.2, R807.2, R808.2, R809.2, R810.2, R811.2, R812.2, R815.2, R818.2, R819.2, U801.10 (AVDD33_XTAL), U801.17 (AVDD33), U801.21 (AVDD33), U801.25 (AVDD33), U801.36 (DVDD33), U801.51 (U2VDD33), U801.55 (DVDD33_UPS), U802.5 (QOD), U802.6 (VOUT), U803.3 (VIN), U806.5 (VCC)
/Ethernet/ETH_AVDD33_PLL: C804.1, C805.1, FB801.2, U801.9 (AVDD33)
/Ethernet/ETH_BR_G: Q801.2 (G), Q801.5 (G), R821.1, U806.4
/Ethernet/ETH_CFG_SEQ: R814.1, R815.1, U801.35 (CONFIG_SEQ)
/Ethernet/ETH_DOCK_DET: R808.1, U801.37 (DOCK_DET)
/Ethernet/ETH_EECS: R813.1, U801.30 (EECS/TWSI_SCL)
/Ethernet/ETH_FB: R802.2, R803.1, U803.5 (FB)
/Ethernet/ETH_GPI: R806.1, U801.2 (GPI)
/Ethernet/ETH_GPIO4: R809.1, U801.53 (GPIO4)
/Ethernet/ETH_LANWAKE_N: R807.1, U801.1 (LANWAKEB)
/Ethernet/ETH_LED0_N: R810.1, R816.2, U801.38 (LED0/EEDI/SPISI), U804.1 (1A)
/Ethernet/ETH_LED1_N: R811.1, R817.2, U801.39 (LED1/EESK/SPISCK), U804.3 (2A)
/Ethernet/ETH_LED2_N: R812.1, U801.40 (LED2), U804.6 (3A)
/Ethernet/ETH_LEDG_K: J801.13 (LED_G-), R816.1
/Ethernet/ETH_LEDY_K: J801.11 (LED_Y-), R817.1
/Ethernet/ETH_LSW_CT: C802.1, U802.4 (CT)
/Ethernet/ETH_MCT: C837.1, C838.1, J801.5 (CT), J801.6 (CT)
/Ethernet/ETH_MDI0_N: J801.2 (TD1-), U801.16 (MDIN0)
/Ethernet/ETH_MDI0_P: J801.1 (TD1+), U801.15 (MDIP0)
/Ethernet/ETH_MDI1_N: J801.4 (TD2-), U801.20 (MDIN1)
/Ethernet/ETH_MDI1_P: J801.3 (TD2+), U801.19 (MDIP1)
/Ethernet/ETH_MDI2_N: J801.8 (TD3-), U801.23 (MDIN2)
/Ethernet/ETH_MDI2_P: J801.7 (TD3+), U801.22 (MDIP2)
/Ethernet/ETH_MDI3_N: J801.10 (TD4-), U801.27 (MDIN3)
/Ethernet/ETH_MDI3_P: J801.9 (TD4+), U801.26 (MDIP3)
/Ethernet/ETH_RSET: R805.1, U801.14 (RSET)
/Ethernet/ETH_SCL: Q801.4 (S), R819.1, U801.33 (GPIO2/SCL)
/Ethernet/ETH_SDA: Q801.1 (S), R818.1, U801.34 (GPIO1/SDA)
/Ethernet/ETH_SW: L801.1, U803.2 (SW)
/Ethernet/ETH_SWR_EN: R801.1, U801.5 (POW_EXT_SWR), U803.4 (EN)
/Ethernet/ETH_TXN_IC: C836.1, U801.44 (U3SSTXN)
/Ethernet/ETH_TXP_IC: C835.1, U801.43 (U3SSTXP)
/Ethernet/ETH_XI: C833.1, U801.12 (CKXTAL1), Y801.1
/Ethernet/ETH_XO: R804.2, U801.11 (CKXTAL2)
/Ethernet/ETH_XO_X: C834.1, R804.1, Y801.3
ETH_DN: U801.49 (U2DM); also elsewhere on the board
ETH_DP: U801.50 (U2DP); also elsewhere on the board
ETH_I2C_EN: R820.1, U806.2; also elsewhere on the board
ETH_LED0: U804.7 (1Y); also elsewhere on the board
ETH_LED1: U804.5 (2Y); also elsewhere on the board
ETH_LED2: U804.2 (3Y); also elsewhere on the board
ETH_RESET_N: U802.3 (ON); also elsewhere on the board
ETH_SS_RXN: C836.2; also elsewhere on the board
ETH_SS_RXP: C835.2; also elsewhere on the board
ETH_SS_TXN: U801.47 (U3SSRXN); also elsewhere on the board
ETH_SS_TXP: U801.46 (U3SSRXP); also elsewhere on the board
GND: C801.2, C802.2, C803.2, C804.2, C805.2, C806.2, C807.2, C808.2, C809.2, C810.2, C811.2, C812.2, C813.2, C814.2, C815.2, C816.2, C817.2, C818.2, C819.2, C820.2, C821.2, C822.2, C823.2, C824.2, C825.2, C826.2, C827.2, C828.2, C829.2, C830.2, C831.2, C832.2, C833.2, C834.2, C837.2, C838.2, C839.2, C840.2, C841.2, J801.15 (SHELL), J801.16 (SHELL), R801.2, R803.2, R805.2, R813.2, R814.2, R820.2, R821.2, U801.45 (GND), U801.48 (GND), U801.57 (GND), U802.2 (GND), U803.1 (GND), U804.4 (GND), U805.2 (VSS), U805.4 (A1), U805.5 (A0), U806.3 (GND), Y801.2 (G), Y801.4 (G); also elsewhere on the board
I2C_SYS_SCL: Q801.3 (D), U805.1 (SCL); also elsewhere on the board
I2C_SYS_SDA: Q801.6 (D), U805.3 (SDA); also elsewhere on the board

Notes on the sheet:
1. RTL8156BG-CG USB 3.2 Gen1 (5G) <-> 2.5GBASE-T MAC/PHY, QFN-56 6x6 0.35 mm, EP = GND (via array)
Pin 9 (AVDD33 next to the XTAL) is fed through a ferrite bead (PLL supply, Realtek ref 'AVDD33_PLL').
DVDD09_UPS (54) is an INTERNAL LDO output: 1 uF only, never tie to the 0.95 V rail.
NC: 3/4/6 (BGS-only regulator pins), CKOUT, LED3, GPIO3, EEDO/SPISO, TWSI_SDA/SPICSB (no EEPROM/flash on the PHY).
2. POWER ETH_3V3 = +3V3 via TPS22918 (ON = ETH_RESET_N) ETH_0V95 = TPS62A02A (EN = POW_EXT_SWR)
RTL8156BG 0.95 V: 0.92-0.98 V (+-3 %), 364 mA typ / 650 mA max; rise 0.5-2.2 ms; off->on >= 50 ms (DS table 25/27).
VOUT = 0.6 V x (1 + 59k/100k) = 0.954 V; VFB +-1.5 % + 1 % resistors -> 0.932-0.977 V worst case (inside window).
TPS62A02A = forced-PWM variant (Realtek: switcher feeding the PHY must run PWM >= 1 MHz); 1 ms soft start meets t3.
The buck runs from ETH_3V3, so ETH_RESET_N low also kills 0.95 V; EN = POW_EXT_SWR (PHY output, 100k PD).
ETH_RESET_N (TCA9534 P5 on mcu, 10k PU there): high/hi-Z = PHY powered -> Ethernet works with a dead/blank RP2350.
Firmware: hold low >= 100 ms (t4 >= 50 ms + QOD discharge). Also usable to turn 2.5GbE off for thermal derating.
Loss: 0.95 V x 0.65 A / ~85 % -> ~0.11 W in the buck; PHY total ~0.6-0.65 W typ (sensors sheet: TMP1075 'RJ45/RTL8156').
3. DECOUPLING every cap at its pin (0402, short via to the GND EP/plane); bulk per Realtek reference
4. CLOCK / RSET / STRAPS (pull values from Realtek RTL8125B ref + verified open RTL8156B design)
Straps/pulls go to ETH_3V3 (never +3V3) so nothing back-powers the PHY while ETH_RESET_N holds it off.
Crystal: same YXC 25 MHz/12 pF part as the hub (shared reel). Keep XI/XO short, GND guard, no traces under it.
5. USB PHY TX -> 100 nF -> hub RX (hub TX caps on usb_hub)
Hub port 4 (ETH_*): longest SS run on the board (around the hub's PF side). 90 Ohm diff, caps near the PHY,
symmetric, L2 void under the 0402 pads. USB2 ETH_DP/DN: 90 Ohm, no series parts. The PHY is Gen1 (5 Gbps):
Gen1 C_AC_COUPLING = 75-200 nF -> 100 nF (same as the GL3224 TX); 220 nF is only valid for Gen2 transmitters.
6. MDI + MAGJACK USAKRO DGUK211Q340CD2A4D2 (2.5G, LEDs)
MDIx -> TDx+1: MDI0=BI_DA (RJ 1/2), MDI1=BI_DB (3/6), MDI2=BI_DC (4/5), MDI3=BI_DD (7/8). 100 Ohm diff pairs, length-
matched within pair, no vias if possible, no planes under the magjack's cable side. If the QFN-to-jack order forces
crossings use the PHY's MDI-swap option (eFuse/register) instead of vias.
Jack: 1CT:1CT 2.5G magnetics, 4x75R + 1nF/2kV Bob Smith inside, green LED left / yellow right (pins 14/13, 12/11).
No extra ESD on MDI: the magnetics give 2250 VDC isolation and the Realtek reference has none.
Shell -> GND (odock convention: no separate chassis; via-stitch both shell pins). LEDs are low-side driven by the PHY
(LED anode at ETH_3V3, active-low pins, Realtek default); function per LED set by eFuse/driver (OCP 0xDD90).
7. LED BUFFER SN74LVC3G17 -> ETH_LED0..2 (RP2350)
ETH_LEDx = PHY LEDx level, i.e. ACTIVE LOW (low = LED lit) with the default LED polarity. The jack LEDs load LED0/1,
so the RP2350 must not read those pins directly; the buffers also isolate the MCU from the switched PHY rail.
PHY unpowered (ETH_RESET_N low): inputs sit at 0 V (pull-ups on the dead ETH_3V3) -> outputs low; firmware ignores them.
LVC inputs are 5.5 V tolerant with no clamp to VCC, so they never back-power ETH_3V3.
8. MAC ADDRESS 24AA025E48 (EUI-48 at 0xFA-0xFF, I2C_SYS 0x50) + switchable bridge to the PHY I2C slave
RTL8156BG MAC sources (DS 6.4/6.6): internal eFuse/OTP (>= 512 B autoload) or an external 93C46/TWSI EEPROM, the latter
only after a Realtek PG-tool eFuse command selects it; blank eFuse -> chip defaults (no unique MAC). DS 6.6: 'MACID can be
modified via the I2C function' = I2C SLAVE on GPIO1/SDA + GPIO2/SCL, 36-byte 'OTP code': [addr] 25 C0 00 MAC0..MAC5 + 26x 00
(= eFuse autoload record 'write 6 bytes to OCP 0xC000 / PLA_IDR'). The 7-bit slave address is not in the DS -> bench scan.
Plan: RP2350 reads the EUI-48 from U805 (0x50, 0xFA..0xFF), powers the PHY, sets ETH_I2C_EN, writes the OTP code ONCE (eFuse is
one-time; each rewrite burns ~36 B of the 512 B), clears ETH_I2C_EN and logs it. Fallbacks: host tool (Realtek PG tool /
rtunicpg) programs the same EUI-48 over USB (RP2350 reports it in the status app), or the OS overrides the MAC at runtime.
Bridge: with the gates low the PHY can see I2C_SYS traffic (body diodes) but can never pull I2C_SYS low, and an unpowered PHY
is not back-fed. Gate drive ETH_BR_G = 74LVC1G17 powered from ETH_3V3, input ETH_I2C_EN (TCA9534 P6): the gates can only
be high while ETH_3V3 is up (driver unpowered -> Ioff, 100k holds the gates low; VOH <= ETH_3V3 while it decays, QOD
takes it to 0 V). So ETH_I2C_EN = 1 with ETH_RESET_N = 0 (firmware bug, thermal power-down mid-write) can no longer drag
I2C_SYS into the dead PHY pull-ups and lock the TCA9534 that controls both (review mcu_ui #5). Firmware should still
clear P6 before powering the PHY down. Q801 = BSS138DW (VGS(th) <= 1.5 V) for solid conduction with a 3.3 V gate.
Bench items (review data #5): scan I2C_SYS with the bridge on vs off (PHY address, collisions with 0x20/0x41/0x44/0x45/
0x48-0x4F/0x50); confirm the OTP write persists (write once, power-cycle via ETH_RESET_N, read PLA_IDR over USB) and that
the slave answers on a blank eFuse. Volatile write -> rely on the host-tool / OS fallbacks.
9. LAYOUT (board-layout.md: RJ45 back-right corner, RTL8156BG + MAC EEPROM in front of it)
- QFN-56 0.35 mm pitch (0.15 mm pads, 0.2 mm gaps): JLC 6-layer OK; EP 4.5 mm in DS, imported footprint has 4.7 mm -> check.
- Buck (U, L, 2x22u) within 10 mm of the QFN; 0.95 V as a short pour on L1/L3; SW node small, away from MDI and XTAL.
- TMP1075 'RJ45/RTL8156' (sensors sheet) between the QFN and the magjack. PHY theta-JA 19 C/W (4L ref board) -> +12 K.
- MDI pairs over unbroken GND (L2), stop the planes 1.5 mm before the magjack's cable-side pins (Bob Smith is inside).

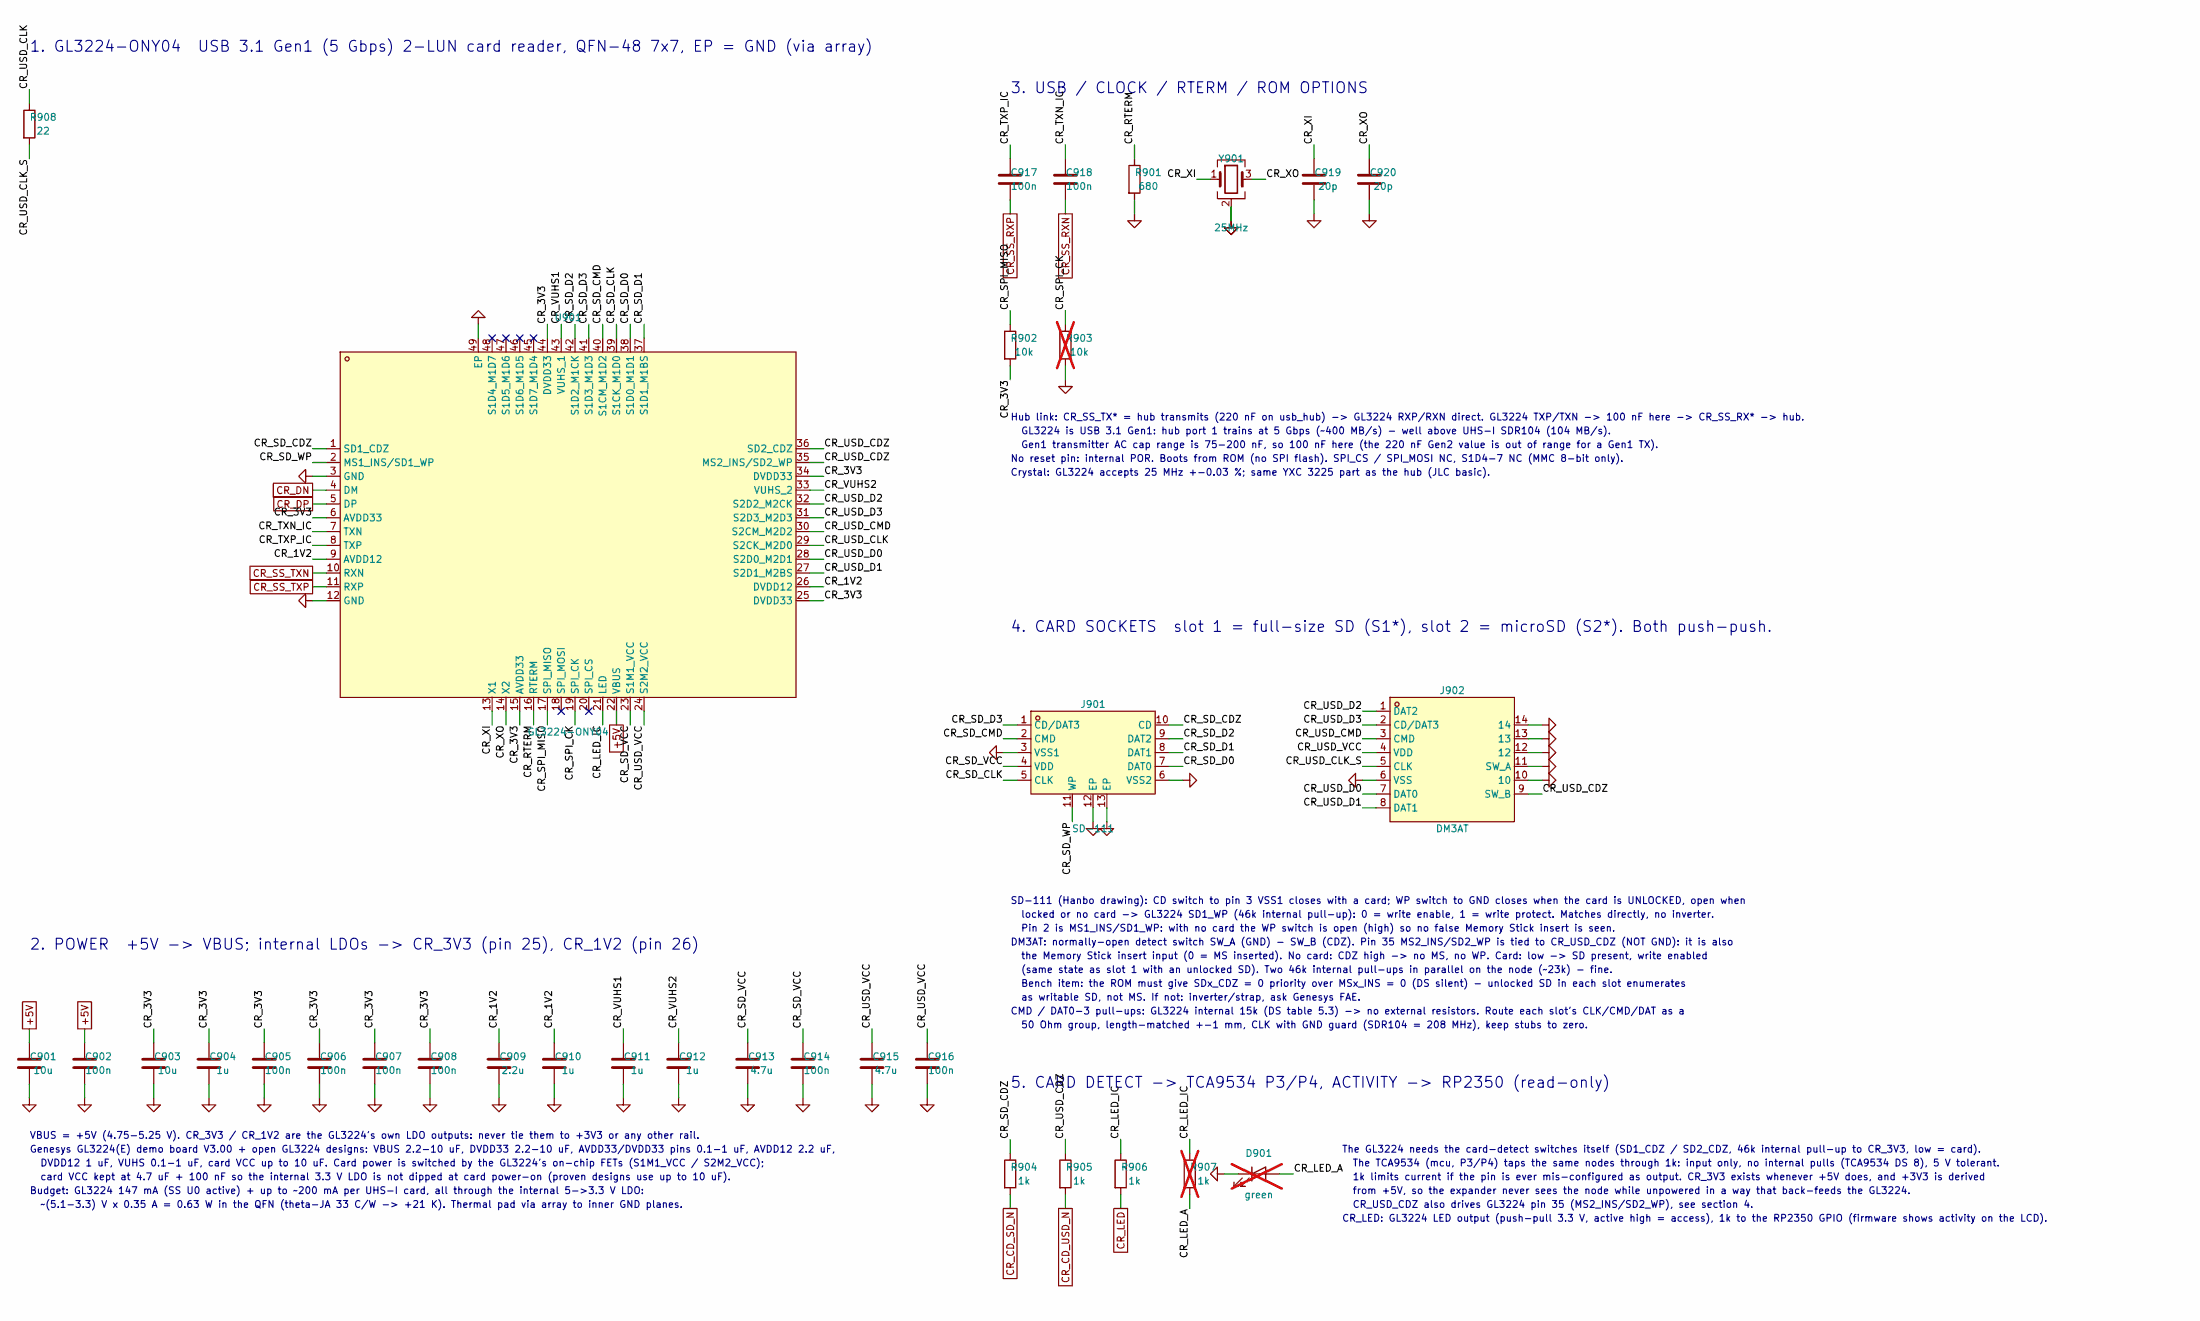
[picture p19: schematic card_reader.kicad_sch, odock-10 — SD / microSD card reader (GL3224)]

Parts:
C901: 10u; C_0805_2012Metric; LCSC C15850
C902, C905, C906, C907, C908, C914, C916, C917, C918: 100n; C_0402_1005Metric; LCSC C1525
C903: 10u; C_0603_1608Metric; LCSC C19702
C904, C910, C911, C912: 1u; C_0402_1005Metric; LCSC C52923
C909: 2.2u; C_0402_1005Metric; LCSC C12530
C913, C915: 4.7u; C_0402_1005Metric; LCSC C23733
C919, C920: 20p; C_0402_1005Metric; LCSC C1554
D901: green; LED_0805_2012Metric; LCSC C2297; not fitted
J901: SD-111; SD-SMD_SD-111; MPN SD-111; LCSC C410353
J902: DM3AT; SD-SMD_DM3AT-SF-PEJM5; MPN DM3AT-SF-PEJM5; LCSC C114218
R901: 680; R_0603_1608Metric; LCSC C23228
R902: 10k; R_0402_1005Metric; LCSC C25744
R903: 10k; R_0402_1005Metric; LCSC C25744; not fitted
R904, R905, R906: 1k; R_0402_1005Metric; LCSC C11702
R907: 1k; R_0402_1005Metric; LCSC C11702; not fitted
R908: 22; R_0402_1005Metric; LCSC C25092
U901: GL3224-ONY04; QFN-48_L7.0-W7.0-P0.50-BL-EP5.1; MPN GL3224-ONY04; LCSC C157358
Y901: 25MHz; Crystal_SMD_3225-4Pin_3.2x2.5mm; LCSC C9006

Connections:
+5V: C901.1, C902.1, U901.22 (VBUS); also elsewhere on the board
/Card reader/CR_1V2: C909.1, C910.1, U901.9 (AVDD12), U901.26 (DVDD12)
/Card reader/CR_3V3: C903.1, C904.1, C905.1, C906.1, C907.1, C908.1, R902.2, U901.6 (AVDD33), U901.15 (AVDD33), U901.25 (DVDD33), U901.34 (DVDD33), U901.44 (DVDD33)
/Card reader/CR_LED_A: D901.2 (A), R907.2
/Card reader/CR_LED_IC: R906.1, R907.1, U901.21 (LED)
/Card reader/CR_RTERM: R901.1, U901.16 (RTERM)
/Card reader/CR_SD_CDZ: J901.10 (CD), R904.1, U901.1 (SD1_CDZ)
/Card reader/CR_SD_CLK: J901.5 (CLK), U901.39 (S1CK_M1D0)
/Card reader/CR_SD_CMD: J901.2 (CMD), U901.40 (S1CM_M1D2)
/Card reader/CR_SD_D0: J901.7 (DAT0), U901.38 (S1D0_M1D1)
/Card reader/CR_SD_D1: J901.8 (DAT1), U901.37 (S1D1_M1BS)
/Card reader/CR_SD_D2: J901.9 (DAT2), U901.42 (S1D2_M1CK)
/Card reader/CR_SD_D3: J901.1 (CD/DAT3), U901.41 (S1D3_M1D3)
/Card reader/CR_SD_VCC: C913.1, C914.1, J901.4 (VDD), U901.23 (S1M1_VCC)
/Card reader/CR_SD_WP: J901.11 (WP), U901.2 (MS1_INS/SD1_WP)
/Card reader/CR_SPI_CK: R903.1, U901.19 (SPI_CK)
/Card reader/CR_SPI_MISO: R902.1, U901.17 (SPI_MISO)
/Card reader/CR_TXN_IC: C918.1, U901.7 (TXN)
/Card reader/CR_TXP_IC: C917.1, U901.8 (TXP)
/Card reader/CR_USD_CDZ: J902.9 (SW_B), R905.1, U901.35 (MS2_INS/SD2_WP), U901.36 (SD2_CDZ)
/Card reader/CR_USD_CLK: R908.1, U901.29 (S2CK_M2D0)
/Card reader/CR_USD_CLK_S: J902.5 (CLK), R908.2
/Card reader/CR_USD_CMD: J902.3 (CMD), U901.30 (S2CM_M2D2)
/Card reader/CR_USD_D0: J902.7 (DAT0), U901.28 (S2D0_M2D1)
/Card reader/CR_USD_D1: J902.8 (DAT1), U901.27 (S2D1_M2BS)
/Card reader/CR_USD_D2: J902.1 (DAT2), U901.32 (S2D2_M2CK)
/Card reader/CR_USD_D3: J902.2 (CD/DAT3), U901.31 (S2D3_M2D3)
/Card reader/CR_USD_VCC: C915.1, C916.1, J902.4 (VDD), U901.24 (S2M2_VCC)
/Card reader/CR_VUHS1: C911.1, U901.43 (VUHS_1)
/Card reader/CR_VUHS2: C912.1, U901.33 (VUHS_2)
/Card reader/CR_XI: C919.1, U901.13 (X1), Y901.1
/Card reader/CR_XO: C920.1, U901.14 (X2), Y901.3
CR_CD_SD_N: R904.2; also elsewhere on the board
CR_CD_USD_N: R905.2; also elsewhere on the board
CR_DN: U901.4 (DM); also elsewhere on the board
CR_DP: U901.5 (DP); also elsewhere on the board
CR_LED: R906.2; also elsewhere on the board
CR_SS_RXN: C918.2; also elsewhere on the board
CR_SS_RXP: C917.2; also elsewhere on the board
CR_SS_TXN: U901.10 (RXN); also elsewhere on the board
CR_SS_TXP: U901.11 (RXP); also elsewhere on the board
GND: C901.2, C902.2, C903.2, C904.2, C905.2, C906.2, C907.2, C908.2, C909.2, C910.2, C911.2, C912.2, C913.2, C914.2, C915.2, C916.2, C919.2, C920.2, D901.1 (K), J901.3 (VSS1), J901.6 (VSS2), J901.12 (EP), J901.13 (EP), J902.6 (VSS), J902.10, J902.11 (SW_A), J902.12, J902.13, J902.14, R901.2, R903.2, U901.3 (GND), U901.12 (GND), U901.49 (EP), Y901.2 (G), Y901.4 (G); also elsewhere on the board

Notes on the sheet:
1. GL3224-ONY04 USB 3.1 Gen1 (5 Gbps) 2-LUN card reader, QFN-48 7x7, EP = GND (via array)
2. POWER +5V -> VBUS; internal LDOs -> CR_3V3 (pin 25), CR_1V2 (pin 26)
VBUS = +5V (4.75-5.25 V). CR_3V3 / CR_1V2 are the GL3224's own LDO outputs: never tie them to +3V3 or any other rail.
Genesys GL3224(E) demo board V3.00 + open GL3224 designs: VBUS 2.2-10 uF, DVDD33 2.2-10 uF, AVDD33/DVDD33 pins 0.1-1 uF, AVDD12 2.2 uF,
DVDD12 1 uF, VUHS 0.1-1 uF, card VCC up to 10 uF. Card power is switched by the GL3224's on-chip FETs (S1M1_VCC / S2M2_VCC);
card VCC kept at 4.7 uF + 100 nF so the internal 3.3 V LDO is not dipped at card power-on (proven designs use up to 10 uF).
Budget: GL3224 147 mA (SS U0 active) + up to ~200 mA per UHS-I card, all through the internal 5->3.3 V LDO:
~(5.1-3.3) V x 0.35 A = 0.63 W in the QFN (theta-JA 33 C/W -> +21 K). Thermal pad via array to inner GND planes.
3. USB / CLOCK / RTERM / ROM OPTIONS
Hub link: CR_SS_TX* = hub transmits (220 nF on usb_hub) -> GL3224 RXP/RXN direct. GL3224 TXP/TXN -> 100 nF here -> CR_SS_RX* -> hub.
GL3224 is USB 3.1 Gen1: hub port 1 trains at 5 Gbps (~400 MB/s) - well above UHS-I SDR104 (104 MB/s).
Gen1 transmitter AC cap range is 75-200 nF, so 100 nF here (the 220 nF Gen2 value is out of range for a Gen1 TX).
No reset pin: internal POR. Boots from ROM (no SPI flash). SPI_CS / SPI_MOSI NC, S1D4-7 NC (MMC 8-bit only).
Crystal: GL3224 accepts 25 MHz +-0.03 %; same YXC 3225 part as the hub (JLC basic).
4. CARD SOCKETS slot 1 = full-size SD (S1*), slot 2 = microSD (S2*). Both push-push.
SD-111 (Hanbo drawing): CD switch to pin 3 VSS1 closes with a card; WP switch to GND closes when the card is UNLOCKED, open when
locked or no card -> GL3224 SD1_WP (46k internal pull-up): 0 = write enable, 1 = write protect. Matches directly, no inverter.
Pin 2 is MS1_INS/SD1_WP: with no card the WP switch is open (high) so no false Memory Stick insert is seen.
DM3AT: normally-open detect switch SW_A (GND) - SW_B (CDZ). Pin 35 MS2_INS/SD2_WP is tied to CR_USD_CDZ (NOT GND): it is also
the Memory Stick insert input (0 = MS inserted). No card: CDZ high -> no MS, no WP. Card: low -> SD present, write enabled
(same state as slot 1 with an unlocked SD). Two 46k internal pull-ups in parallel on the node (~23k) - fine.
Bench item: the ROM must give SDx_CDZ = 0 priority over MSx_INS = 0 (DS silent) - unlocked SD in each slot enumerates
as writable SD, not MS. If not: inverter/strap, ask Genesys FAE.
CMD / DAT0-3 pull-ups: GL3224 internal 15k (DS table 5.3) -> no external resistors. Route each slot's CLK/CMD/DAT as a
50 Ohm group, length-matched +-1 mm, CLK with GND guard (SDR104 = 208 MHz), keep stubs to zero.
5. CARD DETECT -> TCA9534 P3/P4, ACTIVITY -> RP2350 (read-only)
The GL3224 needs the card-detect switches itself (SD1_CDZ / SD2_CDZ, 46k internal pull-up to CR_3V3, low = card).
The TCA9534 (mcu, P3/P4) taps the same nodes through 1k: input only, no internal pulls (TCA9534 DS 8), 5 V tolerant.
1k limits current if the pin is ever mis-configured as output. CR_3V3 exists whenever +5V does, and +3V3 is derived
from +5V, so the expander never sees the node while unpowered in a way that back-feeds the GL3224.
CR_USD_CDZ also drives GL3224 pin 35 (MS2_INS/SD2_WP), see section 4.
CR_LED: GL3224 LED output (push-pull 3.3 V, active high = access), 1k to the RP2350 GPIO (firmware shows activity on the LCD).
