KarpelesLab/odock/hardware/odock-10/odock-10.kicad_pcb

## KiCad design hardware/odock-10/odock-10.kicad_pcb (continued)

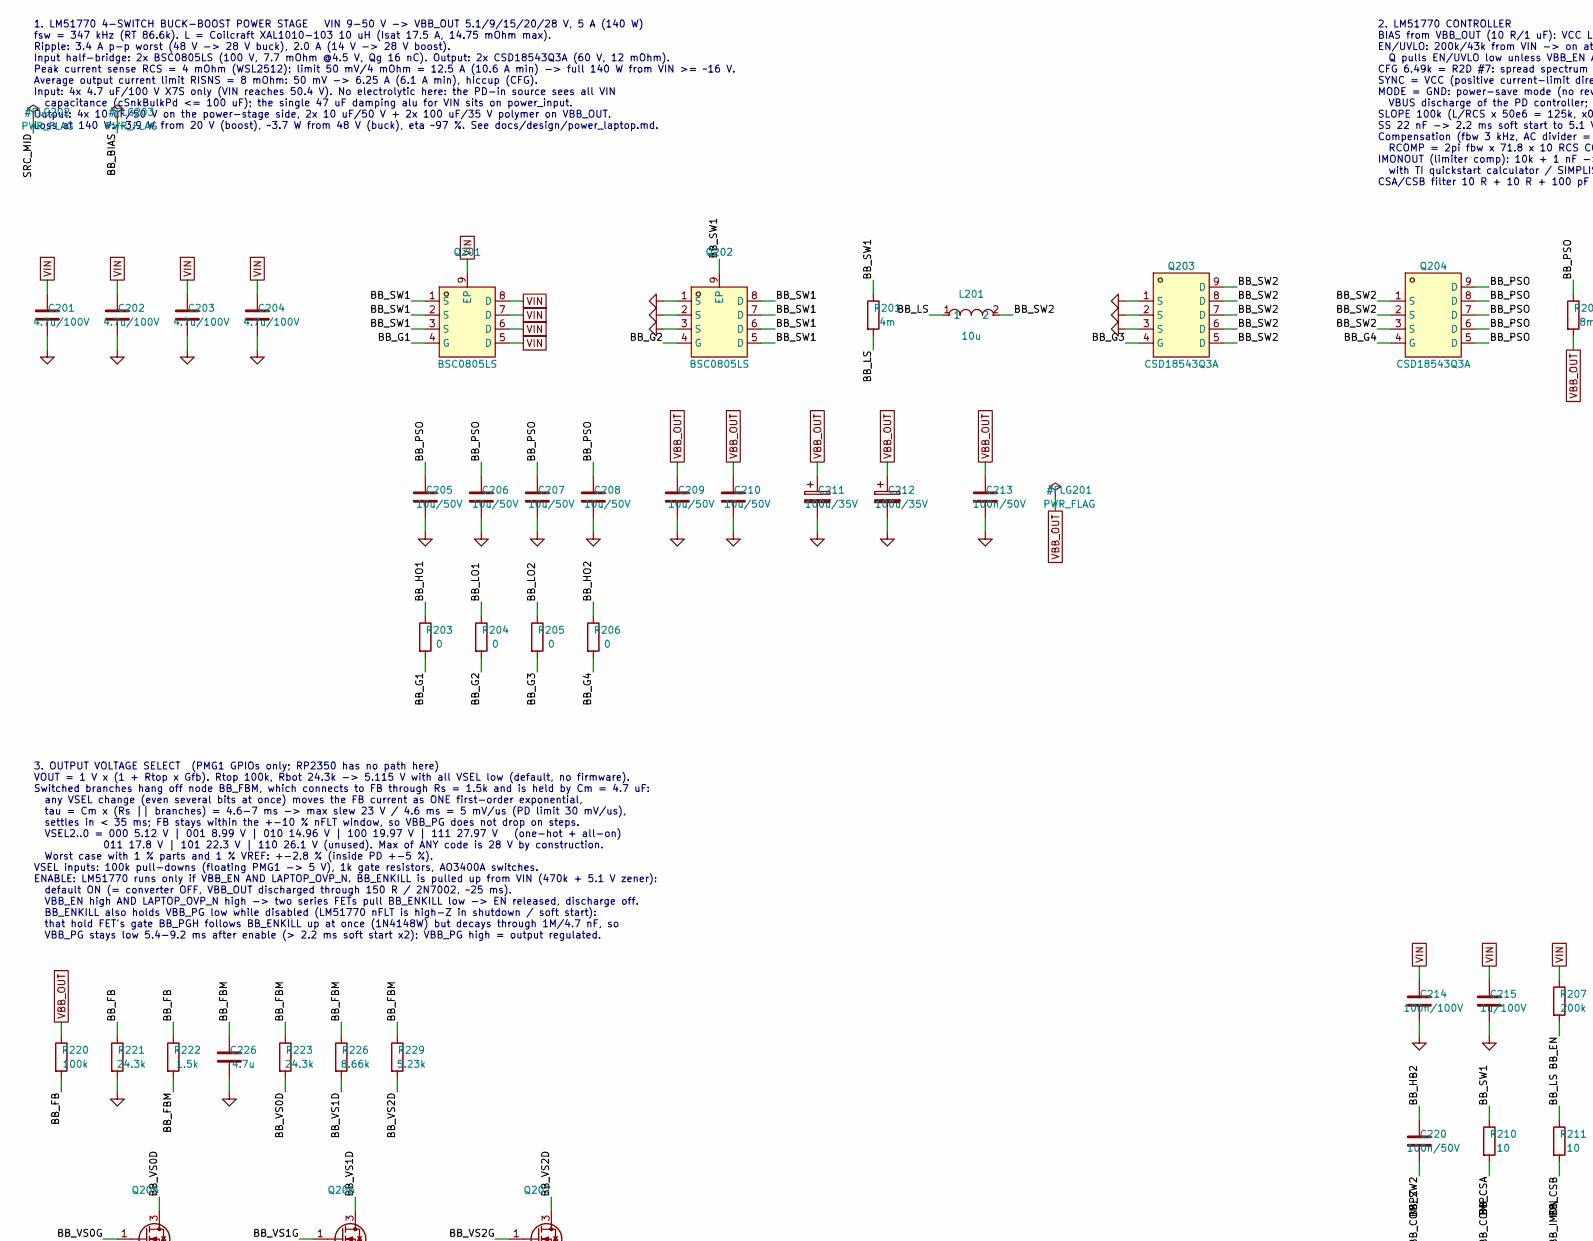
[picture p20: schematic power_laptop.kicad_sch, odock-10 — Laptop power (buck-boost, source/sink switches, …, part in row 1, column 1]

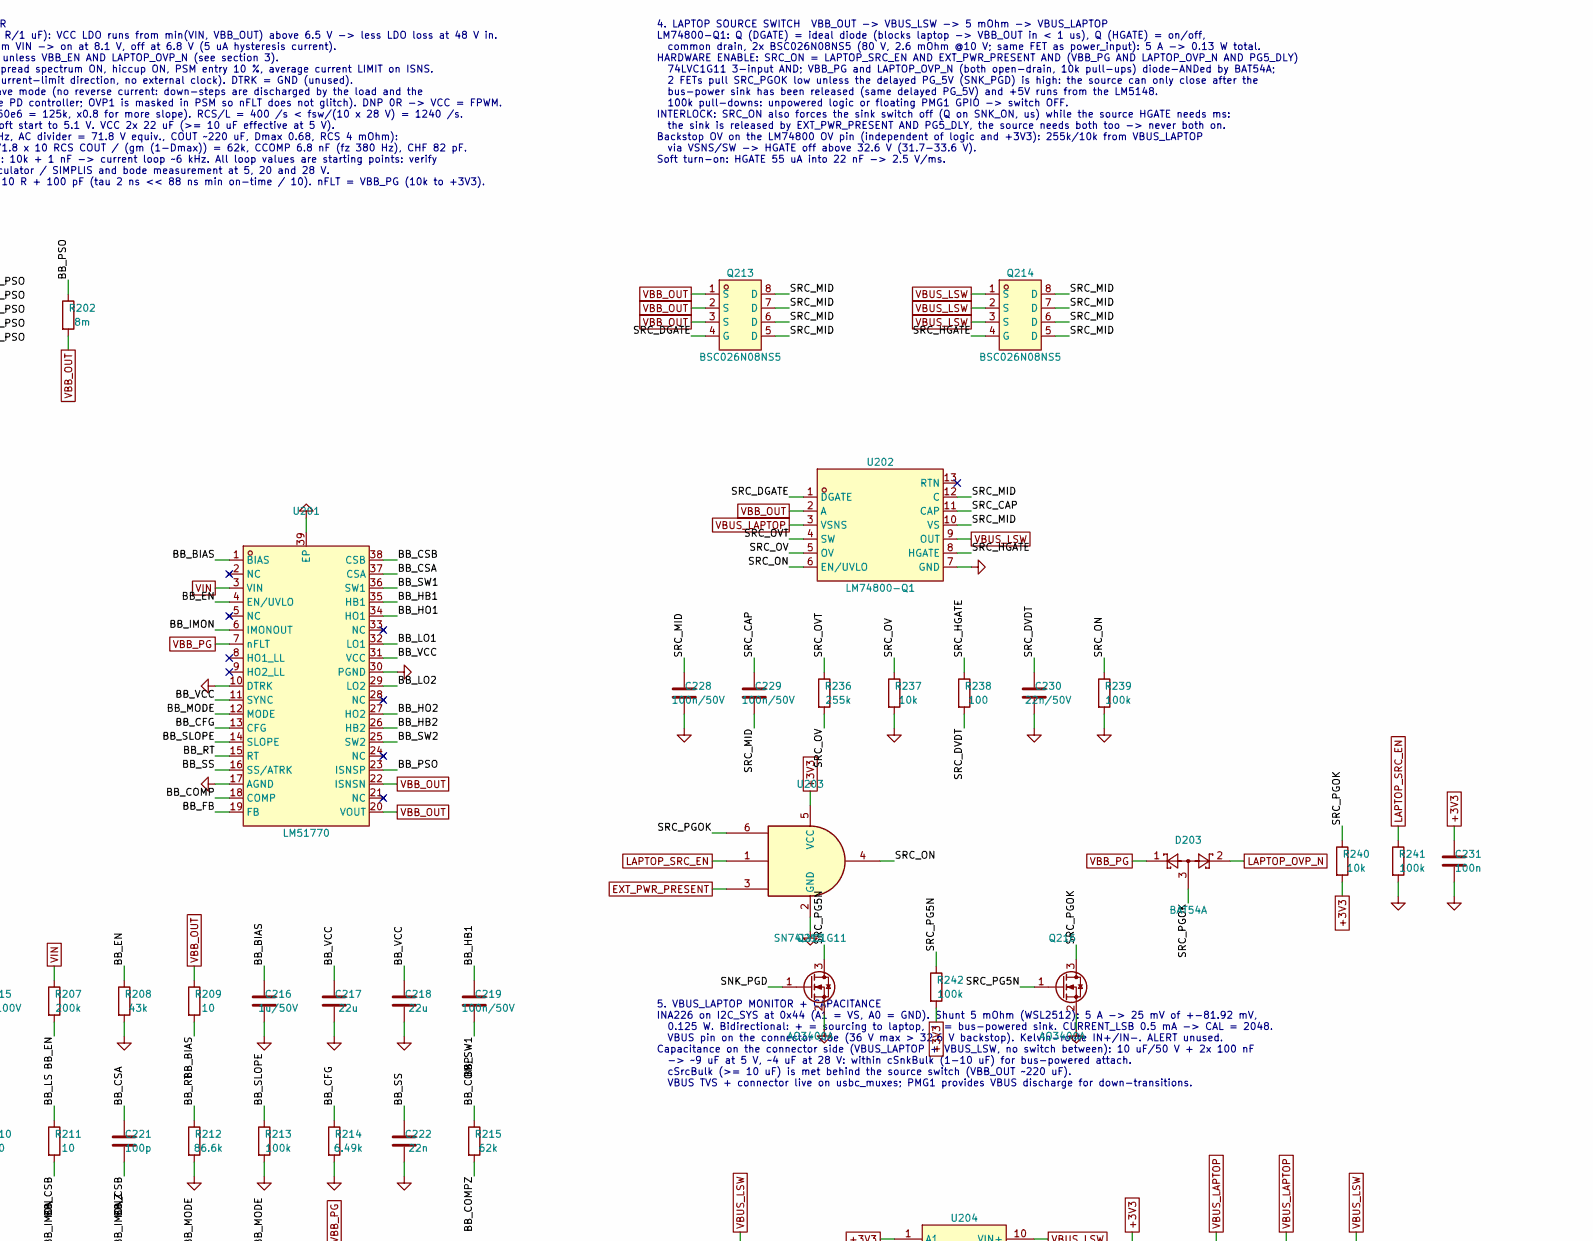
[picture p21: schematic power_laptop.kicad_sch, odock-10 — Laptop power (buck-boost, source/sink switches, …, part in row 1, column 2]

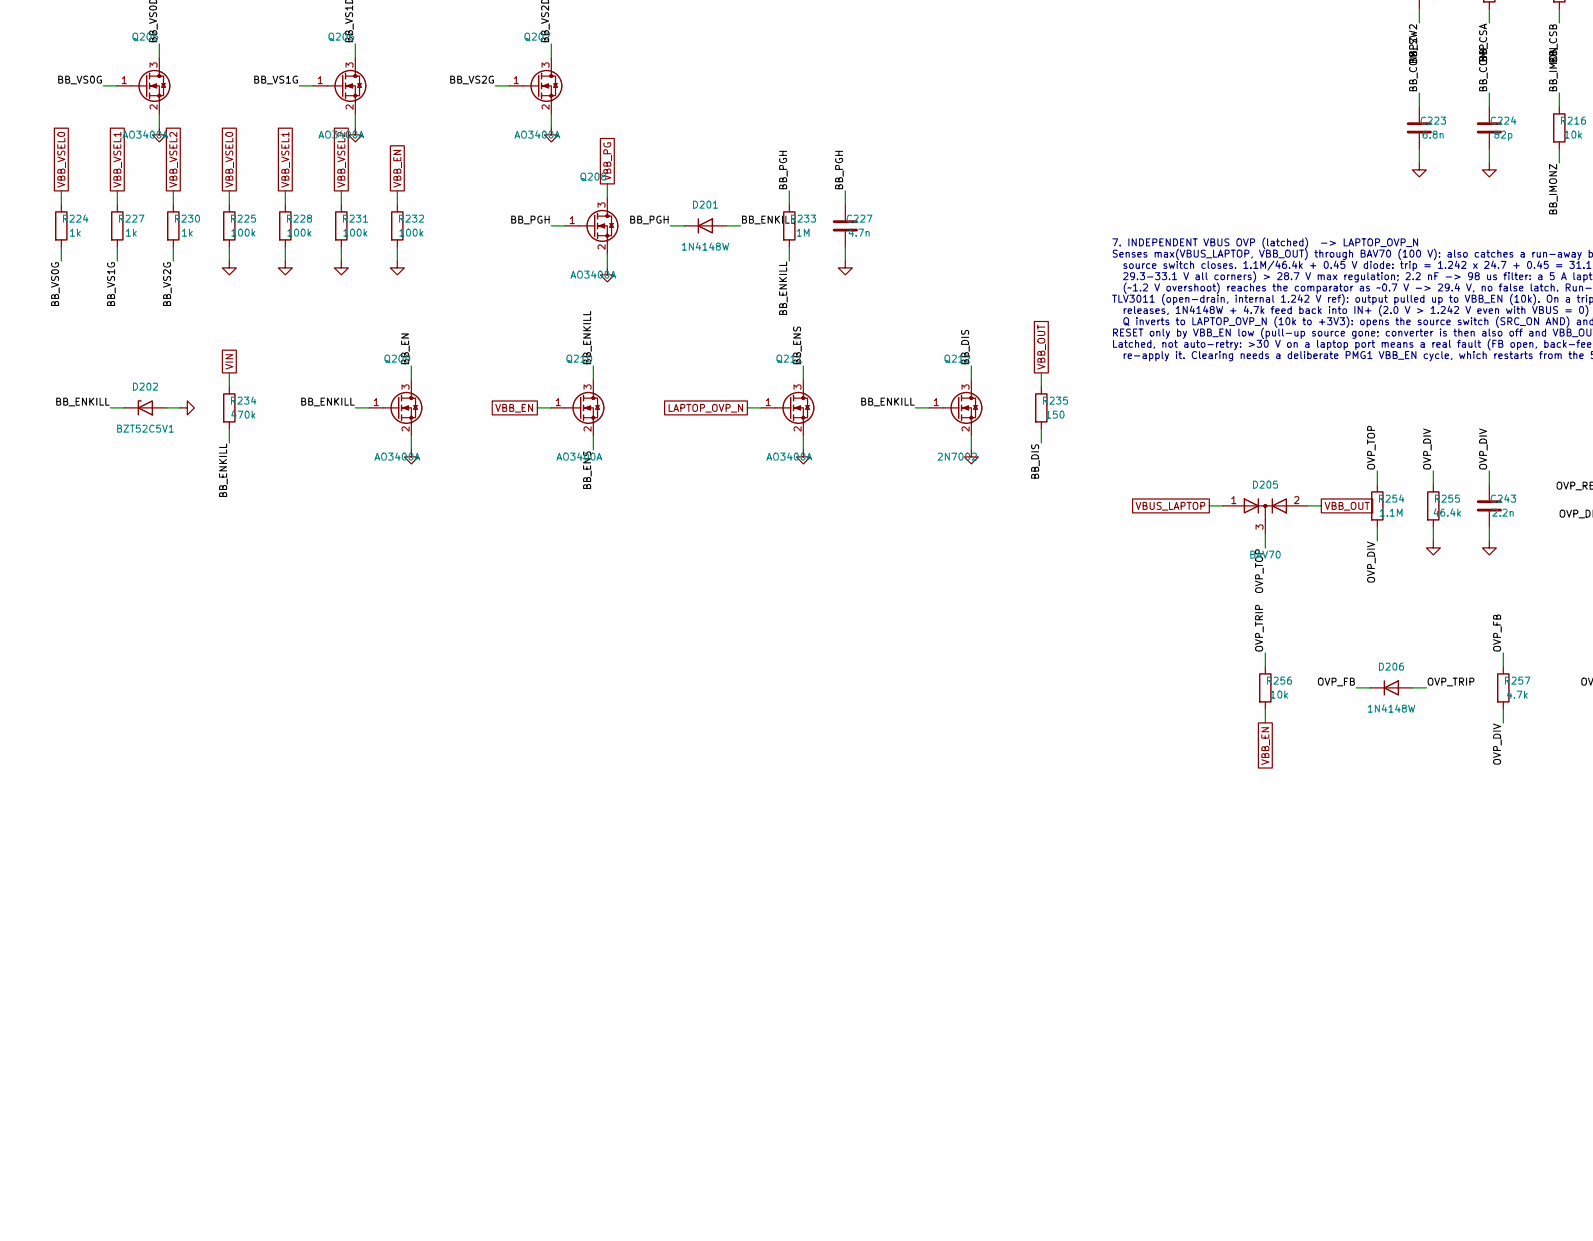
[picture p22: schematic power_laptop.kicad_sch, odock-10 — Laptop power (buck-boost, source/sink switches, …, part in row 2, column 1]

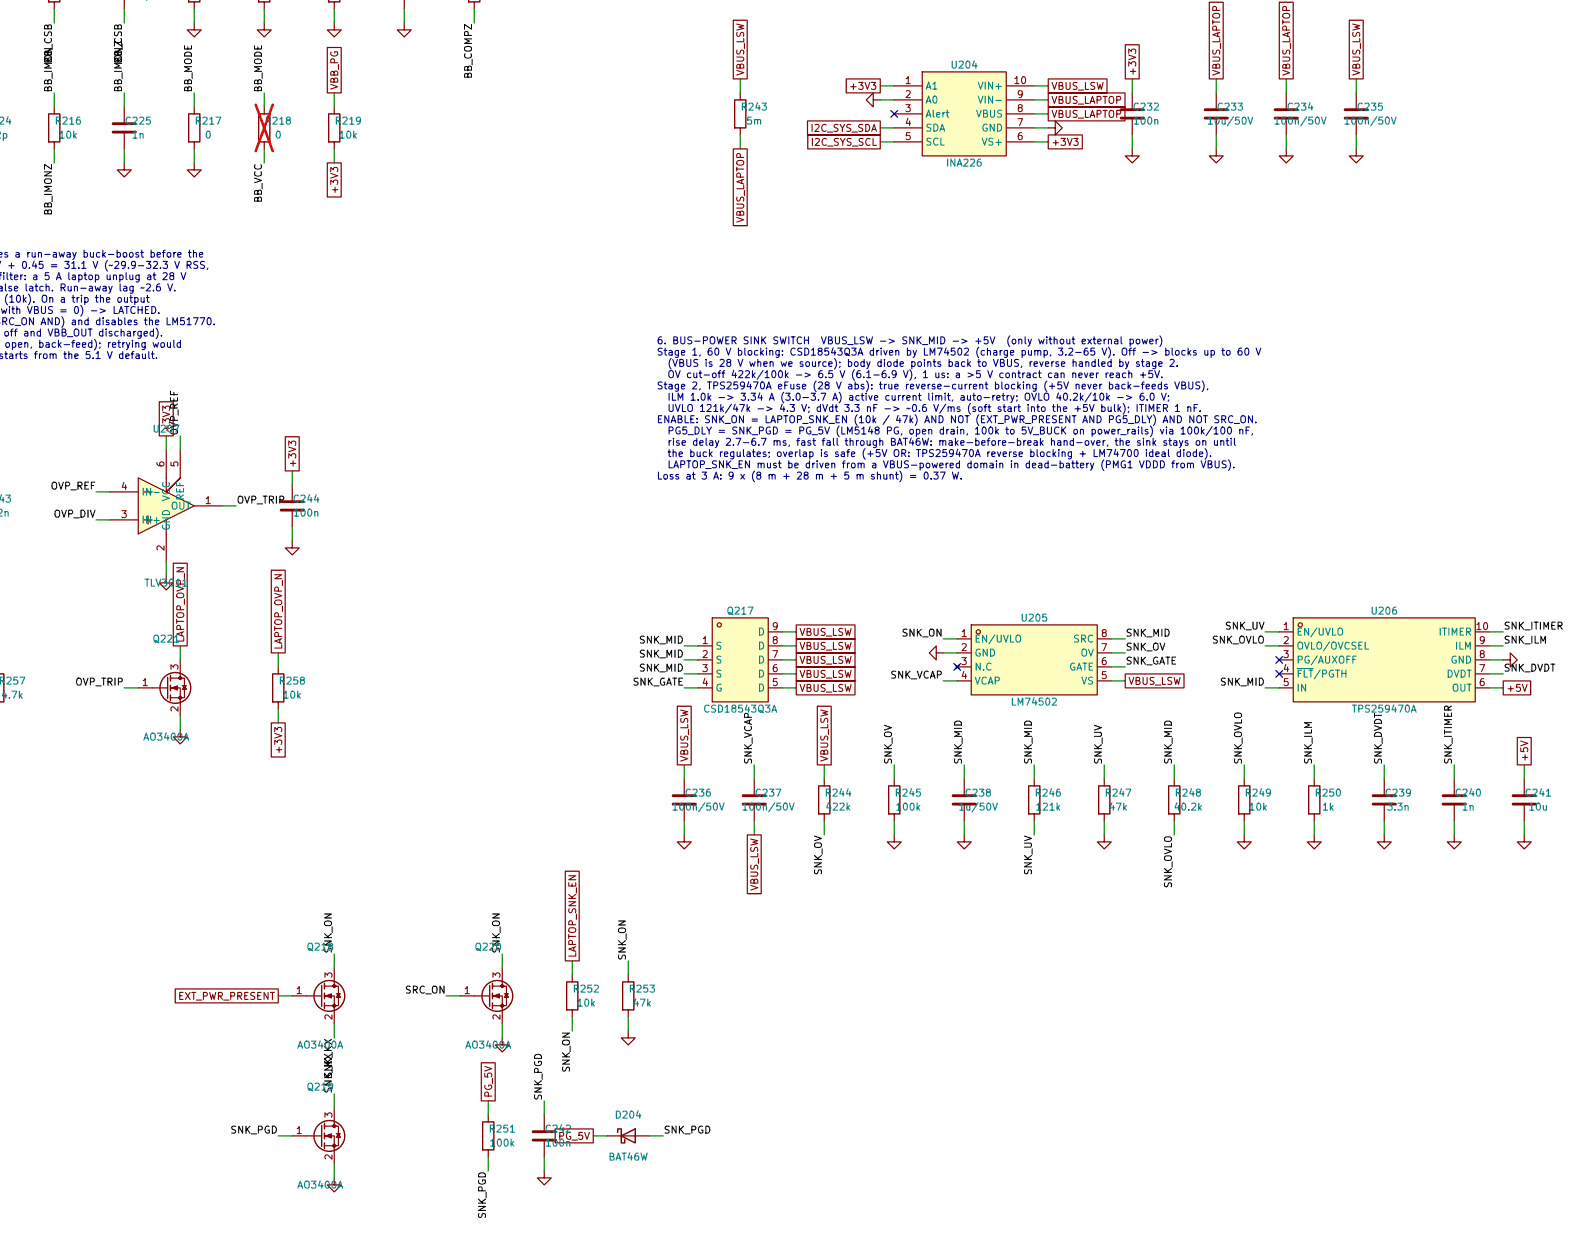
[picture p23: schematic power_laptop.kicad_sch, odock-10 — Laptop power (buck-boost, source/sink switches, …, part in row 2, column 2]

Parts:
C201, C202, C203, C204: 4.7u/100V; C_1210_3225Metric; LCSC C697607
C205, C206, C207, C208, C209, C210, C233: 10u/50V; C_1210_3225Metric; LCSC C432929
C211, C212: 100u/35V; CP_Elec_6.3x7.7; LCSC C2982822
C213, C219, C220, C228, C229, C234, C235, C236, C237: 100n/50V; C_0603_1608Metric; LCSC C14663
C214: 100n/100V; C_0805_2012Metric; LCSC C28233
C215: 1u/100V; C_0805_2012Metric; LCSC C126585
C216, C238: 1u/50V; C_0603_1608Metric; LCSC C15849
C217, C218: 22u; C_0805_2012Metric; LCSC C45783
C221: 100p; C_0402_1005Metric; LCSC C1546
C222: 22n; C_0402_1005Metric; LCSC C1532
C223: 6.8n; C_0603_1608Metric; LCSC C1631
C224: 82p; C_0402_1005Metric; LCSC C45501
C225, C240: 1n; C_0402_1005Metric; LCSC C1523
C226: 4.7u; C_0603_1608Metric; LCSC C19666
C227: 4.7n; C_0402_1005Metric; LCSC C1538
C230: 22n/50V; C_0603_1608Metric; LCSC C21122
C231, C232, C242, C244: 100n; C_0402_1005Metric; LCSC C1525
C239: 3.3n; C_0603_1608Metric; LCSC C1613
C241: 10u; C_0805_2012Metric; LCSC C15850
C243: 2.2n; C_0603_1608Metric; LCSC C1604
D201, D206: 1N4148W; D_SOD-123; LCSC C81598
D202: BZT52C5V1; D_SOD-123; LCSC C173407
D203: BAT54A; SOT-23; LCSC C130910
D204: BAT46W; D_SOD-123; LCSC C83152
D205: BAV70; SOT-23; LCSC C68978
L201: 10u; IND-SMD_L11.3-W10.0_XAL1010-332ME; MPN XAL1010-103MED; LCSC C6358489
Q201, Q202: BSC0805LS; PG-TDSON-8_L5.2-W5.9-P1.27-LS6.2-BL-EP; MPN BSC0805LS; LCSC C534374
Q203, Q204, Q217: CSD18543Q3A; VSONP-8_L3.1-W3.1-P0.65-LS3.5-BL; MPN CSD18543Q3A; LCSC C840100
Q205, Q206, Q207, Q208, Q209, Q210, Q211, Q215, Q216, Q218, Q219, Q220, Q221: AO3400A; SOT-23; LCSC C20917
Q212: 2N7002; SOT-23; LCSC C8545
Q213, Q214: BSC026N08NS5; PG-TDSON-8_L5.0-W6.0-P1.27-BL-EP; MPN BSC026N08NS5ATMA1; LCSC C5955453
R201: 4m; R_2512_6332Metric; MPN RLP25FEGR004; LCSC C459681
R202: 8m; R_2512_6332Metric; MPN PE2512FKE070R008L; LCSC C2075410
R203, R204, R205, R206, R217: 0; R_0402_1005Metric; LCSC C17168
R207: 200k; R_0805_2012Metric; LCSC C17539
R208: 43k; R_0402_1005Metric; LCSC C8329
R209: 10; R_0603_1608Metric; LCSC C22859
R210, R211: 10; R_0402_1005Metric; LCSC C25077
R212: 86.6k; R_0402_1005Metric; LCSC C48533697
R213, R220, R225, R228, R231, R232, R239, R241, R242, R245, R251: 100k; R_0402_1005Metric; LCSC C25741
R214: 6.49k; R_0402_1005Metric; LCSC C2998055
R215: 62k; R_0402_1005Metric; LCSC C2909375
R216, R219, R237, R240, R249, R252, R256, R258: 10k; R_0402_1005Metric; LCSC C25744
R218: 0; R_0402_1005Metric; LCSC C17168; not fitted
R221, R223: 24.3k; R_0402_1005Metric; LCSC C26969
R222: 1.5k; R_0402_1005Metric; LCSC C25867
R224, R227, R230, R250: 1k; R_0402_1005Metric; LCSC C11702
R226: 8.66k; R_0402_1005Metric; LCSC C5126133
R229: 5.23k; R_0402_1005Metric; LCSC C2933105
R233: 1M; R_0402_1005Metric; LCSC C26083
R234: 470k; R_0805_2012Metric; LCSC C17709
R235: 150; R_2512_6332Metric; LCSC C2934049
R236: 255k; R_0402_1005Metric; LCSC C270623
R238: 100; R_0402_1005Metric; LCSC C25076
R243: 5m; R_1206_3216Metric; MPN RLM12FTCMR005; LCSC C316225
R244: 422k; R_0402_1005Metric; LCSC C477738
R246: 121k; R_0402_1005Metric; LCSC C11693
R247, R253: 47k; R_0402_1005Metric; LCSC C25792
R248: 40.2k; R_0402_1005Metric; LCSC C25893
R254: 1.1M; R_0402_1005Metric; LCSC C133039
R255: 46.4k; R_0402_1005Metric; LCSC C5126026
R257: 4.7k; R_0402_1005Metric; LCSC C25900
U201: LM51770; HTSSOP-38_L9.7-W4.4-P0.50-LS6.4-BL-EP; MPN LM51770DCPR; LCSC C43351171
U202: LM74800-Q1; WSON-12_L3.0-W3.0-P0.50-TL-EP-2; MPN LM74800QDRRRQ1; LCSC C3215600
U203: SN74LVC1G11; SOT-23-6; LCSC C22046
U204: INA226; MSOP-10_L3.0-W3.0-P0.50-LS5.0-BL; MPN INA226AIDGSR; LCSC C49851
U205: LM74502; SOT-23-8_L2.9-W1.6-P0.65-LS2.8-BL; MPN LM74502DDFR; LCSC C3236215
U206: TPS259470A; VQFN-10_L2.0-W2.0-P0.45-TL; MPN TPS259470ARPWR; LCSC C3662799
U207: TLV3011; SOT-23-6_L2.9-W1.6-P0.95-LS2.8-BR; MPN TLV3011AIDBVR; LCSC C2870632

Connections:
+3V3: C231.1, C232.1, C244.1, R219.2, R240.2, R242.2, R258.2, U203.5 (VCC), U204.1 (A1), U204.6 (VS+), U207.6 (VCC); also elsewhere on the board
+5V: C241.1, U206.6 (OUT); also elsewhere on the board
/Laptop power out/BB_BIAS: C216.1, R209.2, U201.1 (BIAS)
/Laptop power out/BB_CFG: R214.1, U201.13 (CFG)
/Laptop power out/BB_COMP: C224.1, R215.1, U201.18 (COMP)
/Laptop power out/BB_COMPZ: C223.1, R215.2
/Laptop power out/BB_CSA: C221.1, R210.2, U201.37 (CSA)
/Laptop power out/BB_CSB: C221.2, R211.2, U201.38 (CSB)
/Laptop power out/BB_DIS: Q212.3 (D), R235.2
/Laptop power out/BB_EN: Q209.3 (D), R207.2, R208.1, U201.4 (EN/UVLO)
/Laptop power out/BB_ENKILL: D201.2 (A), D202.1 (K), Q209.1 (G), Q210.3 (D), Q212.1 (G), R233.2, R234.2
/Laptop power out/BB_ENS: Q210.2 (S), Q211.3 (D)
/Laptop power out/BB_FB: R220.2, R221.1, R222.1, U201.19 (FB)
/Laptop power out/BB_FBM: C226.1, R222.2, R223.1, R226.1, R229.1
/Laptop power out/BB_G1: Q201.4 (G), R203.2
/Laptop power out/BB_G2: Q202.4 (G), R204.2
/Laptop power out/BB_G3: Q203.4 (G), R205.2
/Laptop power out/BB_G4: Q204.4 (G), R206.2
/Laptop power out/BB_HB1: C219.1, U201.35 (HB1)
/Laptop power out/BB_HB2: C220.1, U201.26 (HB2)
/Laptop power out/BB_HO1: R203.1, U201.34 (HO1)
/Laptop power out/BB_HO2: R206.1, U201.27 (HO2)
/Laptop power out/BB_IMON: R216.1, U201.6 (IMONOUT)
/Laptop power out/BB_IMONZ: C225.1, R216.2
/Laptop power out/BB_LO1: R204.1, U201.32 (LO1)
/Laptop power out/BB_LO2: R205.1, U201.29 (LO2)
/Laptop power out/BB_LS: L201.1, R201.2, R211.1
/Laptop power out/BB_MODE: R217.1, R218.1, U201.12 (MODE)
/Laptop power out/BB_PGH: C227.1, D201.1 (K), Q208.1 (G), R233.1
/Laptop power out/BB_PSO: C205.1, C206.1, C207.1, C208.1, Q204.5 (D), Q204.6 (D), Q204.7 (D), Q204.8 (D), Q204.9 (D), R202.1, U201.23 (ISNSP)
/Laptop power out/BB_RT: R212.1, U201.15 (RT)
/Laptop power out/BB_SLOPE: R213.1, U201.14 (SLOPE)
/Laptop power out/BB_SS: C222.1, U201.16 (SS/ATRK)
/Laptop power out/BB_SW1: C219.2, Q201.1 (S), Q201.2 (S), Q201.3 (S), Q202.5 (D), Q202.6 (D), Q202.7 (D), Q202.8 (D), Q202.9 (EP), R201.1, R210.1, U201.36 (SW1)
/Laptop power out/BB_SW2: C220.2, L201.2, Q203.5 (D), Q203.6 (D), Q203.7 (D), Q203.8 (D), Q203.9 (D), Q204.1 (S), Q204.2 (S), Q204.3 (S), U201.25 (SW2)
/Laptop power out/BB_VCC: C217.1, C218.1, R218.2, U201.11 (SYNC), U201.31 (VCC)
/Laptop power out/BB_VS0D: Q205.3 (D), R223.2
/Laptop power out/BB_VS0G: Q205.1 (G), R224.2
/Laptop power out/BB_VS1D: Q206.3 (D), R226.2
/Laptop power out/BB_VS1G: Q206.1 (G), R227.2
/Laptop power out/BB_VS2D: Q207.3 (D), R229.2
/Laptop power out/BB_VS2G: Q207.1 (G), R230.2
/Laptop power out/OVP_DIV: C243.1, R254.2, R255.1, R257.2, U207.3 (IN+)
/Laptop power out/OVP_FB: D206.1 (K), R257.1
/Laptop power out/OVP_REF: U207.4 (IN-), U207.5 (REF)
/Laptop power out/OVP_TOP: D205.3 (K), R254.1
/Laptop power out/OVP_TRIP: D206.2 (A), Q221.1 (G), R256.1, U207.1 (OUT)
/Laptop power out/SNK_DVDT: C239.1, U206.7 (DVDT)
/Laptop power out/SNK_GATE: Q217.4 (G), U205.6 (GATE)
/Laptop power out/SNK_ILM: R250.1, U206.9 (ILM)
/Laptop power out/SNK_ITIMER: C240.1, U206.10 (ITIMER)
/Laptop power out/SNK_KX: Q218.2 (S), Q219.3 (D)
/Laptop power out/SNK_MID: C238.1, Q217.1 (S), Q217.2 (S), Q217.3 (S), R246.1, R248.1, U205.8 (SRC), U206.5 (IN)
/Laptop power out/SNK_ON: Q218.3 (D), Q220.3 (D), R252.2, R253.1, U205.1 (EN/UVLO)
/Laptop power out/SNK_OV: R244.2, R245.1, U205.7 (OV)
/Laptop power out/SNK_OVLO: R248.2, R249.1, U206.2 (OVLO/OVCSEL)
/Laptop power out/SNK_PGD: C242.1, D204.2 (A), Q215.1 (G), Q219.1 (G), R251.2
/Laptop power out/SNK_UV: R246.2, R247.1, U206.1 (EN/UVLO)
/Laptop power out/SNK_VCAP: C237.1, U205.4 (VCAP)
/Laptop power out/SRC_CAP: C229.1, U202.11 (CAP)
/Laptop power out/SRC_DGATE: Q213.4 (G), U202.1 (DGATE)
/Laptop power out/SRC_DVDT: C230.1, R238.2
/Laptop power out/SRC_HGATE: Q214.4 (G), R238.1, U202.8 (HGATE)
/Laptop power out/SRC_MID: C228.1, C229.2, Q213.5 (D), Q213.6 (D), Q213.7 (D), Q213.8 (D), Q214.5 (D), Q214.6 (D), Q214.7 (D), Q214.8 (D), U202.10 (VS), U202.12 (C)
/Laptop power out/SRC_ON: Q220.1 (G), R239.1, U202.6 (EN/UVLO), U203.4
/Laptop power out/SRC_OV: R236.2, R237.1, U202.5 (OV)
/Laptop power out/SRC_OVT: R236.1, U202.4 (SW)
/Laptop power out/SRC_PG5N: Q215.3 (D), Q216.1 (G), R242.1
/Laptop power out/SRC_PGOK: D203.3, Q216.3 (D), R240.1, U203.6
EXT_PWR_PRESENT: Q218.1 (G), U203.3; also elsewhere on the board
GND: C201.2, C202.2, C203.2, C204.2, C205.2, C206.2, C207.2, C208.2, C209.2, C210.2, C211.2, C212.2, C213.2, C214.2, C215.2, C216.2, C217.2, C218.2, C222.2, C223.2, C224.2, C225.2, C226.2, C227.2, C228.2, C230.2, C231.2, C232.2, C233.2, C234.2, C235.2, C236.2, C238.2, C239.2, C240.2, C241.2, C242.2, C243.2, C244.2, D202.2 (A), Q202.1 (S), Q202.2 (S), Q202.3 (S), Q203.1 (S), Q203.2 (S), Q203.3 (S), Q205.2 (S), Q206.2 (S), Q207.2 (S), Q208.2 (S), Q209.2 (S), Q211.2 (S), Q212.2 (S), Q215.2 (S), Q216.2 (S), Q219.2 (S), Q220.2 (S), Q221.2 (S), R208.2, R212.2, R213.2, R214.2, R217.2, R221.2, R225.2, R228.2, R231.2, R232.2, R237.2, R239.2, R241.2, R245.2, R247.2, R249.2, R250.2, R253.2, R255.2, U201.10 (DTRK), U201.17 (AGND), U201.30 (PGND), U201.39 (EP), U202.7 (GND), U203.2 (GND), U204.2 (A0), U204.7 (GND), U205.2 (GND), U206.8 (GND), U207.2 (GND); also elsewhere on the board
I2C_SYS_SCL: U204.5 (SCL); also elsewhere on the board
I2C_SYS_SDA: U204.4 (SDA); also elsewhere on the board
LAPTOP_OVP_N: D203.2, Q211.1 (G), Q221.3 (D), R258.1; also elsewhere on the board
LAPTOP_SNK_EN: R252.1; also elsewhere on the board
LAPTOP_SRC_EN: R241.1, U203.1; also elsewhere on the board
PG_5V: D204.1 (K), R251.1; also elsewhere on the board
VBB_EN: Q210.1 (G), R232.1, R256.2; also elsewhere on the board
VBB_OUT: C209.1, C210.1, C211.1, C212.1, C213.1, D205.2 (A), Q213.1 (S), Q213.2 (S), Q213.3 (S), R202.2, R209.1, R220.1, R235.1, U201.20 (VOUT), U201.22 (ISNSN), U202.2 (A)
VBB_PG: D203.1, Q208.3 (D), R219.1, U201.7 (nFLT); also elsewhere on the board
VBB_VSEL0: R224.1, R225.1; also elsewhere on the board
VBB_VSEL1: R227.1, R228.1; also elsewhere on the board
VBB_VSEL2: R230.1, R231.1; also elsewhere on the board
VBUS_LAPTOP: C233.1, C234.1, D205.1 (A), R243.2, U202.3 (VSNS), U204.8 (VBUS), U204.9 (VIN-); also elsewhere on the board
VBUS_LSW: C235.1, C236.1, C237.2, Q214.1 (S), Q214.2 (S), Q214.3 (S), Q217.5 (D), Q217.6 (D), Q217.7 (D), Q217.8 (D), Q217.9 (D), R243.1, R244.1, U202.9 (OUT), U204.10 (VIN+), U205.5 (VS); also elsewhere on the board
VIN: C201.1, C202.1, C203.1, C204.1, C214.1, C215.1, Q201.5 (D), Q201.6 (D), Q201.7 (D), Q201.8 (D), Q201.9 (EP), R207.1, R234.1, U201.3 (VIN); also elsewhere on the board

Notes on the sheet:
1. LM51770 4-SWITCH BUCK-BOOST POWER STAGE VIN 9-50 V -> VBB_OUT 5.1/9/15/20/28 V, 5 A (140 W) fsw = 347 kHz (RT 86.6k). L = Coilcraft XAL1010-103 10 uH (Isat 17.5 A, 14.75 mOhm max). Ripple: 3.4 A p-p worst (48 V -> 28 V buck), 2.0 A (14 V -> 28 V boost). Input half-bridge: 2x BSC0805LS (100 V, 7.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
2. LM51770 CONTROLLER BIAS from VBB_OUT (10 R/1 uF): VCC LDO runs from min(VIN, VBB_OUT) above 6.5 V -> less LDO loss at 48 V in. EN/UVLO: 200k/43k from VIN -> on at 8.1 V, off at 6.8 V (5 uA hysteresis current). Q pulls EN/UVLO low unless VBB_EN AND LAPTOP_OVP_N (see section 3). CFG 6.49k = R2D #7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
3. OUTPUT VOLTAGE SELECT (PMG1 GPIOs only; RP2350 has no path here) VOUT = 1 V x (1 + Rtop x Gfb). Rtop 100k, Rbot 24.3k -> 5.115 V with all VSEL low (default, no firmware). Switched branches hang off node BB_FBM, which connects to FB through Rs = 1.5k and is held by Cm = 4.7 uF: any VSEL change (e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
4. LAPTOP SOURCE SWITCH VBB_OUT -> VBUS_LSW -> 5 mOhm -> VBUS_LAPTOP LM74800-Q1: Q (DGATE) = ideal diode (blocks laptop -> VBB_OUT in < 1 us), Q (HGATE) = on/off, common drain, 2x BSC026N08NS5 (80 V, 2.6 mOhm @10 V; same FET as power_input): 5 A -> 0.13 W total. HARDWARE ENABLE: SRC_ON = LAPTOP_SRC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
5. VBUS_LAPTOP MONITOR + CAPACITANCE INA226 on I2C_SYS at 0x44 (A1 = VS, A0 = GND). Shunt 5 mOhm (WSL2512): 5 A -> 25 mV of +-81.92 mV, 0.125 W. Bidirectional: + = sourcing to laptop, - = bus-powered sink. CURRENT_LSB 0.5 mA -> CAL = 2048. VBUS pin on the connector side (36 V max > 32.6 V backstop)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
6. BUS-POWER SINK SWITCH VBUS_LSW -> SNK_MID -> +5V (only without external power) Stage 1, 60 V blocking: CSD18543Q3A driven by LM74502 (charge pump, 3.2-65 V). Off -> blocks up to 60 V (VBUS is 28 V when we source); body diode points back to VBUS, reverse handled by stage 2. OV cut-off 422k/100k -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
7. INDEPENDENT VBUS OVP (latched) -> LAPTOP_OVP_N Senses max(VBUS_LAPTOP, VBB_OUT) through BAV70 (100 V): also catches a run-away buck-boost before the source switch closes. 1.1M/46.4k + 0.45 V diode: trip = 1.242 x 24.7 + 0.45 = 31.1 V (~29.9-32.3 V RSS, 29.3-33.1 V all corners) > 28.7 V max regul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
