KarpelesLab/odock/hardware/odock-10/odock-10.kicad_pcb

## KiCad design hardware/odock-10/odock-10.kicad_pcb (continued)

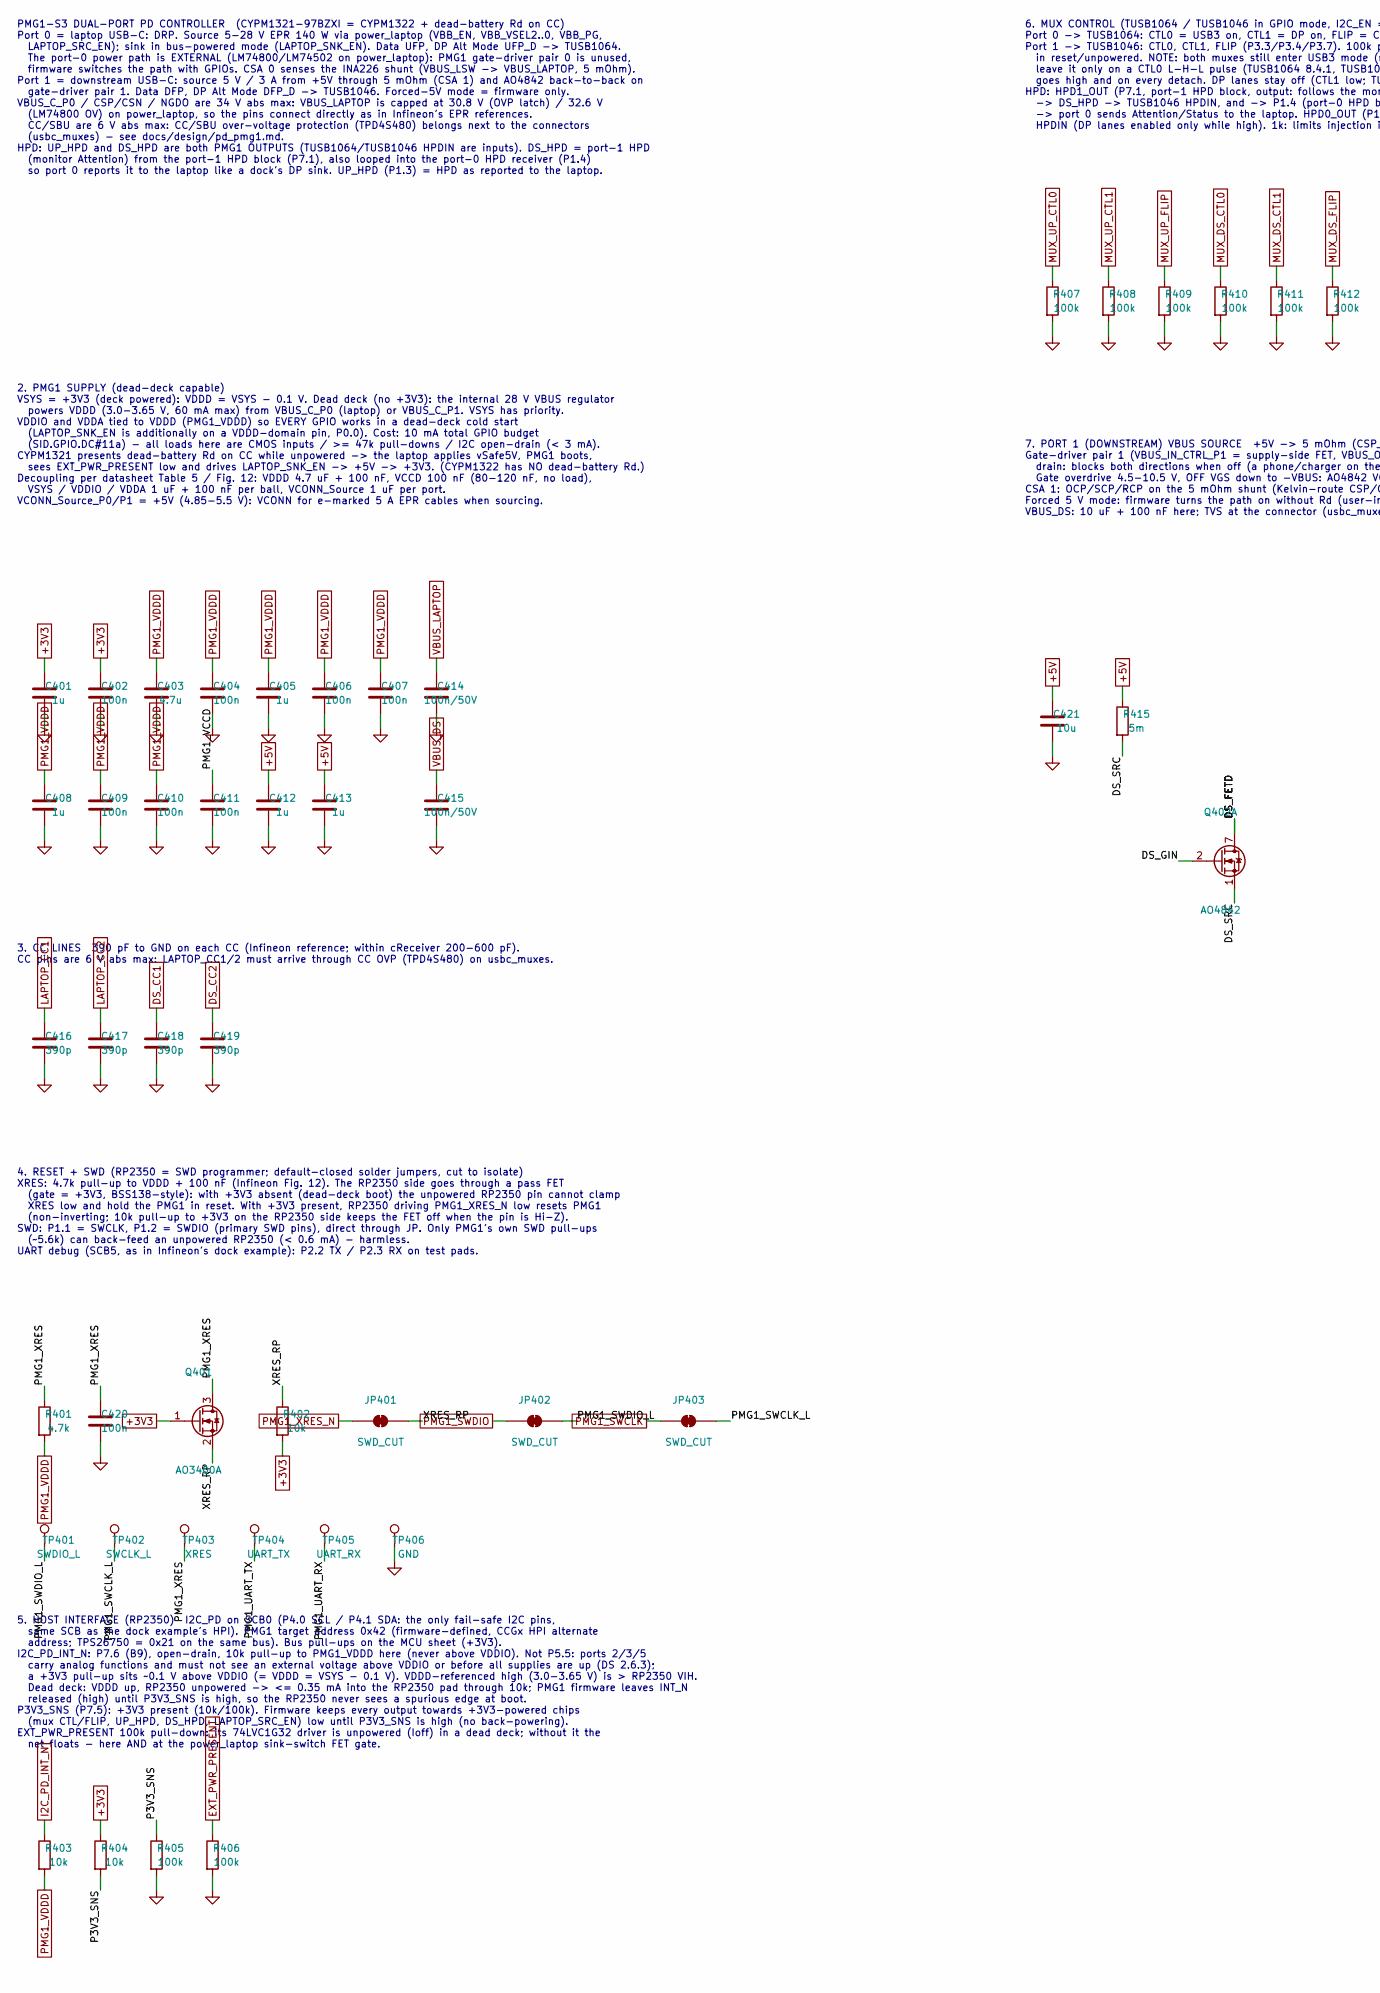
[picture p27: schematic pd_pmg1.kicad_sch, odock-10 — PD controller PMG1-S3 (laptop + downstream USB-C), part in row 1, column 1]

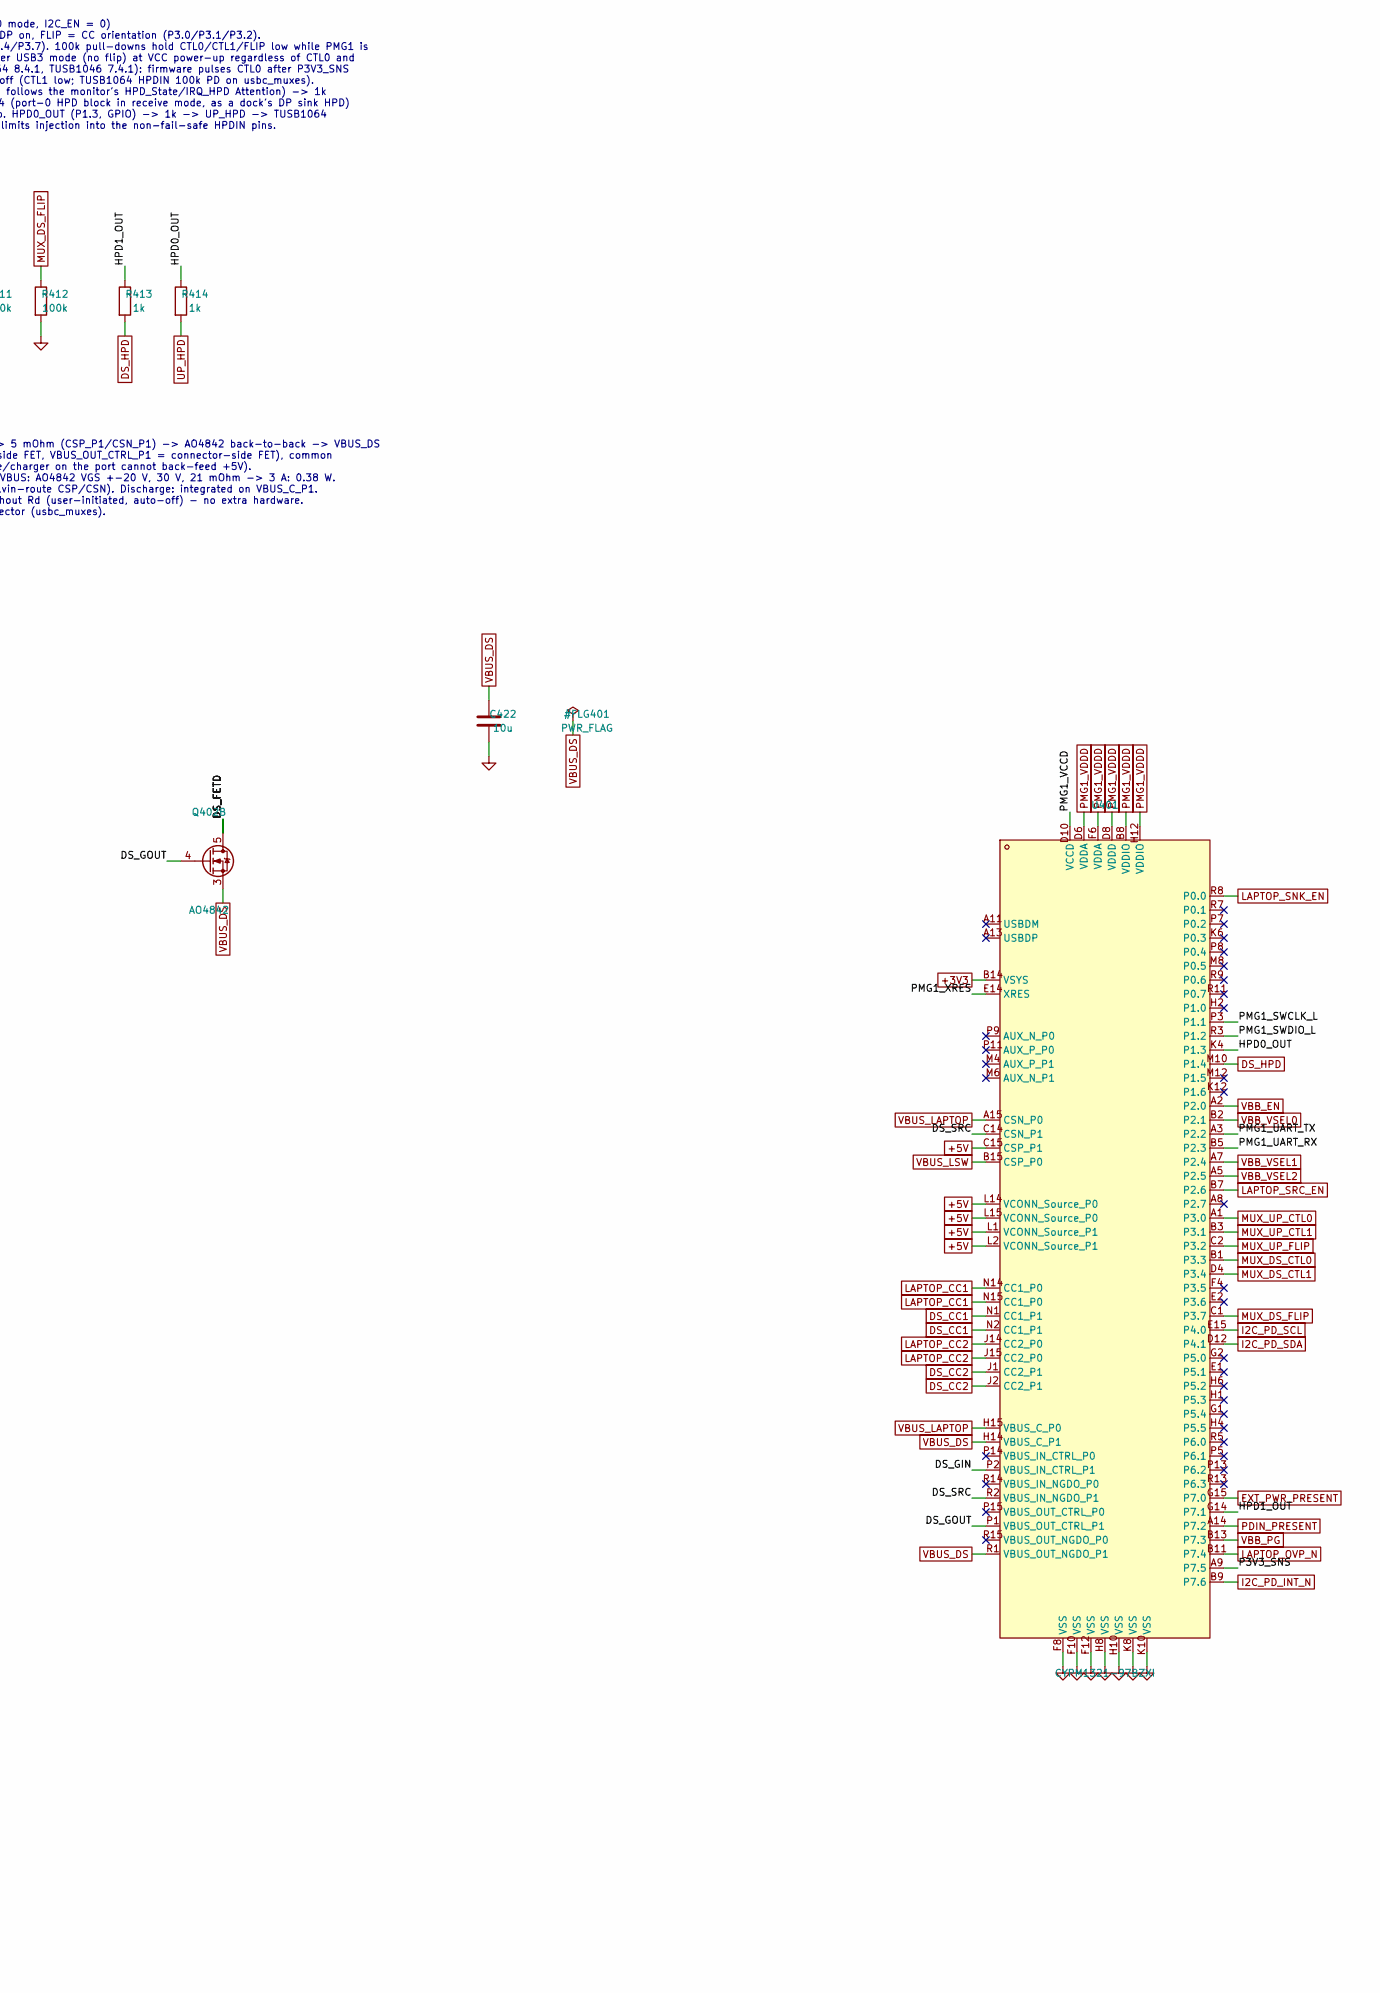
[picture p28: schematic pd_pmg1.kicad_sch, odock-10 — PD controller PMG1-S3 (laptop + downstream USB-C), part in row 1, column 2]

Parts:
C401, C405, C408, C412, C413: 1u; C_0402_1005Metric; LCSC C52923
C402, C404, C406, C407, C409, C410, C411, C420: 100n; C_0402_1005Metric; LCSC C1525
C403: 4.7u; C_0603_1608Metric; LCSC C19666
C414, C415: 100n/50V; C_0603_1608Metric; LCSC C14663
C416, C417, C418, C419: 390p; C_0402_1005Metric; LCSC C282239
C421, C422: 10u; C_0805_2012Metric; LCSC C15850
JP401, JP402, JP403: SWD_CUT; SolderJumper-2_P1.3mm_Bridged_RoundedPad1.0x1.5mm
Q401: AO3400A; SOT-23; LCSC C20917
Q402: AO4842; SOIC-8_3.9x4.9mm_P1.27mm; LCSC C427016
R401: 4.7k; R_0402_1005Metric; LCSC C25900
R402, R403, R404: 10k; R_0402_1005Metric; LCSC C25744
R405, R406, R407, R408, R409, R410, R411, R412: 100k; R_0402_1005Metric; LCSC C25741
R413, R414: 1k; R_0402_1005Metric; LCSC C11702
R415: 5m; R_1206_3216Metric; MPN RLM12FTCMR005; LCSC C316225
TP401: SWDIO_L; TestPoint_Pad_D1.0mm
TP402: SWCLK_L; TestPoint_Pad_D1.0mm
TP403: XRES; TestPoint_Pad_D1.0mm
TP404: UART_TX; TestPoint_Pad_D1.0mm
TP405: UART_RX; TestPoint_Pad_D1.0mm
TP406: GND; TestPoint_Pad_D1.0mm
U401: CYPM1321-97BZXI; BGA-97_L6.0-W6.0-P0.50-TL_CYPD8225-97BZXIT; MPN CYPM1321-97BZXIT; LCSC C20190828

Connections:
+3V3: C401.1, C402.1, Q401.1 (G), R402.2, R404.1, U401.B14 (VSYS); also elsewhere on the board
+5V: C412.1, C413.1, C421.1, R415.1, U401.C15 (CSP_P1), U401.L1 (VCONN_Source_P1), U401.L2 (VCONN_Source_P1), U401.L14 (VCONN_Source_P0), U401.L15 (VCONN_Source_P0); also elsewhere on the board
/PD controller/DS_FETD: Q402.5 (D2), Q402.6 (D2), Q402.7 (D1), Q402.8 (D1)
/PD controller/DS_GIN: Q402.2 (G1), U401.P2 (VBUS_IN_CTRL_P1)
/PD controller/DS_GOUT: Q402.4 (G2), U401.P1 (VBUS_OUT_CTRL_P1)
/PD controller/DS_SRC: Q402.1 (S1), R415.2, U401.C14 (CSN_P1), U401.R2 (VBUS_IN_NGDO_P1)
/PD controller/HPD0_OUT: R414.1, U401.K4 (P1.3)
/PD controller/HPD1_OUT: R413.1, U401.G14 (P7.1)
/PD controller/P3V3_SNS: R404.2, R405.1, U401.A9 (P7.5)
/PD controller/PMG1_SWCLK_L: JP403.2 (B), TP402.1, U401.P3 (P1.1)
/PD controller/PMG1_SWDIO_L: JP402.2 (B), TP401.1, U401.R3 (P1.2)
/PD controller/PMG1_UART_RX: TP405.1, U401.B5 (P2.3)
/PD controller/PMG1_UART_TX: TP404.1, U401.A3 (P2.2)
/PD controller/PMG1_VCCD: C411.1, U401.D10 (VCCD)
/PD controller/PMG1_XRES: C420.1, Q401.3 (D), R401.1, TP403.1, U401.E14 (XRES)
/PD controller/XRES_RP: JP401.2 (B), Q401.2 (S), R402.1
DS_CC1: C418.1, U401.N1 (CC1_P1), U401.N2 (CC1_P1); also elsewhere on the board
DS_CC2: C419.1, U401.J1 (CC2_P1), U401.J2 (CC2_P1); also elsewhere on the board
DS_HPD: R413.2, U401.M10 (P1.4); also elsewhere on the board
EXT_PWR_PRESENT: R406.1, U401.G15 (P7.0); also elsewhere on the board
GND: C401.2, C402.2, C403.2, C404.2, C405.2, C406.2, C407.2, C408.2, C409.2, C410.2, C411.2, C412.2, C413.2, C414.2, C415.2, C416.2, C417.2, C418.2, C419.2, C420.2, C421.2, C422.2, R405.2, R406.2, R407.2, R408.2, R409.2, R410.2, R411.2, R412.2, TP406.1, U401.F8 (VSS), U401.F10 (VSS), U401.F12 (VSS), U401.H8 (VSS), U401.H10 (VSS), U401.K8 (VSS), U401.K10 (VSS); also elsewhere on the board
I2C_PD_INT_N: R403.1, U401.B9 (P7.6); also elsewhere on the board
I2C_PD_SCL: U401.E15 (P4.0); also elsewhere on the board
I2C_PD_SDA: U401.D12 (P4.1); also elsewhere on the board
LAPTOP_CC1: C416.1, U401.N14 (CC1_P0), U401.N15 (CC1_P0); also elsewhere on the board
LAPTOP_CC2: C417.1, U401.J14 (CC2_P0), U401.J15 (CC2_P0); also elsewhere on the board
LAPTOP_OVP_N: U401.B11 (P7.4); also elsewhere on the board
LAPTOP_SNK_EN: U401.R8 (P0.0); also elsewhere on the board
LAPTOP_SRC_EN: U401.B7 (P2.6); also elsewhere on the board
MUX_DS_CTL0: R410.1, U401.B1 (P3.3); also elsewhere on the board
MUX_DS_CTL1: R411.1, U401.D4 (P3.4); also elsewhere on the board
MUX_DS_FLIP: R412.1, U401.C1 (P3.7); also elsewhere on the board
MUX_UP_CTL0: R407.1, U401.A1 (P3.0); also elsewhere on the board
MUX_UP_CTL1: R408.1, U401.B3 (P3.1); also elsewhere on the board
MUX_UP_FLIP: R409.1, U401.C2 (P3.2); also elsewhere on the board
PDIN_PRESENT: U401.A14 (P7.2); also elsewhere on the board
PMG1_SWCLK: JP403.1 (A); also elsewhere on the board
PMG1_SWDIO: JP402.1 (A); also elsewhere on the board
PMG1_VDDD: C403.1, C404.1, C405.1, C406.1, C407.1, C408.1, C409.1, C410.1, R401.2, R403.2, U401.B8 (VDDIO), U401.D6 (VDDA), U401.D8 (VDDD), U401.F6 (VDDA), U401.H12 (VDDIO); also elsewhere on the board
PMG1_XRES_N: JP401.1 (A); also elsewhere on the board
UP_HPD: R414.2; also elsewhere on the board
VBB_EN: U401.A2 (P2.0); also elsewhere on the board
VBB_PG: U401.B13 (P7.3); also elsewhere on the board
VBB_VSEL0: U401.B2 (P2.1); also elsewhere on the board
VBB_VSEL1: U401.A7 (P2.4); also elsewhere on the board
VBB_VSEL2: U401.A5 (P2.5); also elsewhere on the board
VBUS_DS: C415.1, C422.1, Q402.3 (S2), U401.H14 (VBUS_C_P1), U401.R1 (VBUS_OUT_NGDO_P1); also elsewhere on the board
VBUS_LAPTOP: C414.1, U401.A15 (CSN_P0), U401.H15 (VBUS_C_P0); also elsewhere on the board
VBUS_LSW: U401.B15 (CSP_P0); also elsewhere on the board

Notes on the sheet:
PMG1-S3 DUAL-PORT PD CONTROLLER (CYPM1321-97BZXI = CYPM1322 + dead-battery Rd on CC) Port 0 = laptop USB-C: DRP. Source 5-28 V EPR 140 W via power_laptop (VBB_EN, VBB_VSEL2..0, VBB_PG, LAPTOP_SRC_EN); sink in bus-powered mode (LAPTOP_SNK_EN). Data UFP, DP Alt Mode UFP_D -> TUSB1064. The port-0 powe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
2. PMG1 SUPPLY (dead-deck capable) VSYS = +3V3 (deck powered): VDDD = VSYS - 0.1 V. Dead deck (no +3V3): the internal 28 V VBUS regulator powers VDDD (3.0-3.65 V, 60 mA max) from VBUS_C_P0 (laptop) or VBUS_C_P1. VSYS has priority. VDDIO and VDDA tied to VDDD (PMG1_VDDD) so EVERY GPIO works in a dea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
3. CC LINES 390 pF to GND on each CC (Infineon reference; within cReceiver 200-600 pF). CC pins are 6 V abs max: LAPTOP_CC1/2 must arrive through CC OVP (TPD4S480) on usbc_muxes.
4. RESET + SWD (RP2350 = SWD programmer; default-closed solder jumpers, cut to isolate) XRES: 4.7k pull-up to VDDD + 100 nF (Infineon Fig. 12). The RP2350 side goes through a pass FET (gate = +3V3, BSS138-style): with +3V3 absent (dead-deck boot) the unpowered RP2350 pin cannot clamp XRES low and h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
5. HOST INTERFACE (RP2350) I2C_PD on SCB0 (P4.0 SCL / P4.1 SDA: the only fail-safe I2C pins, same SCB as the dock example's HPI). PMG1 target address 0x42 (firmware-defined, CCGx HPI alternate address; TPS26750 = 0x21 on the same bus). Bus pull-ups on the MCU sheet (+3V3). I2C_PD_INT_N: P7.6 (B9), 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
6. MUX CONTROL (TUSB1064 / TUSB1046 in GPIO mode, I2C_EN = 0) Port 0 -> TUSB1064: CTL0 = USB3 on, CTL1 = DP on, FLIP = CC orientation (P3.0/P3.1/P3.2). Port 1 -> TUSB1046: CTL0, CTL1, FLIP (P3.3/P3.4/P3.7). 100k pull-downs hold CTL0/CTL1/FLIP low while PMG1 is in reset/unpowered. NOTE: both muxes s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
7. PORT 1 (DOWNSTREAM) VBUS SOURCE +5V -> 5 mOhm (CSP_P1/CSN_P1) -> AO4842 back-to-back -> VBUS_DS Gate-driver pair 1 (VBUS_IN_CTRL_P1 = supply-side FET, VBUS_OUT_CTRL_P1 = connector-side FET), common drain: blocks both directions when off (a phone/charger on the port cannot back-feed +5V). Gate ov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

Board: 6 copper layers, 801 parts (493 on the bottom side), 531 nets, no tracks yet.

Other parts of the board:
H1, H2, H3, H4: MountingHole_3.2mm_M3_Pad_Via
