KarpelesLab/odock/hardware/odock-10/routing/g_front.py

"""odock-10 routing, phase g: front block local nets (card reader GL3224 + SD/microSD, USB-A port electronics).

NETS = [] / GROUPED: everything drawn here lives in group "route:g_front"; only that group is replaced on re-run
(nets are shared with b_power / e_hs_eth_sd / f_fanout / z_stitch).

What is routed (see docs/routing-notes/g_front.md):
- U901 (GL3224, bottom) local pins: CR_3V3 / CR_1V2 LDO rails to their caps and to each other, VUHS1/2, crystal
  (XI/XO <= 4 mm, B.Cu), straps, LED, SD detect / WP (via d_hs_hub's reserved toe vias), microSD CDZ and the
  CR_USD_VCC run to J902 (B.Cu south of the USB-A shell tabs, clear of the L3 microSD band).
- USB-A ports: SW_IN bulk/HF caps to the SW_IN node, EN (OR gate -> TPS2553 + pull-down), ILIM, INA180 output ->
  ISENSE filter, VBUS clamp (D702/D704 pin 5) to the +5V_USBAx pour, local +3V3 (OR gate / INA180) fed from the
  right block's L4 +3V3 plane.
- Unconnected supply pads in the region (GND C914.2 boxed in -> 0.351/0.15 via-in-pad like f_fanout's VIP).

The geometry below was generated by a grid A* router (0.025 mm grid, 0.15 mm clearance + 0.02 mm margin, 0.3 mm to
USB_90/HS_85 tracks and HV copper, region-clipped) run against the board after a_planes..f_fanout, then frozen here.
Each entry: (name, net, width, [(layer, [points])], [via points], (via size, drill)).
"""

NETS = []
GROUPED = True

ROUTES = [
    ('vuhs2', 'CR_VUHS2', 0.12, [('B', [(129.245, 116.3125), (128.92, 116.3125), (128.795, 116.4375), (127.7825, 116.4375), (127.4325, 116.0875)])], [], (0.45, 0.25)),
    ('3v3_c907', 'CR_3V3', 0.12, [('B', [(129.245, 115.675), (129.145, 115.675), (128.3575, 114.8875), (127.7825, 114.8875), (127.4325, 114.5375)])], [], (0.45, 0.25)),
    ('vuhs1', 'CR_VUHS1', 0.15, [('B', [(133.325, 113.75), (133.325, 112.8)])], [], (0.45, 0.25)),
    ('3v3_c908', 'CR_3V3', 0.2, [('B', [(133.8125, 113.75), (133.8125, 113.6375), (134.025, 113.425), (135.175, 113.425), (135.75, 112.85)])], [], (0.45, 0.25)),
    ('gnd_u901_3', 'GND', 0.2, [('B', [(136.05, 115.675), (135.5, 115.675)])], [], (0.45, 0.25)),
    ('3v3_c905', 'CR_3V3', 0.2, [('B', [(136.75, 117.25), (137.625, 117.25)])], [], (0.45, 0.25)),
    ('1v2_c909', 'CR_1V2', 0.2, [('B', [(136.75, 118.7), (137.625, 118.7)])], [], (0.45, 0.25)),
    ('1v2_c910', 'CR_1V2', 0.2, [('B', [(129.245, 119.75), (127.87, 119.75), (127.42, 120.2)])], [], (0.45, 0.25)),
    ('usd_cdz_pins', 'CR_USD_CDZ', 0.15, [('B', [(129.25, 115.15), (129.25, 114.825)])], [], (0.45, 0.25)),
    ('usd_cdz_via', 'CR_USD_CDZ', 0.15, [], [(129.55, 114.15)], (0.45, 0.25)),
    ('usd_cdz_stub', 'CR_USD_CDZ', 0.15, [('B', [(129.55, 114.65), (129.55, 114.15)])], [], (0.45, 0.25)),
    ('esc_21', 'CR_LED_IC', 0.15, [], [(132.45, 121.66)], (0.35, 0.15)),
    ('esc_21_stub', 'CR_LED_IC', 0.12, [('B', [(131.825, 121.225), (131.825, 121.325), (132.15, 121.65), (132.45, 121.65)])], [], (0.45, 0.25)),
    ('esc_19', 'CR_SPI_CK', 0.15, [], [(133.0, 121.66)], (0.35, 0.15)),
    ('esc_19_stub', 'CR_SPI_CK', 0.15, [('B', [(132.825, 121.225), (132.825, 121.475), (133.0, 121.65)])], [], (0.45, 0.25)),
    ('esc_17', 'CR_SPI_MISO', 0.15, [], [(133.62, 121.65)], (0.45, 0.25)),
    ('esc_17_stub', 'CR_SPI_MISO', 0.15, [('B', [(133.67, 121.225), (133.62, 121.275), (133.62, 121.65)])], [], (0.45, 0.25)),
    ('ch_R907', 'CR_LED_IC', 0.15, [], [(128.99, 129.2)], (0.45, 0.25)),
    ('ch_R907_stub', 'CR_LED_IC', 0.15, [('B', [(128.99, 129.78), (128.99, 129.2)])], [], (0.45, 0.25)),
    ('ch_R904', 'CR_SD_CDZ', 0.15, [], [(131.19, 129.2)], (0.45, 0.25)),
    ('ch_R904_stub', 'CR_SD_CDZ', 0.15, [('B', [(131.19, 129.78), (131.19, 129.2)])], [], (0.45, 0.25)),
    ('ch_R905', 'CR_USD_CDZ', 0.15, [], [(133.39, 129.2)], (0.45, 0.25)),
    ('ch_R905_stub', 'CR_USD_CDZ', 0.15, [('B', [(133.39, 129.78), (133.39, 129.2)])], [], (0.45, 0.25)),
    ('esc_cr_led', 'CR_LED', 0.15, [], [(135.16, 128.5)], (0.45, 0.25)),
    ('esc_cr_led_t', 'CR_LED', 0.15, [('B', [(134.41, 128.5), (135.16, 128.5)])], [], (0.45, 0.25)),
    ('esc_cd_usd', 'CR_CD_USD_N', 0.15, [], [(135.12, 129.2)], (0.45, 0.25)),
    ('esc_cd_usd_t', 'CR_CD_USD_N', 0.15, [('B', [(134.41, 130.0), (134.41, 129.91), (135.12, 129.2)])], [], (0.45, 0.25)),
    ('esc_cd_sd', 'CR_CD_SD_N', 0.15, [], [(135.85, 129.2)], (0.45, 0.25)),
    ('esc_cd_sd_t', 'CR_CD_SD_N', 0.15, [('B', [(132.41, 130.2), (132.785, 130.575), (134.71, 130.575), (135.86, 129.425), (135.86, 129.2)])], [], (0.45, 0.25)),
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
    ('esc_R710_2', 'USBA2_ISENSE', 0.15, [('B', [(175.21, 113.775), (175.51, 113.775)])], [(175.51, 113.775)], (0.45, 0.25)),
    ('esc_U704_4', 'USBA2_OCS_N', 0.15, [('F', [(164.475, 113.6), (164.4, 113.6), (162.7, 115.3), (162.7, 116.3)])], [(162.7, 116.3)], (0.45, 0.25)),
]


# Conditional routes: U901.16 (CR_RTERM) and U901.25 (CR_3V3, the 3.3 V LDO output) are boxed in by f_fanout's GND
# dog-bone vias of C906.2 (134.3, 121.72) and C910.2 (128.7, 120.3). These entries were computed as if those two pads
# used a 0.351/0.15 via-in-pad instead; each one is drawn only when no GND via sits at its blocking point any more.
COND = [
    ('cond_rterm_via', 'CR_RTERM', 0.15, [], [(134.3, 121.64)], (0.35, 0.15), [(134.3, 121.72)]),
    ('cond_rterm_stub', 'CR_RTERM', 0.15, [('B', [(134.3, 121.225), (134.3, 121.65)])], [], (0.45, 0.25), [(134.3, 121.72)]),
    ('cond_rterm', 'CR_RTERM', 0.15, [('F', [(134.3, 121.64), (134.875, 122.215), (134.875, 124.59), (133.0, 126.465)]), ('B', [(133.0, 126.465), (133.0, 126.165)])], [(133.0, 126.465)], (0.45, 0.25), [(134.3, 121.72)]),
    ('cond_3v3_25_via', 'CR_3V3', 0.15, [], [(128.8, 120.3)], (0.35, 0.15), [(128.7, 120.3)]),
    ('cond_3v3_25_stub', 'CR_3V3', 0.2, [('B', [(129.225, 120.275), (129.2, 120.3), (128.8, 120.3)])], [], (0.45, 0.25), [(128.7, 120.3)]),
    ('cond_3v3_25', 'CR_3V3', 0.2, [('L3', [(128.8, 120.3), (128.8, 121.5)]), ('B', [(128.8, 121.5), (128.8, 122.175)])], [(128.8, 121.5)], (0.45, 0.25), [(128.7, 120.3)]),
]

LAYER = {"F": "F.Cu", "L3": "In2.Cu", "B": "B.Cu"}


def _blocked(board, pts):
    import pcbnew
    for t in board.GetTracks():
        if t.GetClass() == "PCB_VIA" and t.GetNetname() == "GND":
            p = t.GetPosition()
            if any(abs(pcbnew.ToMM(p.x) - x) < 0.05 and abs(pcbnew.ToMM(p.y) - y) < 0.05 for x, y in pts):
                return True
    return False


def route(board, r):
    for name, net, w, segs, vias, (vd, vdrill) in ROUTES:
        for layer, pts in segs:
            r.track(net, pts, LAYER[layer], w)
        for x, y in vias:
            r.via(net, x, y, vd, vdrill)
    skipped = []
    for name, net, w, segs, vias, (vd, vdrill), block in COND:
        if _blocked(board, block):
            skipped.append(name)
            continue
        for layer, pts in segs:
            r.track(net, pts, LAYER[layer], w)
        for x, y in vias:
            r.via(net, x, y, vd, vdrill)
    if skipped:
        print("g_front: U901.16 / U901.25 still boxed in by f_fanout GND vias (C906.2 / C910.2) -> skipped", skipped)
