KarpelesLab/odock/(commit log)

2026-10-17 WIP routing phase g: region-local routing scripts (power, usbc, hubrails, front; right partial)
    - g_power 148/204, g_usbc 62/96, g_hubrails 65/76 local + 44/54 supply pads,
    g_front 45/47 local; each 0 DRC errors in the full a-f+g+z preview
    - g_right.py is a partial result from an interrupted agent
    - DRC: U401 added to HV pad exemptions; "via in pad" 0.12 mm rule for U501-U504
    - open items per region in docs/routing-notes/g_*.md
2026-10-17 Rename project odeck -> odock
    - GitHub repo renamed to KarpelesLab/odock (origin updated)
    - hardware/odeck-10 -> hardware/odock-10, odeck-10.kicad_* -> odock-10.kicad_*,
    docs/odeck-10.md -> docs/odock-10.md, renders renamed
    - library: odeck.kicad_sym/.pretty/.3dshapes -> odock.*, nickname odock:
    - all docs, tools and sheet sources updated; schematics regenerated
    - checks after rename: netlist verify OK, ERC clean, pcbsync 0 swaps,
    DRC 0 errors (unrouted only)
